Darexsh/mentoring_board_darexsh/Docs/Konzept_Hardware.md

### Konzept des Hardware-Teils des ESP32-S3-Mentoring-Board-Projekts

#### Zielsetzung
Die Hardware des ESP32-S3-Mentoring-Boards verfolgt das Ziel, eine umfassende und vielseitige Plattform zu schaffen, die Lernenden, Hobbyisten und Entwicklern ermöglicht, praktische Erfahrungen in der Mikrocontroller-Programmierung, Sensorintegration und Hardware-Software-Interaktion zu sammeln. Sie soll nicht nur als Lernwerkzeug dienen, sondern auch als Grundlage für die Entwicklung von Prototypen und realen Anwendungen. Dabei steht die Balance zwischen Einfachheit für Einsteiger und Flexibilität für fortgeschrittene Nutzer im Vordergrund. Die Hardware soll:
- Ein tiefes Verständnis für die Funktionsweise von Mikrocontrollern und Peripheriegeräten fördern,
- Eine Plattform für Experimente mit verschiedenen Sensoren und Aktoren bieten,
- Die Entwicklung von kreativen und funktionalen Projekten ermöglichen, die über den Lernkontext hinausgehen.

#### Kernidee
Die Kernidee der Hardware ist es, eine interaktive, flexible und robuste Umgebung zu schaffen, die eine Vielzahl von Komponenten integriert und gleichzeitig eine hohe Anpassungsfähigkeit bietet:
1. **Vielfalt an Komponenten**: Das Board umfasst eine breite Palette von Eingabegeräten (Taster, Taktschalter, Joystick, Encoder, Potentiometer), Sensoren (VCNL4040 für Näherung und Umgebungslicht, BNO085 für 9-Achsen-Bewegungsverfolgung, ADS1015 für analoge Messungen) und Ausgabekomponenten (WS2812B-LEDs, grüne LEDs). Diese Vielfalt ermöglicht es, unterschiedliche Aspekte der Mikrocontroller-Programmierung zu erkunden.
2. **Modularität und Unabhängigkeit**: Jede Komponente ist so gestaltet, dass sie unabhängig voneinander genutzt werden kann. Beispielsweise kann der Joystick für ein Projekt verwendet werden, ohne dass der BNO085-Sensor aktiviert sein muss. Dies reduziert die Komplexität für Anfänger und erlaubt es Fortgeschrittenen, gezielt bestimmte Funktionen zu kombinieren.
3. **Zuverlässigkeit und Schutz**: Die Hardware ist mit Schutzmechanismen ausgestattet, um eine stabile und sichere Funktion zu gewährleisten. Sicherungen (FUSE-3.15A) schützen vor Überstrom, ESD-Dioden (ESD5Z3.3) verhindern Schäden durch elektrostatische Entladung, und Entkopplungskondensatoren (z. B. 100 nF an jedem Sensor) minimieren Störungen und sorgen für eine stabile Spannungsversorgung.
4. **Schnittstellenvielfalt**: Das Board unterstützt mehrere Schnittstellen wie I²C (für Sensoren), SPI (für die SD-Karte), USB-C (für Stromversorgung und Daten) und JTAG (für Debugging). Diese Vielfalt ermöglicht es, verschiedene Kommunikationsprotokolle zu erlernen und anzuwenden.

#### Pädagogischer Ansatz
Die Hardware ist speziell darauf ausgelegt, Lernprozesse in verschiedenen Phasen zu unterstützen:
- **Einfacher Einstieg für Anfänger**:
  - Komponenten wie Taster (BTN1, BTN2) und Taktschalter (SW1, SW2) bieten eine intuitive Möglichkeit, grundlegende digitale Signale zu verstehen. Beispielsweise kann ein Anfänger lernen, wie man einen Taster abfragt und eine LED (z. B. die grünen LEDs, die mit BTN1 und BTN2 verbunden sind) ein- oder ausschaltet.
  - Die Potentiometer (POTI1, POTI2) ermöglichen erste Erfahrungen mit analogen Signalen, indem sie eine variable Spannung zwischen 0 und 3,3 V liefern, die direkt über GPIO oder den ADS1015 ausgelesen werden kann.
- **Fortgeschrittene Anwendungen für erfahrene Nutzer**:
  - Sensoren wie der BNO085 (9-Achsen-Sensor) bieten die Möglichkeit, komplexe Bewegungsverfolgung zu implementieren. Lernende können beispielsweise die Quaternion-Daten des Sensors nutzen, um die Orientierung eines Objekts in 3D zu bestimmen.
  - Der VCNL4040-Sensor erlaubt die Messung von Näherung und Umgebungslicht, was für Projekte wie automatische Beleuchtungssteuerung oder Hinderniserkennung genutzt werden kann.
  - Der ADS1015 (4-Kanal-ADC) erweitert die Möglichkeiten der analogen Messung, indem er präzise Messungen von mehreren analogen Signalen (z. B. POTI1) ermöglicht.
- **Praktische Erfahrung durch Interaktion**:
  - Die Hardware ist so gestaltet, dass sie direkt mit der Software interagieren kann. Beispielsweise können die WS2812B-LEDs verwendet werden, um visuelle Rückmeldungen zu geben (z. B. ein Regenbogeneffekt oder eine Anzeige der Encoder-Position).
  - Die SD-Karte ermöglicht das Speichern von Sensordaten, was Lernende dazu anregt, Datenlogging-Techniken zu erlernen und anzuwenden.
- **Fehlerdiagnose und Debugging**:
  - Die Hardware unterstützt Debugging durch den JTAG-Anschluss, der es ermöglicht, den Mikrocontroller auf niedriger Ebene zu analysieren.
  - Schutzmechanismen wie Sicherungen und ESD-Dioden helfen, typische Fehler (z. B. Kurzschlüsse) zu vermeiden, sodass Lernende sich auf die Programmierung konzentrieren können.

#### Technische Vision
Die Hardware des ESP32-S3-Mentoring-Boards soll eine Grundlage für eine Vielzahl von Anwendungen bieten, die sowohl im Lernkontext als auch in realen Projekten genutzt werden können:
- **Interaktive Projekte**:
  - Die WS2812B-LEDs (12 Stück) und der Encoder können für interaktive Lichtinstallationen genutzt werden. Beispielsweise könnte der Encoder die Farbe oder Helligkeit der LEDs steuern, um dynamische Lichtmuster zu erzeugen, die auf Benutzerinteraktionen reagieren.
  - Die grünen LEDs, die mit den Tastern (BTN1, BTN2) verbunden sind, können als einfache Statusanzeigen in Projekten dienen, z. B. um den Zustand eines Systems (ein/aus) anzuzeigen.
- **Datenlogging und Langzeitmessungen**:
  - Die SD-Karte ermöglicht die Speicherung von Sensordaten für Langzeitmessungen. Ein Beispielprojekt könnte die kontinuierliche Aufzeichnung von Umgebungslichtwerten (VCNL4040) oder Bewegungsdaten (BNO085) sein, die später auf einem Computer analysiert werden.
  - Die SD-Karte könnte auch für Protokollierungsanwendungen genutzt werden, z. B. um Fehlerereignisse oder Benutzerinteraktionen (z. B. Tasterdrücke) zu speichern.
- **Bewegungsverfolgung und Robotik**:
  - Der BNO085-Sensor liefert präzise Rotations- und Bewegungsdaten (Quaternion-Daten), die in Robotikprojekten oder Navigationssystemen verwendet werden können. Ein mögliches Projekt wäre die Entwicklung eines Stabilisierungssystems für einen Roboter, das die Orientierung in Echtzeit korrigiert.
  - Der Joystick kann als Steuerungselement für Roboter oder ferngesteuerte Fahrzeuge dienen, wobei die X/Y-Achsen die Bewegungsrichtung und der Taster (JOY_BTN) eine Aktion (z. B. Stopp) auslöst.
- **Umgebungsüberwachung**:
  - Der VCNL4040-Sensor kann für Projekte zur Umgebungsüberwachung eingesetzt werden, z. B. eine automatische Beleuchtungssteuerung, die die Helligkeit der WS2812B-LEDs basierend auf dem Umgebungslicht anpasst.
  - Der Näherungssensor des VCNL4040 könnte in einem Hinderniserkennungssystem verwendet werden, z. B. um einen Alarm auszulösen, wenn ein Objekt zu nahe kommt.
- **Erweiterbarkeit**:
  - Die Hardware unterstützt die Integration weiterer Komponenten über I²C (z. B. ein OLED-Display zur Anzeige von Sensordaten) oder GPIO (z. B. zusätzliche Sensoren wie Temperatur- oder Luftfeuchtigkeitssensoren).
  - Der ESP32-S3 bietet Wi-Fi- und Bluetooth-Funktionen, die in zukünftigen Projekten genutzt werden könnten, z. B. um Sensordaten an eine Cloud-Plattform zu senden oder das Board über eine Smartphone-App zu steuern.
- **Prototypenentwicklung**:
  - Die Hardware kann als Basis für die Entwicklung von Prototypen dienen, z. B. für ein interaktives Spiel, bei dem der Joystick und die Taster als Eingaben und die WS2812B-LEDs als visuelle Ausgaben verwendet werden.
  - Ein weiteres Beispiel wäre ein tragbares Gerät zur Bewegungsverfolgung, das die Daten des BNO085-Sensors auf der SD-Karte speichert und später zur Analyse ausliest.

#### Langfristige Perspektive
Die Hardware des ESP32-S3-Mentoring-Boards könnte als Grundlage für eine breitere Community-Initiative dienen:
- **Bildungsprogramme**: Das Board eignet sich ideal für Workshops, Schulungen oder Universitätskurse, bei denen Teilnehmer Mikrocontroller-Programmierung, Sensorintegration und Prototypenentwicklung erlernen. Beispielsweise könnte ein Kursprojekt die Entwicklung eines Systems zur Überwachung von Umgebungslicht und Bewegung umfassen, das die Daten auf der SD-Karte speichert.
- **Erweiterte Anwendungen**: Mit der Integration von Netzwerkfunktionen (Wi-Fi/Bluetooth) könnte das Board für IoT-Anwendungen genutzt werden, z. B. zur Übertragung von Sensordaten an eine Cloud-Plattform oder zur Steuerung über eine Smartphone-App. Ein mögliches Projekt wäre ein Smart-Home-System, das die Beleuchtung (WS2812B-LEDs) basierend auf Näherungsdaten (VCNL4040) steuert.
- **Labor-Beiträge**: Studenten, SHKs, Bachelor- oder Masteranden könnten Tutorials, Beispielprojekte und Erweiterungen (z. B. neue Sensoren oder Aktoren) entwickeln, um die Nutzung des Boards weiter zu fördern.

#### Fazit
Die Hardware des ESP32-S3-Mentoring-Boards bietet eine solide und vielseitige Grundlage für Lern- und Entwicklungsprojekte. Sie kombiniert eine breite Palette von Komponenten mit einer robusten und erweiterbaren Architektur, um sowohl Anfängern als auch Fortgeschrittenen eine Plattform für kreative und technische Experimente zu bieten. Durch ihre Flexibilität und die Möglichkeit zur Integration in größere Systeme (z. B. IoT) hat die Hardware das Potenzial, weit über den Lernkontext hinaus genutzt zu werden und innovative Projekte zu ermöglichen.
