Darexsh/mentoring_board_darexsh/Docs/Konzept.md

### Konzept des Software-Teils des ESP32-S3-Mentoring-Board-Projekts

#### Zielsetzung
Das Software-Projekt für den ESP32-S3-Mikrocontroller zielt darauf ab, eine vielseitige, anpassbare und lehrreiche Plattform zu schaffen, die sich an ein breites Spektrum von Nutzern richtet – von Einsteigern, die ihre ersten Schritte in der Mikrocontroller-Programmierung machen, bis hin zu erfahrenen Entwicklern, die komplexe Prototypen entwickeln möchten. Die Software soll eine praxisnahe Umgebung bieten, in der die Funktionsweise von Mikrocontrollern, Sensoren und Aktoren erlernt und verstanden werden kann. Gleichzeitig soll sie als Grundlage für die Entwicklung von realen Anwendungen dienen, die über den Lernkontext hinausgehen. Die Hauptziele sind:
- **Bildung und Lernen**: Nutzern die Grundlagen der Mikrocontroller-Programmierung und Hardware-Interaktion näherbringen.
- **Flexibilität**: Eine anpassbare Plattform bieten, die sowohl einfache als auch komplexe Projekte unterstützt.
- **Prototypenentwicklung**: Eine Basis schaffen, die für die Entwicklung von funktionalen Prototypen und realen Anwendungen genutzt werden kann.
- **Förderung von Kreativität**: Nutzern die Möglichkeit geben, kreative Projekte zu entwickeln, indem sie verschiedene Hardwarekomponenten kombinieren und steuern.

#### Kernidee
Die Kernidee der Software ist es, eine modulare und flexible Umgebung zu schaffen, die es Nutzern ermöglicht, verschiedene Hardwarekomponenten des ESP32-S3-Mentoring-Boards unabhängig voneinander zu aktivieren, zu testen und zu kombinieren. Dies wird durch die Verwendung von Makros in der Datei `select_sensory.h` realisiert, die eine einfache Anpassung des Funktionsumfangs ohne tiefgreifende Code-Änderungen ermöglichen. Die Software soll eine Sandbox-ähnliche Umgebung bieten, in der Benutzer:
1. **Grundlagen der Mikrocontroller-Programmierung erlernen**: Anfänger können einfache Funktionen wie das Auslesen von Tastern oder das Steuern von LEDs nutzen, um grundlegende Konzepte wie digitale Ein-/Ausgänge und Schleifen zu verstehen.
2. **Experimentieren und vertiefen**: Nutzer können schrittweise komplexere Systeme wie den BNO085-Sensor (9-Achsen-Bewegungsverfolgung) oder den VCNL4040 (Näherungs- und Umgebungslichtsensor) integrieren, um fortgeschrittene Konzepte wie I²C-Kommunikation und Sensordatenverarbeitung zu erlernen.
3. **Praxisbezug durch Rückmeldungen**: Die Software bietet direkte Rückmeldungen durch serielle Ausgaben, visuelle Anzeigen (z. B. WS2812B-LEDs) und ein optionales OLED-Display, um die Auswirkungen von Code und Hardwareinteraktionen sofort sichtbar zu machen.
4. **Erweiterbarkeit für eigene Projekte**: Die klare Struktur und die Modularität der Software ermöglichen es, neue Funktionen oder Hardwarekomponenten leicht zu integrieren, sodass Nutzer ihre eigenen Projekte entwickeln können.

#### Pädagogischer Ansatz
Die Software ist darauf ausgelegt, Lernprozesse in verschiedenen Phasen zu unterstützen und dabei sowohl Anfängern als auch Fortgeschrittenen gerecht zu werden:
- **Flexibilität für unterschiedliche Lernstufen**:
  - **Anfänger**: Durch die modulare Struktur können Anfänger mit einfachen Komponenten wie Tastern (`PUSH_BUTTONS_SIMPLE`) oder Taktschaltern (`TACTILE_SWITCHES_SIMPLE`) beginnen. Beispielsweise können sie lernen, wie man den Zustand eines Tasters abfragt und eine serielle Ausgabe generiert, um den Zustand (gedrückt/nicht gedrückt) zu überprüfen.
  - **Fortgeschrittene**: Erfahrene Nutzer können komplexere Sensoren wie den BNO085 (`BNO085_SIMPLE`) oder den VCNL4040 (`VCNL4040_SIMPLE`) nutzen, um fortgeschrittene Anwendungen zu entwickeln, z. B. die Berechnung der Orientierung eines Objekts in 3D oder die Steuerung von LEDs basierend auf Umgebungslichtwerten.
- **Interaktivität und visuelle Rückmeldung**:
  - Die Software unterstützt visuelle Rückmeldungen durch die WS2812B-LEDs (`RAINBOW_WS2812`), die z. B. einen Regenbogeneffekt anzeigen oder die Position eines Encoders (`ENCODER_WITH_WS2812`) visualisieren können. Dies hilft Lernenden, die Auswirkungen ihres Codes direkt zu sehen.
  - Ein optionales OLED-Display (`OLED_SIMPLE`) kann verwendet werden, um Sensordaten oder Statusmeldungen anzuzeigen, z. B. die aktuellen Werte des VCNL4040-Sensors.
  - Serielle Ausgaben ermöglichen eine detaillierte Analyse von Sensordaten oder Eingaben, z. B. die X/Y-Werte des Joysticks (`READ_JOYSTICK`) oder die Rotationsvektoren des BNO085.
- **Erweiterbarkeit für individuelle Projekte**:
  - Die klare Struktur der Software, bei der jede Funktion in einer eigenen Methode gekapselt ist (z. B. `readVCNL4040()`, `setRainbow()`), erleichtert die Integration neuer Sensoren oder Funktionen. Ein Nutzer könnte beispielsweise einen Temperatursensor hinzufügen und eine neue Methode `readTemperature()` erstellen, die ähnlich wie die bestehenden Funktionen in die `loop()`-Funktion integriert wird.
- **Fehlerdiagnose und Debugging**:
  - Initialisierungsfunktionen wie `initializeI2Csensory()` enthalten Fehlerprüfungen, die serielle Fehlermeldungen ausgeben, wenn ein I²C-Sensor nicht gefunden wird. Dies hilft Lernenden, Debugging-Techniken zu erlernen, z. B. die Überprüfung von I²C-Adressen oder Verbindungen.
  - Die Software unterstützt Interrupts (z. B. für den Encoder mit `encoderISR()`), was Lernende dazu anregt, sich mit fortgeschrittenen Programmierkonzepten wie Interrupt-Service-Routinen auseinanderzusetzen.

#### Technische Vision
Die Software soll nicht nur ein Lernwerkzeug sein, sondern auch als Basis für praktische Anwendungen dienen, die über den Bildungskontext hinausgehen. Sie ist so gestaltet, dass sie sowohl einfache als auch komplexe Projekte unterstützt und gleichzeitig die Grundlage für zukünftige Erweiterungen bietet:
- **Beispiele für Anwendungen**:
  - **Beleuchtungssteuerung**: Der WS2812-Encoder (`ENCODER_WITH_WS2812`) könnte für dynamische Lichtinstallationen genutzt werden. Ein Nutzer könnte die Farbe oder Helligkeit der LEDs basierend auf der Encoder-Position steuern, z. B. um eine interaktive Lichtshow zu erstellen, die auf Benutzerinteraktionen reagiert.
  - **Datenlogging**: Die SD-Kartenfunktion (`SD_CARD_SIMPLE`) ermöglicht Langzeitaufzeichnungen von Sensordaten. Ein Beispielprojekt könnte die kontinuierliche Aufzeichnung von Umgebungslichtwerten (VCNL4040) oder Bewegungsdaten (BNO085) sein, die später auf einem Computer analysiert werden, z. B. um Bewegungsmuster zu studieren oder Lichtverhältnisse zu überwachen.
  - **Robotik und Bewegungsverfolgung**: Der BNO085-Sensor (`BNO085_SIMPLE`) liefert präzise Rotationsvektoren, die in Navigationssystemen oder Robotikprojekten verwendet werden können. Ein mögliches Projekt wäre die Entwicklung eines Stabilisierungssystems für einen Roboter, das die Orientierung in Echtzeit korrigiert.
  - **Interaktive Geräte und Spiele**: Der Joystick (`READ_JOYSTICK`) und die Taster (`PUSH_BUTTONS_SIMPLE`) könnten als Eingaben für Spiele oder Steuerungen dienen. Ein Beispiel wäre ein einfaches Spiel, bei dem der Joystick die Bewegung eines Objekts steuert und die Taster Aktionen wie "Springen" oder "Schießen" auslösen, während die WS2812B-LEDs den Spielstatus anzeigen.
  - **Umgebungsüberwachung**: Der VCNL4040-Sensor (`VCNL4040_SIMPLE`) kann für Projekte zur Umgebungsüberwachung genutzt werden, z. B. eine automatische Beleuchtungssteuerung, die die Helligkeit der WS2812B-LEDs basierend auf dem Umgebungslicht anpasst.
- **Skalierbarkeit und Erweiterung**:
  - Die klare Struktur der Software ermöglicht die Integration weiterer Sensoren oder komplexerer Algorithmen. Beispielsweise könnte ein Nutzer einen Temperatur- oder Luftfeuchtigkeitssensor hinzufügen und die Daten mit der bestehenden SD-Kartenfunktion speichern.
  - Die Software könnte um Netzwerkfunktionen (Wi-Fi/Bluetooth) erweitert werden, um IoT-Anwendungen zu ermöglichen, z. B. die Übertragung von Sensordaten an eine Cloud-Plattform oder die Steuerung des Boards über eine Smartphone-App.
- **Optimierung und Performance**:
  - Die Verwendung von Interrupts (z. B. für den Encoder) sorgt für eine effiziente Verarbeitung von Ereignissen, was besonders bei zeitkritischen Anwendungen wie Bewegungsverfolgung oder Echtzeitsteuerung wichtig ist.
  - Die Software könnte in Zukunft um Multithreading- oder Task-Management-Funktionen erweitert werden, um die Leistung des ESP32-S3 (Dual-Core) besser auszuschöpfen, z. B. durch die Verwendung des FreeRTOS-Betriebssystems.

#### Umsetzung der Idee
Die Software ist so gestaltet, dass sie die Hardware des ESP32-S3-Mentoring-Boards optimal nutzt und gleichzeitig benutzerfreundlich bleibt:
- **Modularität**:
  - Jede Funktion ist in einer eigenen Methode gekapselt (z. B. `readJoystick()`, `setRainbow()`), was die Wartung und Erweiterung erleichtert. Ein Nutzer kann leicht eine neue Funktion hinzufügen, indem er eine neue Methode erstellt und sie in die `loop()`-Funktion integriert.
  - Die Makros in `select_sensory.h` (z. B. `PUSH_BUTTONS_SIMPLE`, `BNO085_SIMPLE`) ermöglichen es, Funktionen ein- oder auszuschalten, ohne den Hauptcode zu ändern.
- **Hardwarevielfalt**:
  - Die Software unterstützt eine breite Palette von Hardwarekomponenten, darunter digitale Eingaben (Taster, Taktschalter), analoge Eingaben (Potentiometer, Joystick), Sensoren (VCNL4040, BNO085, ADS1015), Ausgaben (WS2812B-LEDs, OLED) und Speicher (SD-Karte). Dies zeigt die Vielseitigkeit des ESP32-S3 und bietet Nutzern zahlreiche Möglichkeiten zur Interaktion.
- **Benutzerfreundlichkeit**:
  - Klare Pin-Definitionen in `pinConfig_mentoringBoard.h` (z. B. `BTN1 = 15`, `SDA = 14`) reduzieren die Einstiegshürde, da Nutzer nicht selbst die Pin-Belegung herausfinden müssen.
  - Die serielle Ausgabe von Sensordaten und Statusmeldungen erleichtert das Debugging und die Analyse, z. B. durch die Ausgabe der Joystick-Werte oder der Encoder-Position.
- **Effiziente Nutzung von Ressourcen**:
  - Die Software nutzt Interrupts für zeitkritische Aufgaben wie die Verarbeitung von Encoder-Drehungen (`encoderISR()`), was die Reaktionszeit verbessert.
  - Die Verwendung von Bibliotheken wie `NeoPixelBus.h` für die WS2812B-LEDs oder `Adafruit_BNO08x.h` für den BNO085-Sensor sorgt für eine effiziente und zuverlässige Kommunikation mit der Hardware.

#### Langfristige Perspektive
Die Software hat das Potenzial, als Grundlage für weitere Projekte zu dienen und in verschiedenen Kontexten weiterentwickelt zu werden:
- **Weiterentwicklung durch Studenten und Entwickler**:
  - Das Projekt könnte von Studenten, wissenschaftlichen Hilfskräften (SHKs), Bachelor- oder Masteranden weiterentwickelt werden. Beispielsweise könnten Studenten neue Funktionen hinzufügen, wie die Unterstützung für einen Temperatursensor oder die Implementierung eines Web-Interfaces zur Anzeige von Sensordaten.
  - Ein Masterand könnte die Software um ein Machine-Learning-Modell erweitern, das Bewegungsdaten des BNO085-Sensors analysiert, um Muster zu erkennen (z. B. Gestenerkennung).
- **Bildungsprogramme und Workshops**:
  - Die Software eignet sich ideal für Workshops, Schulungen oder Universitätskurse, bei denen Teilnehmer Mikrocontroller-Programmierung und Sensorintegration erlernen. Ein Beispielworkshop könnte die Entwicklung eines Systems zur Überwachung von Umgebungslicht (VCNL4040) und Bewegung (BNO085) umfassen, das die Daten auf der SD-Karte speichert und auf dem OLED-Display anzeigt.
  - Tutorials und Beispielprojekte könnten erstellt werden, um die Nutzung der Software zu erleichtern, z. B. ein Tutorial zur Erstellung eines interaktiven Spiels mit dem Joystick und den WS2812B-LEDs.
- **Integration von Netzwerkfunktionen (IoT)**:
  - Die nächste Entwicklungsstufe könnte die Integration von Wi-Fi- und Bluetooth-Funktionen des ESP32-S3 sein, um IoT-Anwendungen zu ermöglichen. Ein mögliches Projekt wäre ein Smart-Home-System, das die Beleuchtung (WS2812B-LEDs) basierend auf Näherungsdaten (VCNL4040) steuert und die Daten an eine Cloud-Plattform sendet.
  - Eine Smartphone-App könnte entwickelt werden, um das Board zu steuern, z. B. um die Farbe der LEDs zu ändern oder Sensordaten in Echtzeit anzuzeigen.

___________

### Konzept des Hardware-Teils des ESP32-S3-Mentoring-Board-Projekts

#### Zielsetzung
Die Hardware des ESP32-S3-Mentoring-Boards verfolgt das Ziel, eine umfassende und vielseitige Plattform zu schaffen, die Lernenden, Hobbyisten und Entwicklern ermöglicht, praktische Erfahrungen in der Mikrocontroller-Programmierung, Sensorintegration und Hardware-Software-Interaktion zu sammeln. Sie soll nicht nur als Lernwerkzeug dienen, sondern auch als Grundlage für die Entwicklung von Prototypen und realen Anwendungen. Dabei steht die Balance zwischen Einfachheit für Einsteiger und Flexibilität für fortgeschrittene Nutzer im Vordergrund. Die Hardware soll:
- Ein tiefes Verständnis für die Funktionsweise von Mikrocontrollern und Peripheriegeräten fördern,
- Eine Plattform für Experimente mit verschiedenen Sensoren und Aktoren bieten,
- Die Entwicklung von kreativen und funktionalen Projekten ermöglichen, die über den Lernkontext hinausgehen.

#### Kernidee
Die Kernidee der Hardware ist es, eine interaktive, flexible und robuste Umgebung zu schaffen, die eine Vielzahl von Komponenten integriert und gleichzeitig eine hohe Anpassungsfähigkeit bietet:
1. **Vielfalt an Komponenten**: Das Board umfasst eine breite Palette von Eingabegeräten (Taster, Taktschalter, Joystick, Encoder, Potentiometer), Sensoren (VCNL4040 für Näherung und Umgebungslicht, BNO085 für 9-Achsen-Bewegungsverfolgung, ADS1015 für analoge Messungen) und Ausgabekomponenten (WS2812B-LEDs, grüne LEDs). Diese Vielfalt ermöglicht es, unterschiedliche Aspekte der Mikrocontroller-Programmierung zu erkunden.
2. **Modularität und Unabhängigkeit**: Jede Komponente ist so gestaltet, dass sie unabhängig voneinander genutzt werden kann. Beispielsweise kann der Joystick für ein Projekt verwendet werden, ohne dass der BNO085-Sensor aktiviert sein muss. Dies reduziert die Komplexität für Anfänger und erlaubt es Fortgeschrittenen, gezielt bestimmte Funktionen zu kombinieren.
3. **Zuverlässigkeit und Schutz**: Die Hardware ist mit Schutzmechanismen ausgestattet, um eine stabile und sichere Funktion zu gewährleisten. Sicherungen (FUSE-3.15A) schützen vor Überstrom, ESD-Dioden (ESD5Z3.3) verhindern Schäden durch elektrostatische Entladung, und Entkopplungskondensatoren (z. B. 100 nF an jedem Sensor) minimieren Störungen und sorgen für eine stabile Spannungsversorgung.
4. **Schnittstellenvielfalt**: Das Board unterstützt mehrere Schnittstellen wie I²C (für Sensoren), SPI (für die SD-Karte), USB-C (für Stromversorgung und Daten) und JTAG (für Debugging). Diese Vielfalt ermöglicht es, verschiedene Kommunikationsprotokolle zu erlernen und anzuwenden.

#### Pädagogischer Ansatz
Die Hardware ist speziell darauf ausgelegt, Lernprozesse in verschiedenen Phasen zu unterstützen:
- **Einfacher Einstieg für Anfänger**:
  - Komponenten wie Taster (BTN1, BTN2) und Taktschalter (SW1, SW2) bieten eine intuitive Möglichkeit, grundlegende digitale Signale zu verstehen. Beispielsweise kann ein Anfänger lernen, wie man einen Taster abfragt und eine LED (z. B. die grünen LEDs, die mit BTN1 und BTN2 verbunden sind) ein- oder ausschaltet.
  - Die Potentiometer (POTI1, POTI2) ermöglichen erste Erfahrungen mit analogen Signalen, indem sie eine variable Spannung zwischen 0 und 3,3 V liefern, die direkt über GPIO oder den ADS1015 ausgelesen werden kann.
- **Fortgeschrittene Anwendungen für erfahrene Nutzer**:
  - Sensoren wie der BNO085 (9-Achsen-Sensor) bieten die Möglichkeit, komplexe Bewegungsverfolgung zu implementieren. Lernende können beispielsweise die Quaternion-Daten des Sensors nutzen, um die Orientierung eines Objekts in 3D zu bestimmen.
  - Der VCNL4040-Sensor erlaubt die Messung von Näherung und Umgebungslicht, was für Projekte wie automatische Beleuchtungssteuerung oder Hinderniserkennung genutzt werden kann.
  - Der ADS1015 (4-Kanal-ADC) erweitert die Möglichkeiten der analogen Messung, indem er präzise Messungen von mehreren analogen Signalen (z. B. POTI1) ermöglicht.
- **Praktische Erfahrung durch Interaktion**:
  - Die Hardware ist so gestaltet, dass sie direkt mit der Software interagieren kann. Beispielsweise können die WS2812B-LEDs verwendet werden, um visuelle Rückmeldungen zu geben (z. B. ein Regenbogeneffekt oder eine Anzeige der Encoder-Position).
  - Die SD-Karte ermöglicht das Speichern von Sensordaten, was Lernende dazu anregt, Datenlogging-Techniken zu erlernen und anzuwenden.
- **Fehlerdiagnose und Debugging**:
  - Die Hardware unterstützt Debugging durch den JTAG-Anschluss, der es ermöglicht, den Mikrocontroller auf niedriger Ebene zu analysieren.
  - Schutzmechanismen wie Sicherungen und ESD-Dioden helfen, typische Fehler (z. B. Kurzschlüsse) zu vermeiden, sodass Lernende sich auf die Programmierung konzentrieren können.

#### Technische Vision
Die Hardware des ESP32-S3-Mentoring-Boards soll eine Grundlage für eine Vielzahl von Anwendungen bieten, die sowohl im Lernkontext als auch in realen Projekten genutzt werden können:
- **Interaktive Projekte**:
  - Die WS2812B-LEDs (12 Stück) und der Encoder können für interaktive Lichtinstallationen genutzt werden. Beispielsweise könnte der Encoder die Farbe oder Helligkeit der LEDs steuern, um dynamische Lichtmuster zu erzeugen, die auf Benutzerinteraktionen reagieren.
  - Die grünen LEDs, die mit den Tastern (BTN1, BTN2) verbunden sind, können als einfache Statusanzeigen in Projekten dienen, z. B. um den Zustand eines Systems (ein/aus) anzuzeigen.
- **Datenlogging und Langzeitmessungen**:
  - Die SD-Karte ermöglicht die Speicherung von Sensordaten für Langzeitmessungen. Ein Beispielprojekt könnte die kontinuierliche Aufzeichnung von Umgebungslichtwerten (VCNL4040) oder Bewegungsdaten (BNO085) sein, die später auf einem Computer analysiert werden.
  - Die SD-Karte könnte auch für Protokollierungsanwendungen genutzt werden, z. B. um Fehlerereignisse oder Benutzerinteraktionen (z. B. Tasterdrücke) zu speichern.
- **Bewegungsverfolgung und Robotik**:
  - Der BNO085-Sensor liefert präzise Rotations- und Bewegungsdaten (Quaternion-Daten), die in Robotikprojekten oder Navigationssystemen verwendet werden können. Ein mögliches Projekt wäre die Entwicklung eines Stabilisierungssystems für einen Roboter, das die Orientierung in Echtzeit korrigiert.
  - Der Joystick kann als Steuerungselement für Roboter oder ferngesteuerte Fahrzeuge dienen, wobei die X/Y-Achsen die Bewegungsrichtung und der Taster (JOY_BTN) eine Aktion (z. B. Stopp) auslöst.
- **Umgebungsüberwachung**:
  - Der VCNL4040-Sensor kann für Projekte zur Umgebungsüberwachung eingesetzt werden, z. B. eine automatische Beleuchtungssteuerung, die die Helligkeit der WS2812B-LEDs basierend auf dem Umgebungslicht anpasst.
  - Der Näherungssensor des VCNL4040 könnte in einem Hinderniserkennungssystem verwendet werden, z. B. um einen Alarm auszulösen, wenn ein Objekt zu nahe kommt.
- **Erweiterbarkeit**:
  - Die Hardware unterstützt die Integration weiterer Komponenten über I²C (z. B. ein OLED-Display zur Anzeige von Sensordaten) oder GPIO (z. B. zusätzliche Sensoren wie Temperatur- oder Luftfeuchtigkeitssensoren).
  - Der ESP32-S3 bietet Wi-Fi- und Bluetooth-Funktionen, die in zukünftigen Projekten genutzt werden könnten, z. B. um Sensordaten an eine Cloud-Plattform zu senden oder das Board über eine Smartphone-App zu steuern.
- **Prototypenentwicklung**:
  - Die Hardware kann als Basis für die Entwicklung von Prototypen dienen, z. B. für ein interaktives Spiel, bei dem der Joystick und die Taster als Eingaben und die WS2812B-LEDs als visuelle Ausgaben verwendet werden.
  - Ein weiteres Beispiel wäre ein tragbares Gerät zur Bewegungsverfolgung, das die Daten des BNO085-Sensors auf der SD-Karte speichert und später zur Analyse ausliest.

#### Langfristige Perspektive
Die Hardware des ESP32-S3-Mentoring-Boards könnte als Grundlage für eine breitere Community-Initiative dienen:
- **Bildungsprogramme**: Das Board eignet sich ideal für Workshops, Schulungen oder Universitätskurse, bei denen Teilnehmer Mikrocontroller-Programmierung, Sensorintegration und Prototypenentwicklung erlernen. Beispielsweise könnte ein Kursprojekt die Entwicklung eines Systems zur Überwachung von Umgebungslicht und Bewegung umfassen, das die Daten auf der SD-Karte speichert.
- **Erweiterte Anwendungen**: Mit der Integration von Netzwerkfunktionen (Wi-Fi/Bluetooth) könnte das Board für IoT-Anwendungen genutzt werden, z. B. zur Übertragung von Sensordaten an eine Cloud-Plattform oder zur Steuerung über eine Smartphone-App. Ein mögliches Projekt wäre ein Smart-Home-System, das die Beleuchtung (WS2812B-LEDs) basierend auf Näherungsdaten (VCNL4040) steuert.
- **Labor-Beiträge**: Studenten, SHKs, Bachelor- oder Masteranden könnten Tutorials, Beispielprojekte und Erweiterungen (z. B. neue Sensoren oder Aktoren) entwickeln, um die Nutzung des Boards weiter zu fördern.
