Darexsh/mentoring_board_darexsh/Docs/V1.0a.png

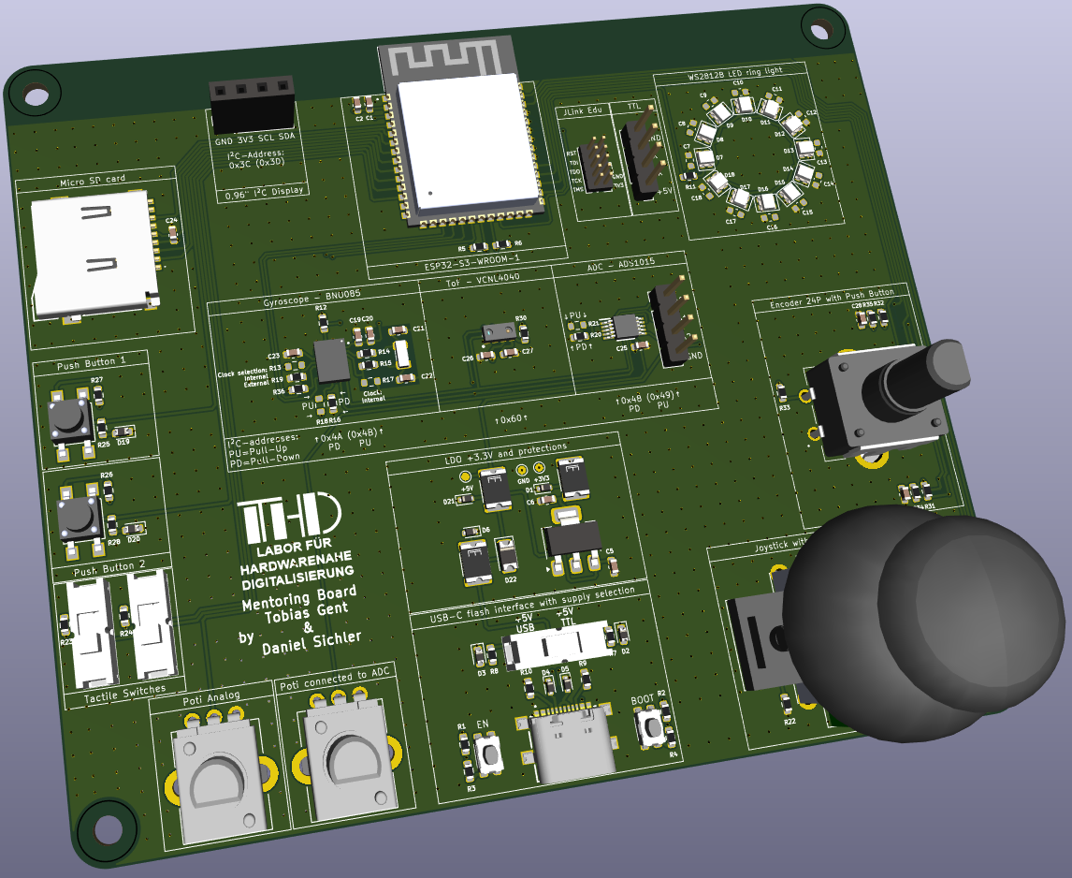
Docs/V1.0a.png
