Darexsh/mentoring_board_darexsh/Docs/V1.0b.png

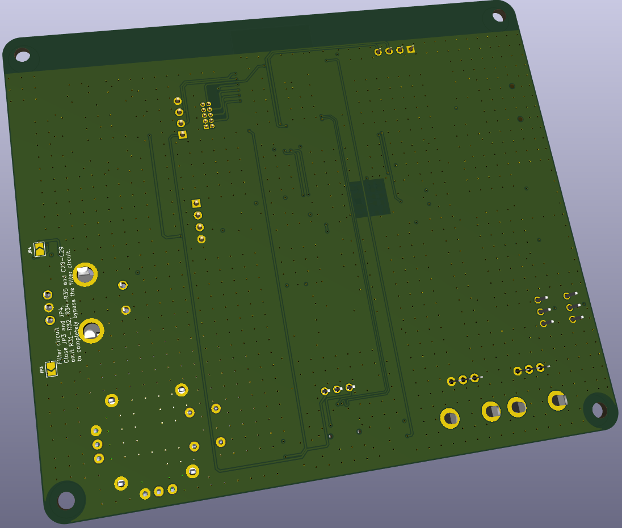
Docs/V1.0b.png
