Darexsh/mentoring_board_darexsh/Hardware/Lib-3D-Files/1812L110PRT.stp

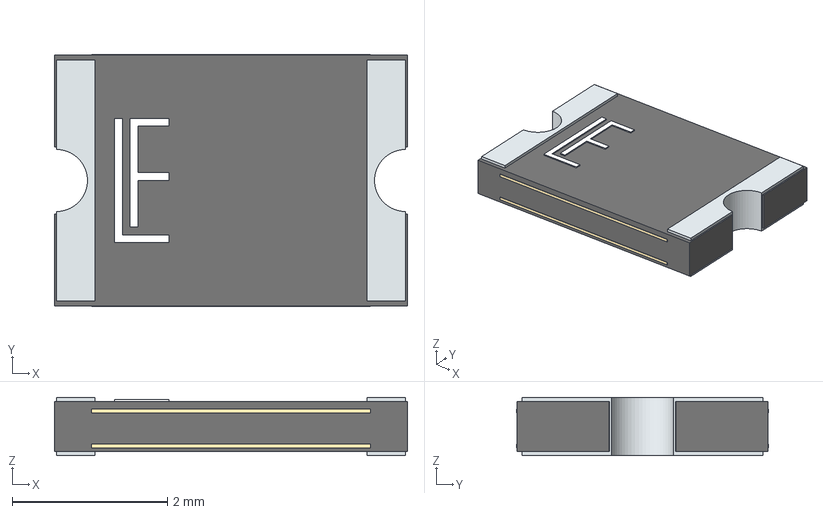
[picture p5: CAD file, 2026-02-02]
Hardware/Lib-3D-Files/1812L110PRT.stp
4.55 x 3.25 x 0.75 mm
Intersect
Terminal
solidWriting
