Darexsh/mentoring_board_darexsh/Docs/Aufbau_V1.0.jpg

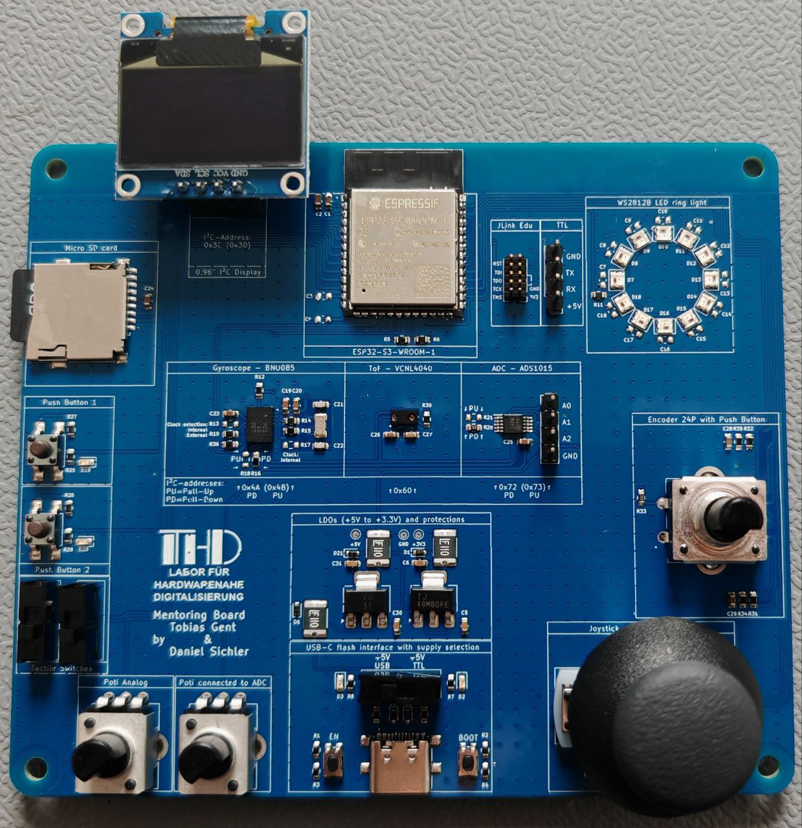
Docs/Aufbau_V1.0.jpg
