Darexsh/mentoring_board_darexsh/Docs/Project_schematics.pdf

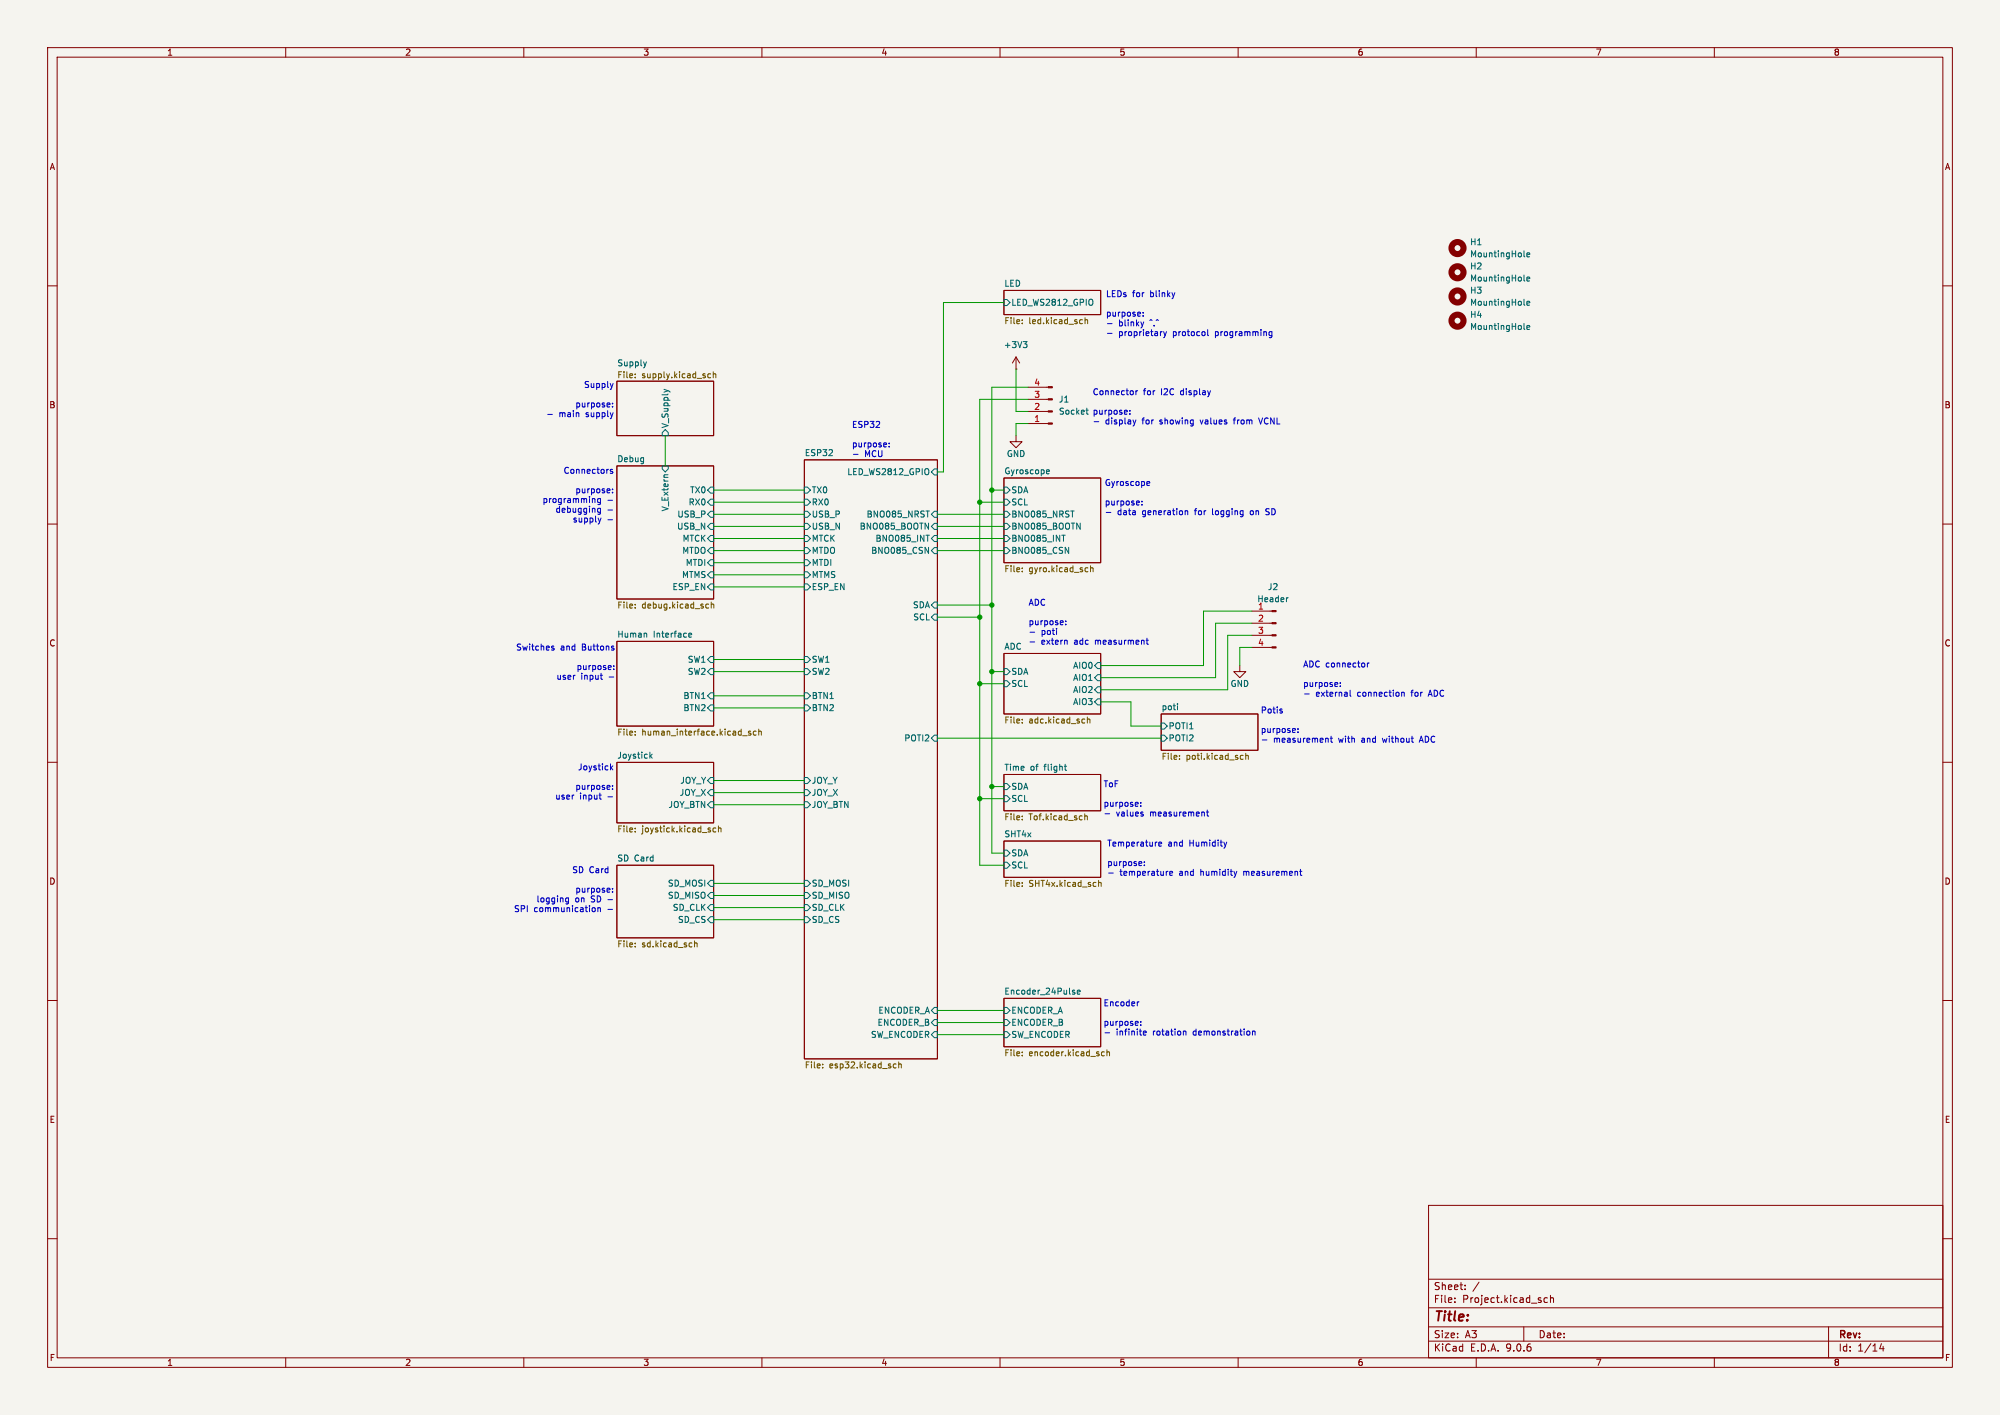
[picture p7: page 1]

LED
SW_ENCODER MTMS RX0 TX0 MTDI MTDO MTCK
BNO085_NRST BNO085_INT SW1 SW2 BTN1 SD_CS
Joystick File: joystick.kicad_sch SW1 BTN1 SW2 BTN2 Human Interface File: human_interface.kicad_sch SD_CS
Switches and Buttons purpose: user input - SD Card

LEDs for blinky purpose: - blinky ^.^

Supply purpose: - main supply

poti File: poti.kicad_sch RX0 TX0 USB_P USB_N MTDI MTDO MTCK MTMS V_Extern ESP_EN

purpose: - poti - extern adc measurment ToF

SCL Time of flight File: Tof.kicad_sch SDA

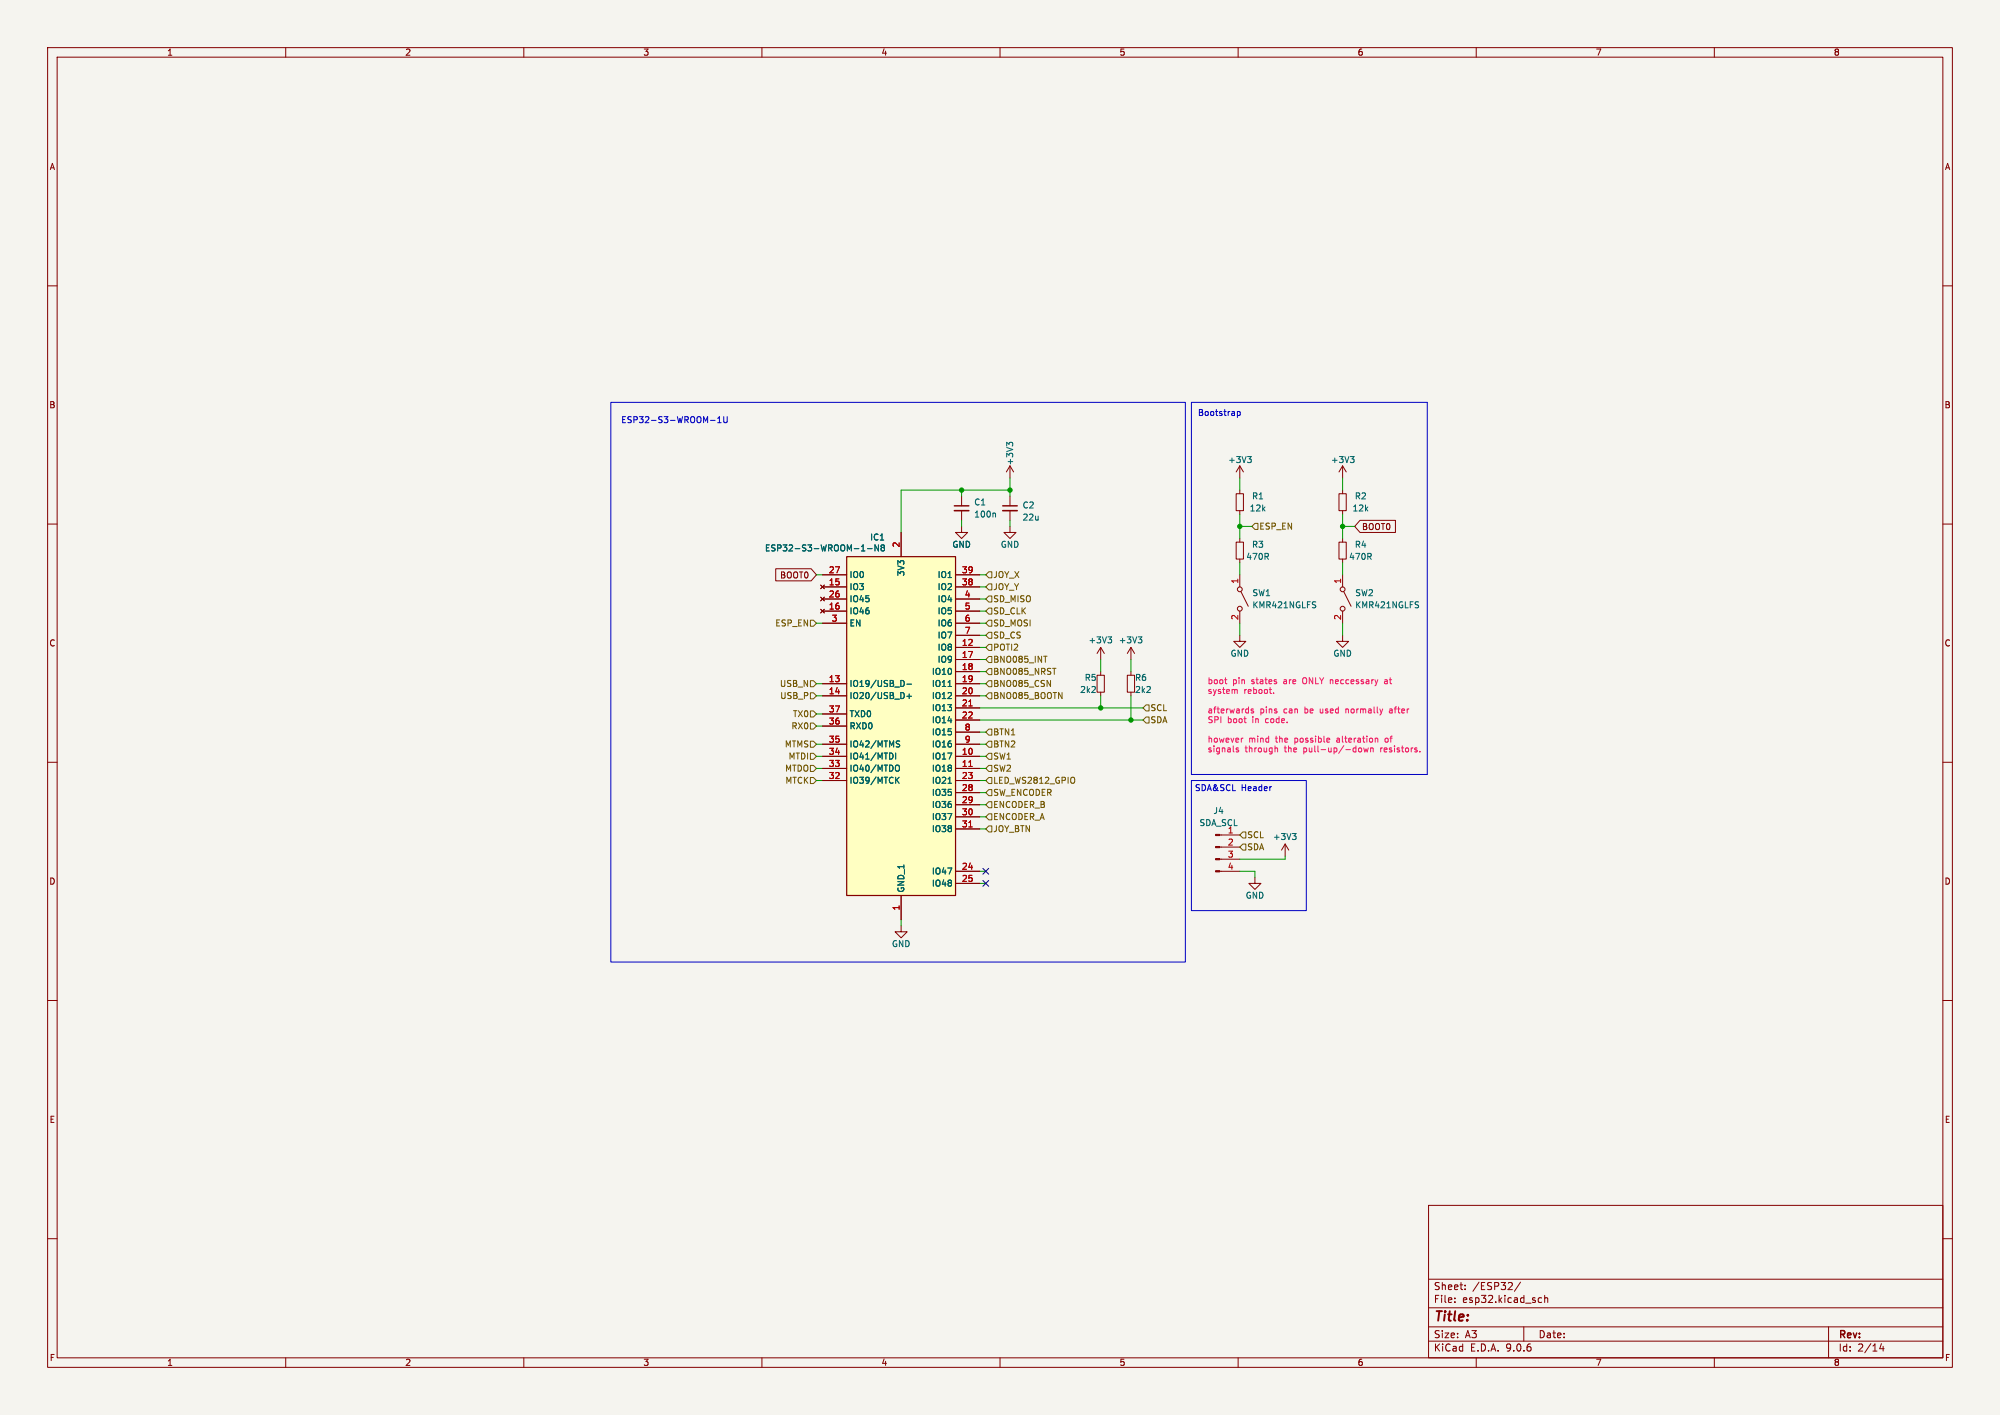
[picture p8: page 2]

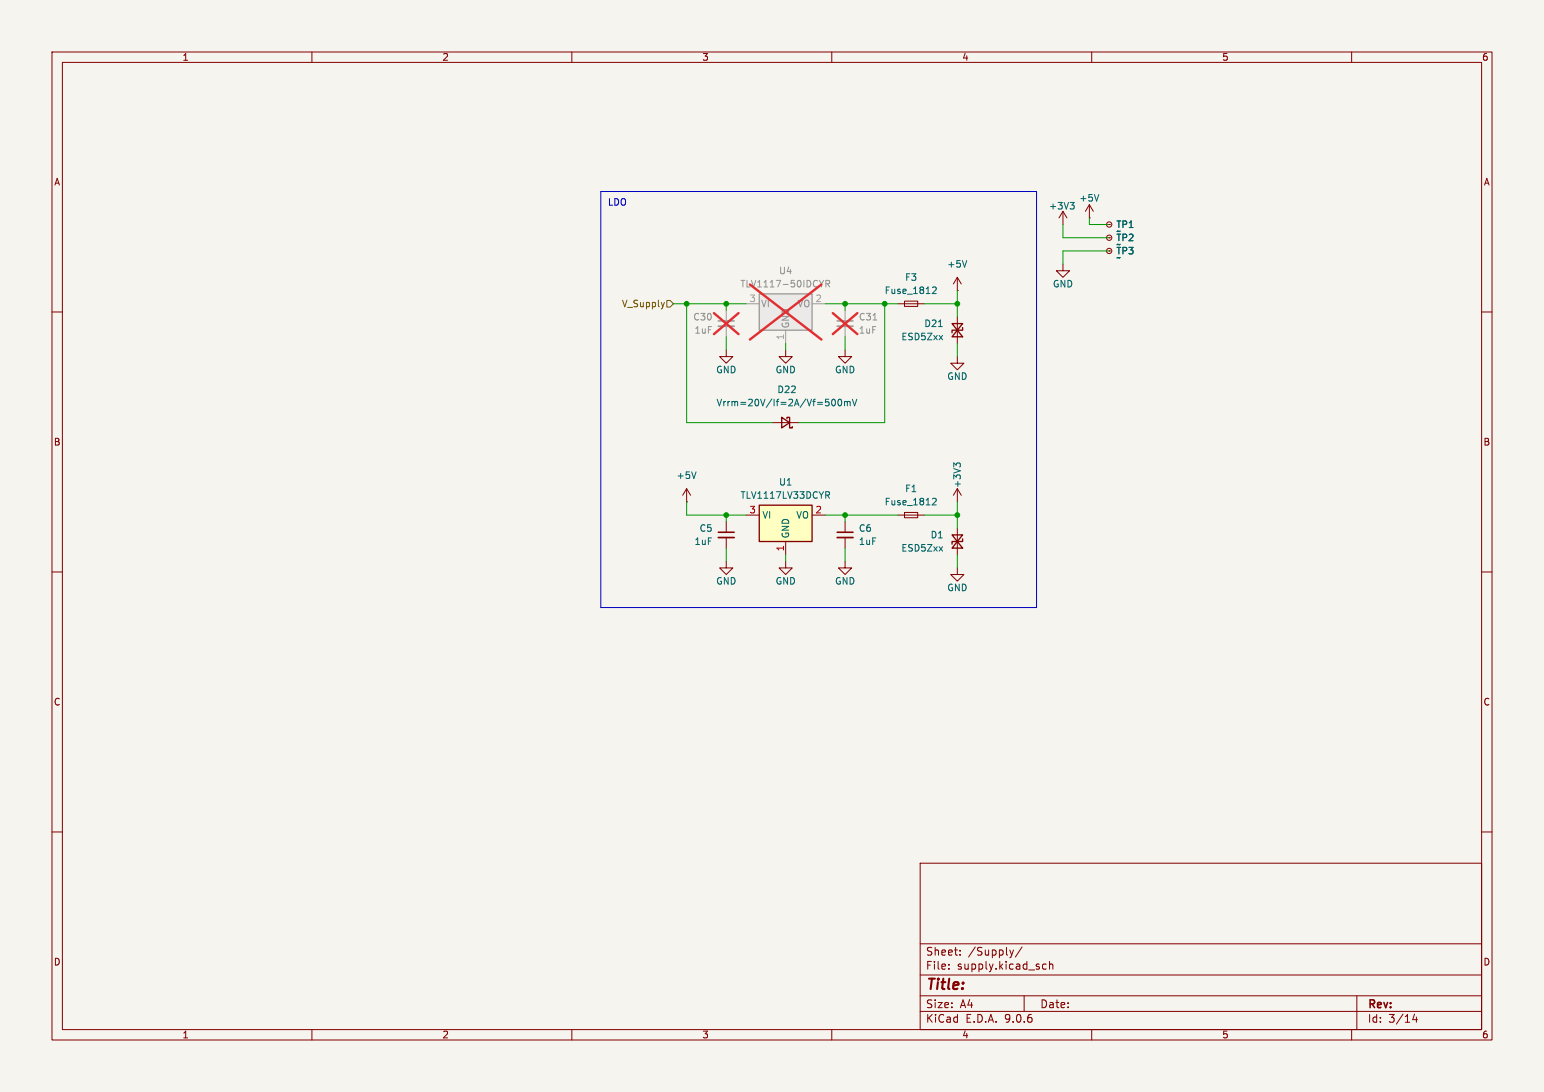
[picture p9: page 3]

Id: 3/14 Title: File: supply.kicad_sch Sheet: /Supply/

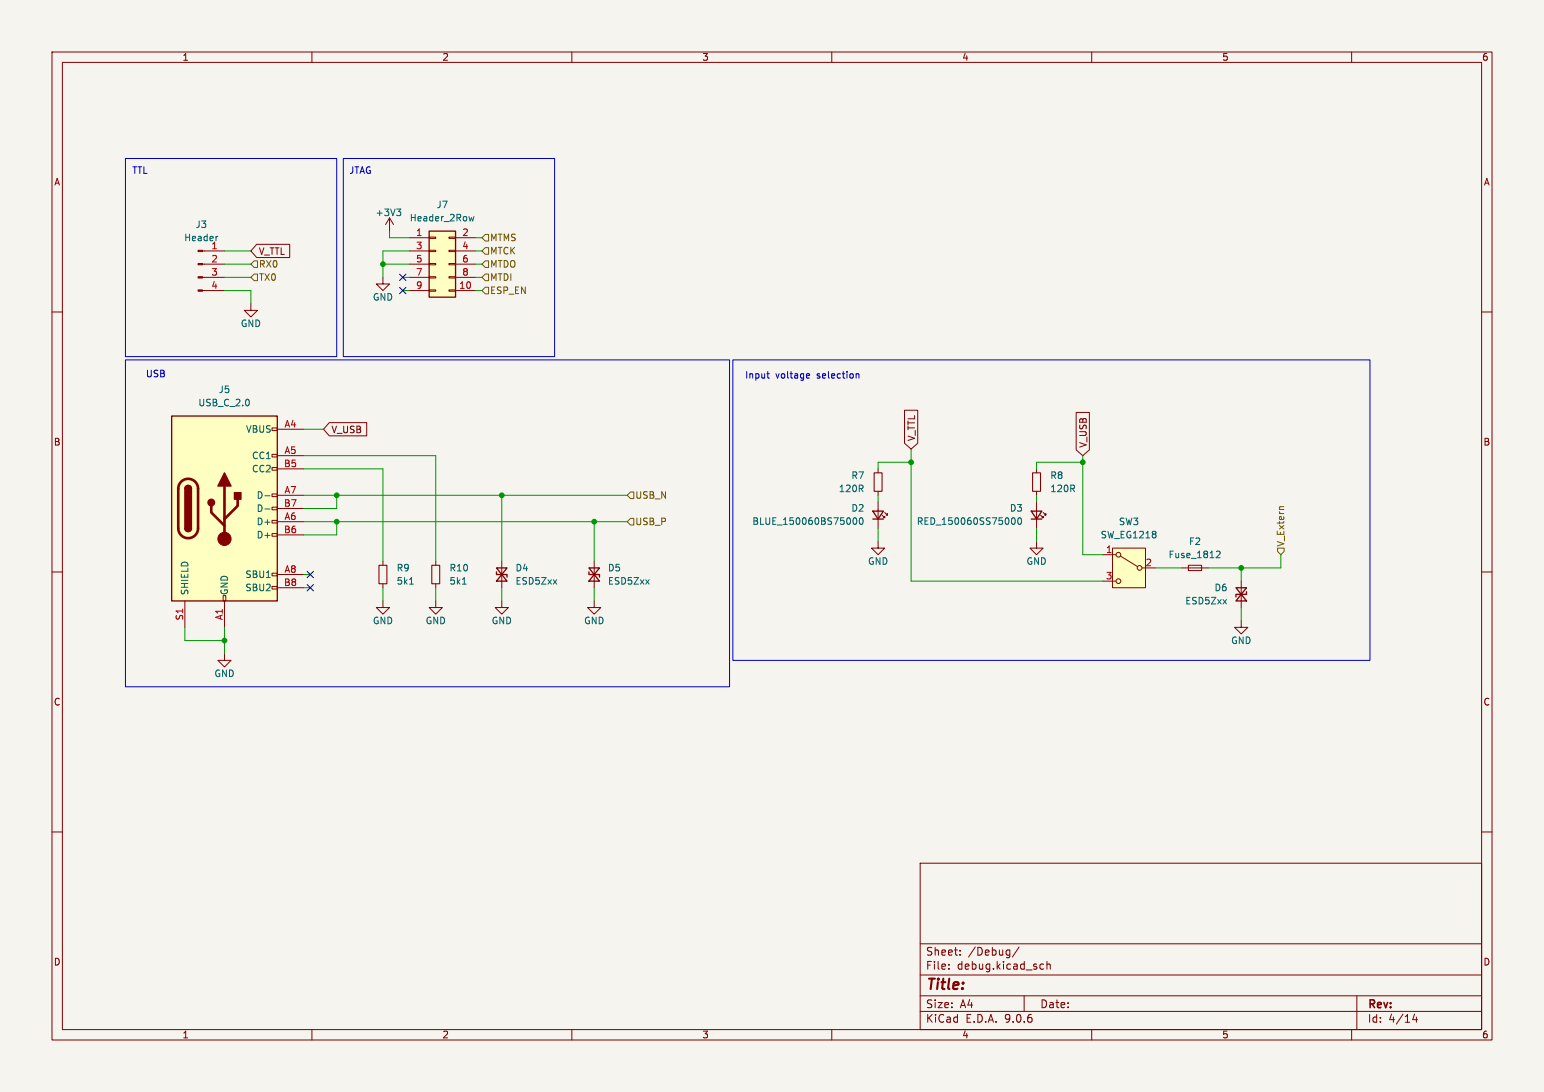
[picture p10: page 4]

Id: 4/14 Title: File: debug.kicad_sch Sheet: /Debug/

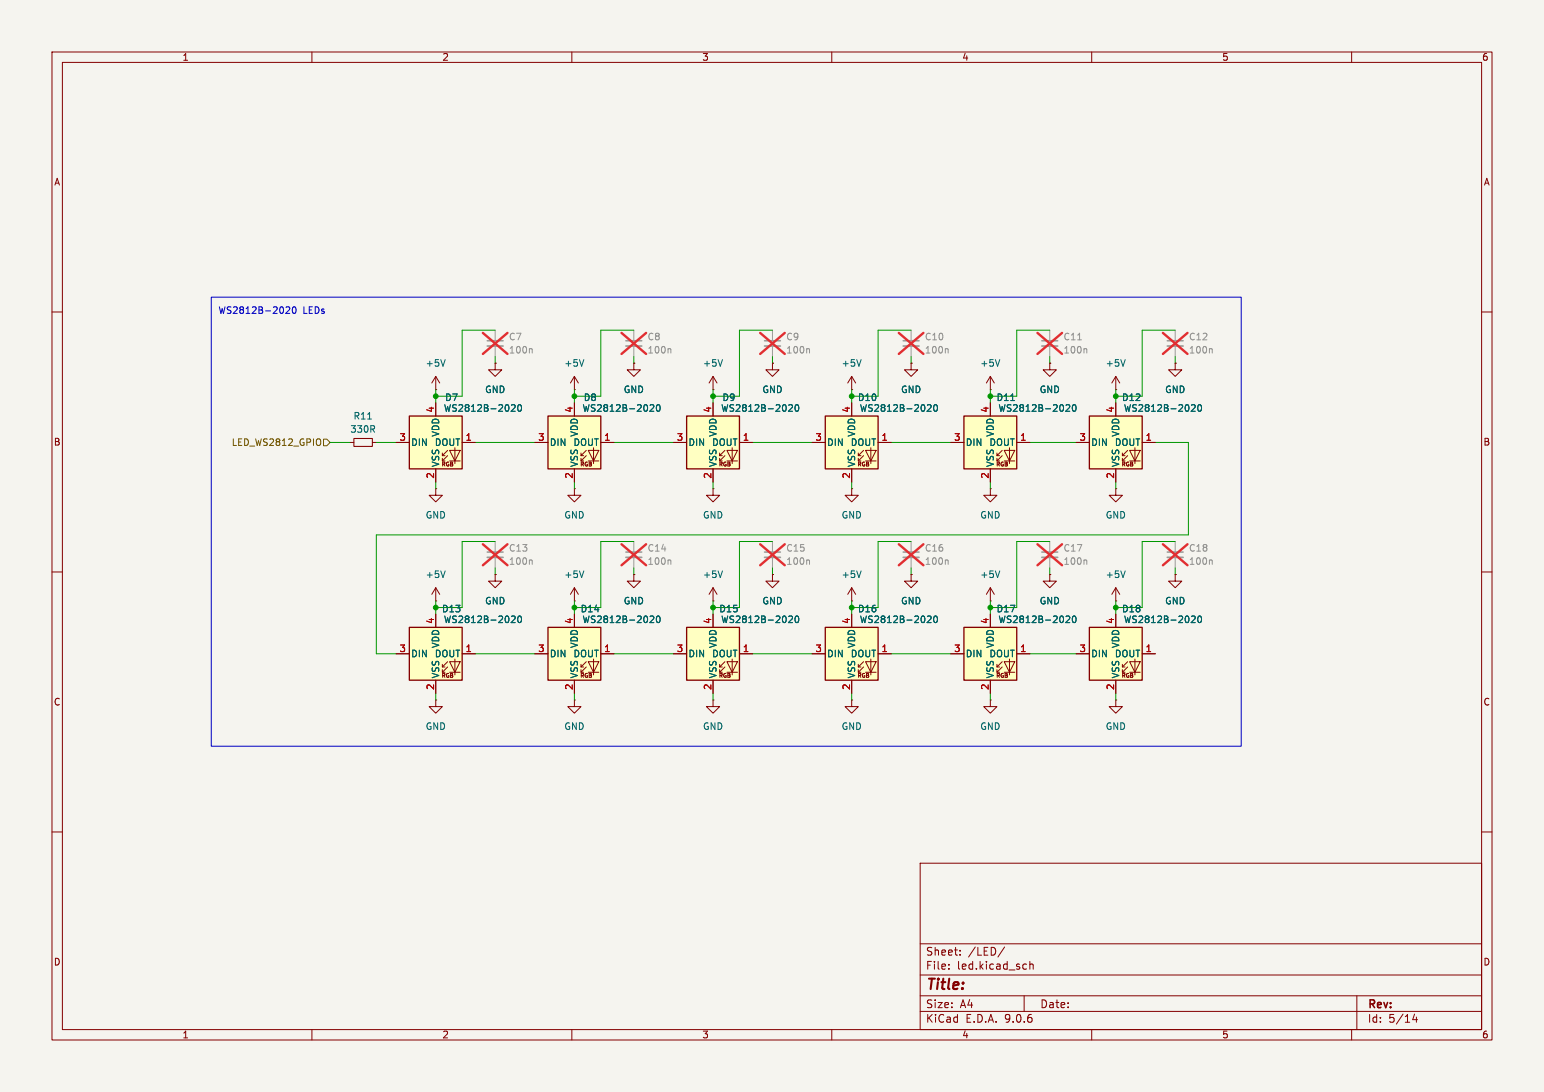
[picture p11: page 5]

2 DOUT 1 GND GND GND GND

2 DOUT 1 D7 WS2812B-2020 GND GND GND

Id: 5/14 Title: File: led.kicad_sch Sheet: /LED/

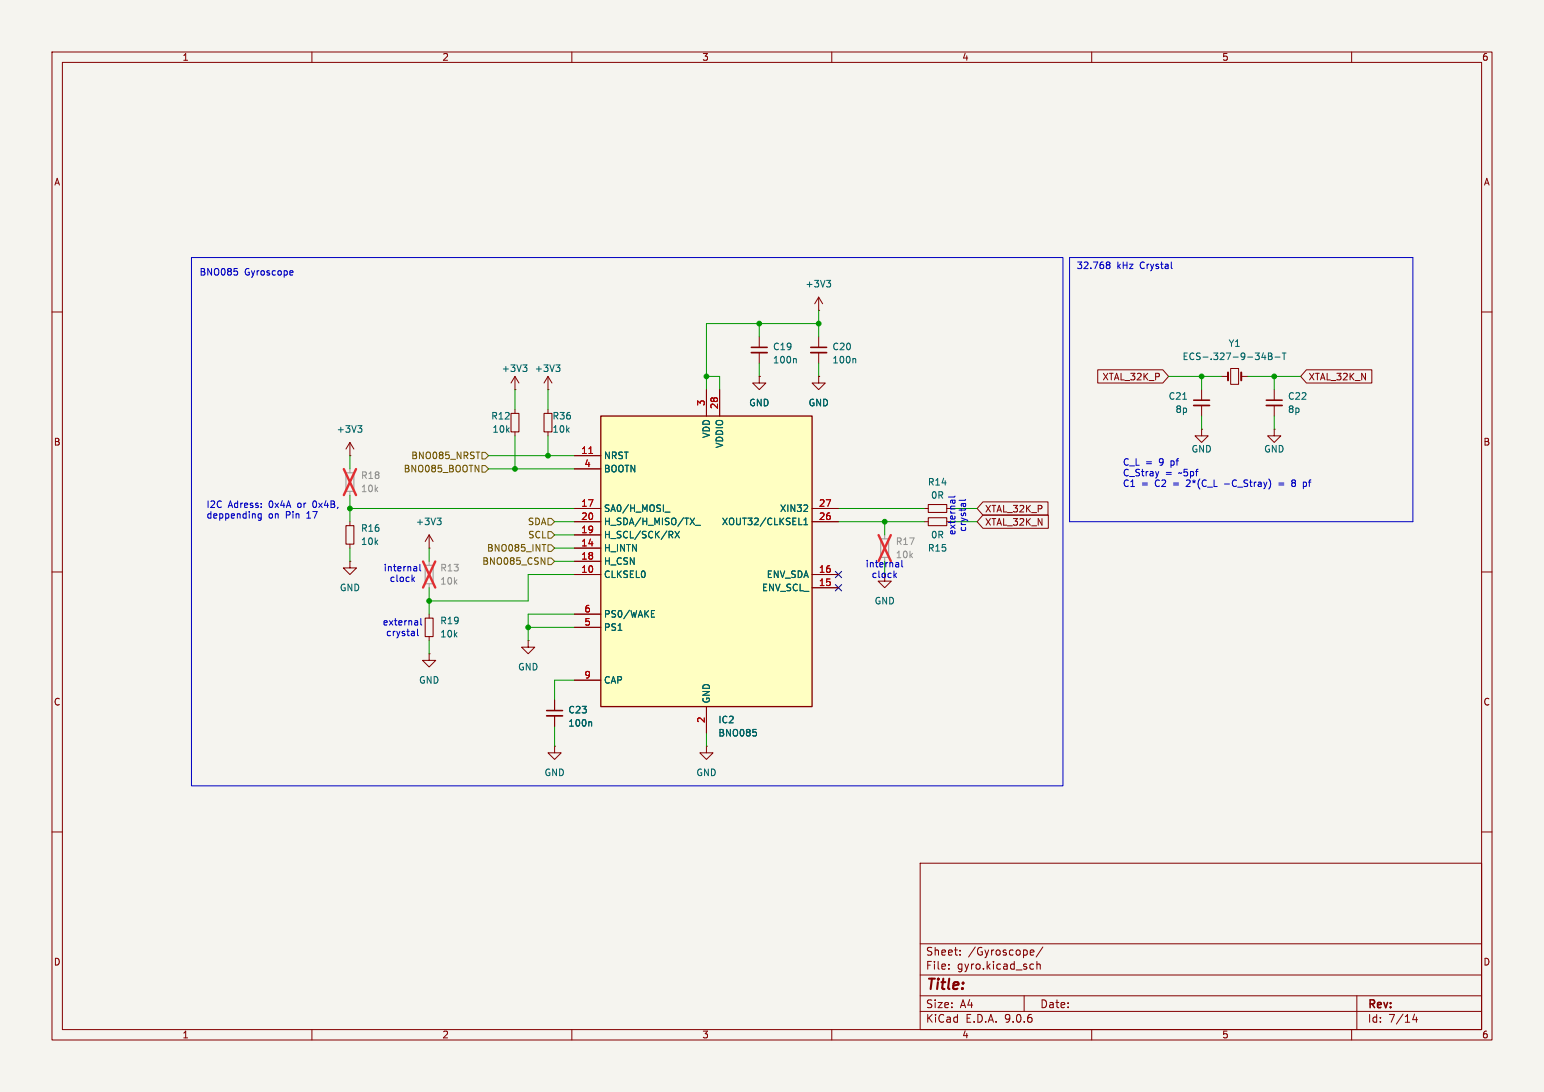
[picture p12: page 6]

Id: 7/14 Title: File: gyro.kicad_sch Sheet: /Gyroscope/ C23

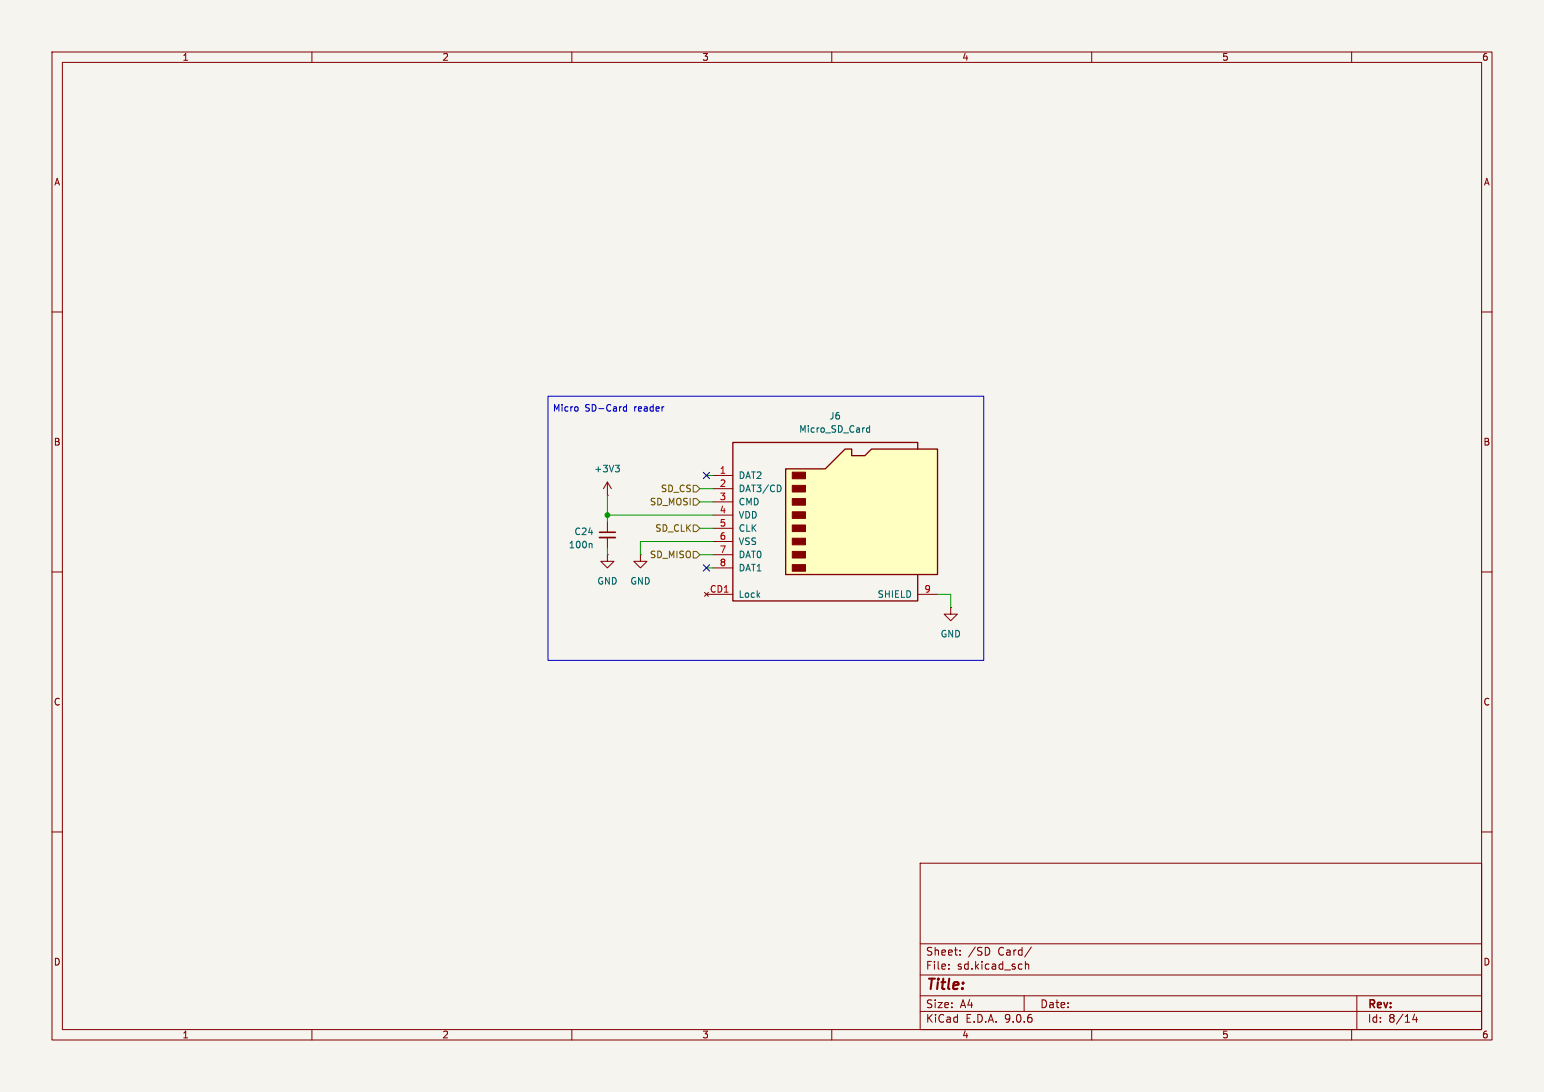
[picture p13: page 7]

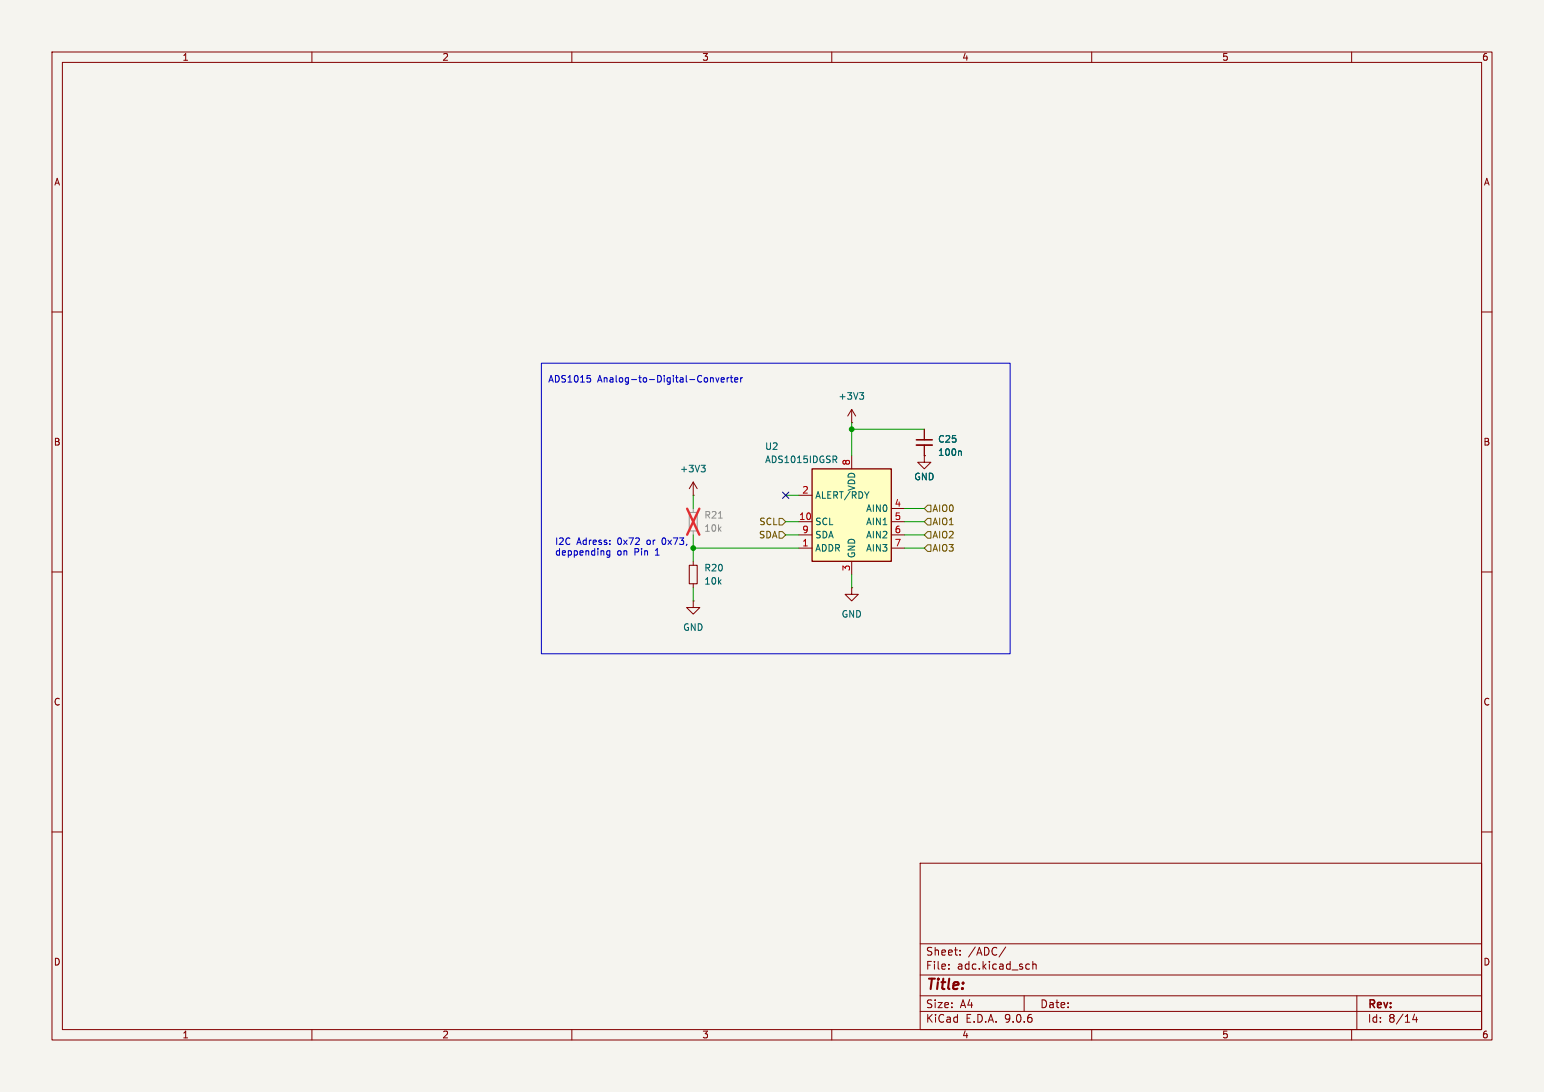
[picture p14: page 8]

3 ALERT/RDY 2 SCL 10 SDA 9 ADDR 1 U2ADS1015IDGSR

Id: 8/14 Title: File: adc.kicad_sch Sheet: /ADC/ GND

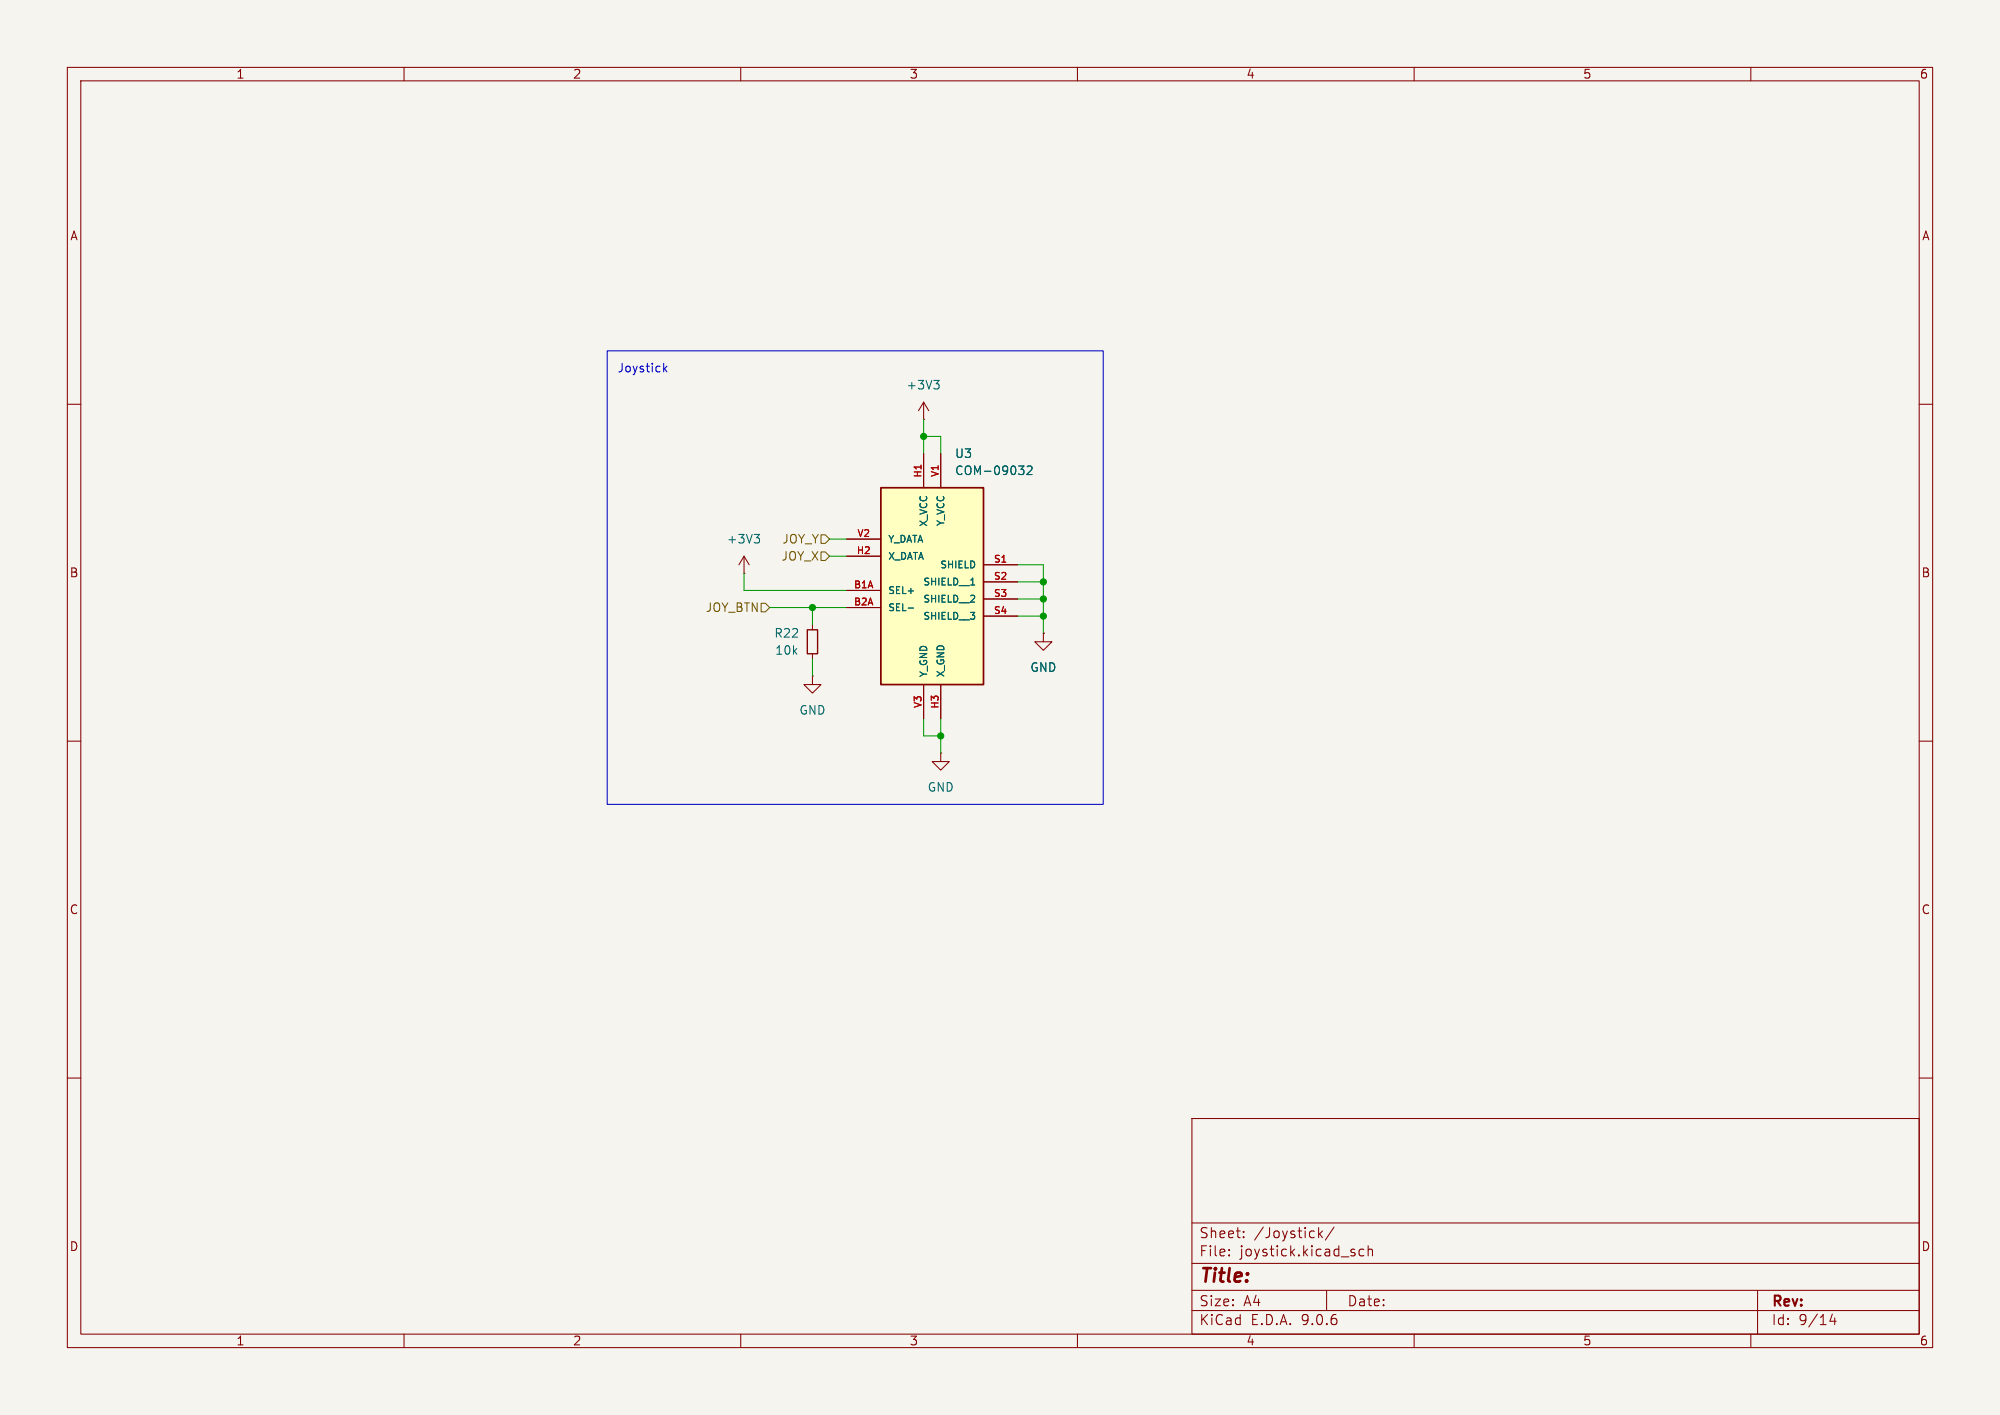
[picture p15: page 9]

Id: 9/14 Title: File: joystick.kicad_sch Sheet: /Joystick/

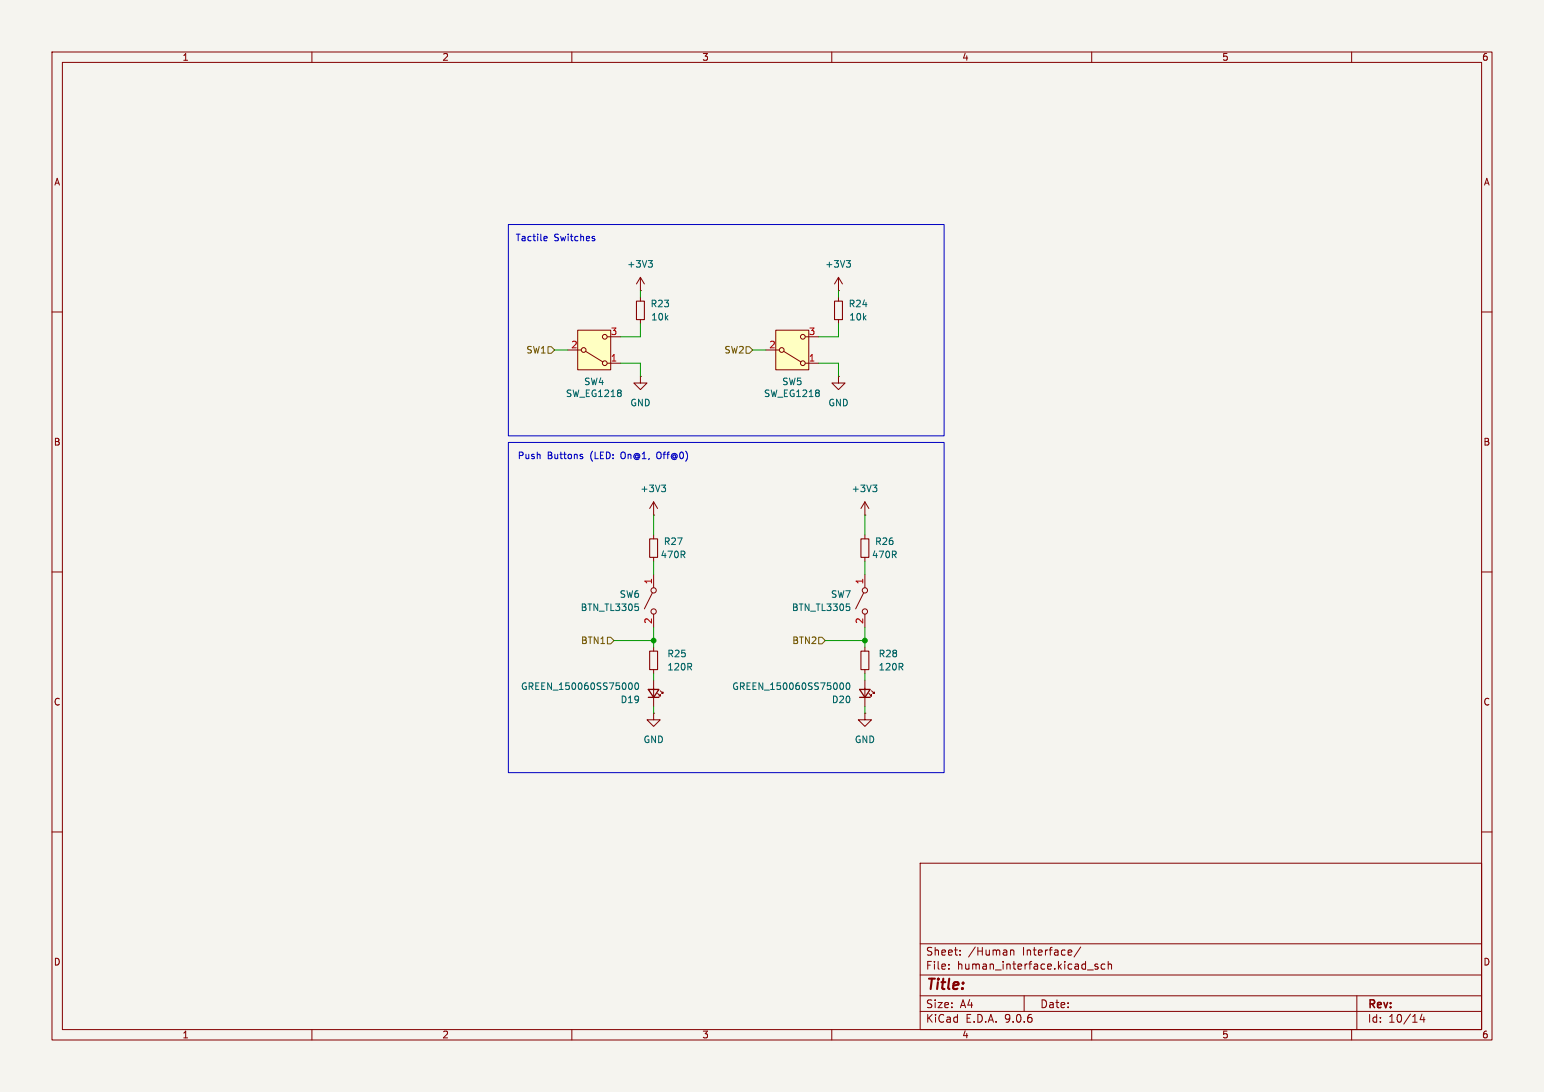
[picture p16: page 10]

Tactile Switches Push Buttons (LED: On@1, Off@0)

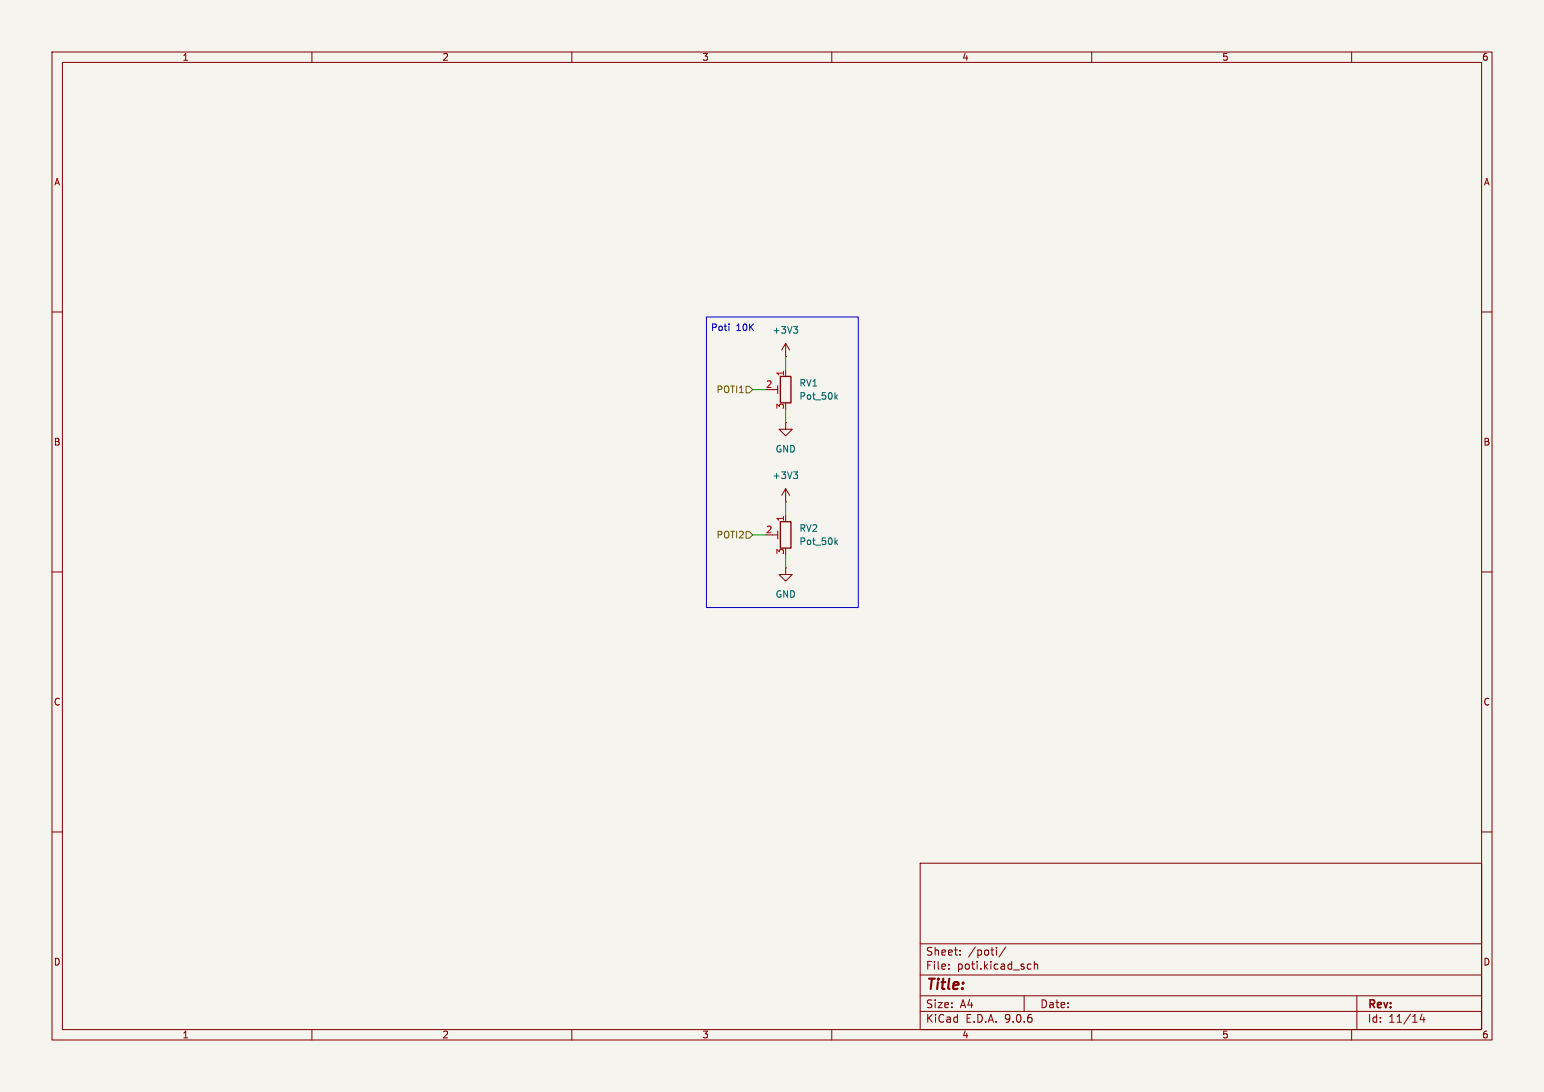
[picture p17: page 11]

Id: 11/14 Title: File: poti.kicad_sch Sheet: /poti/ GND

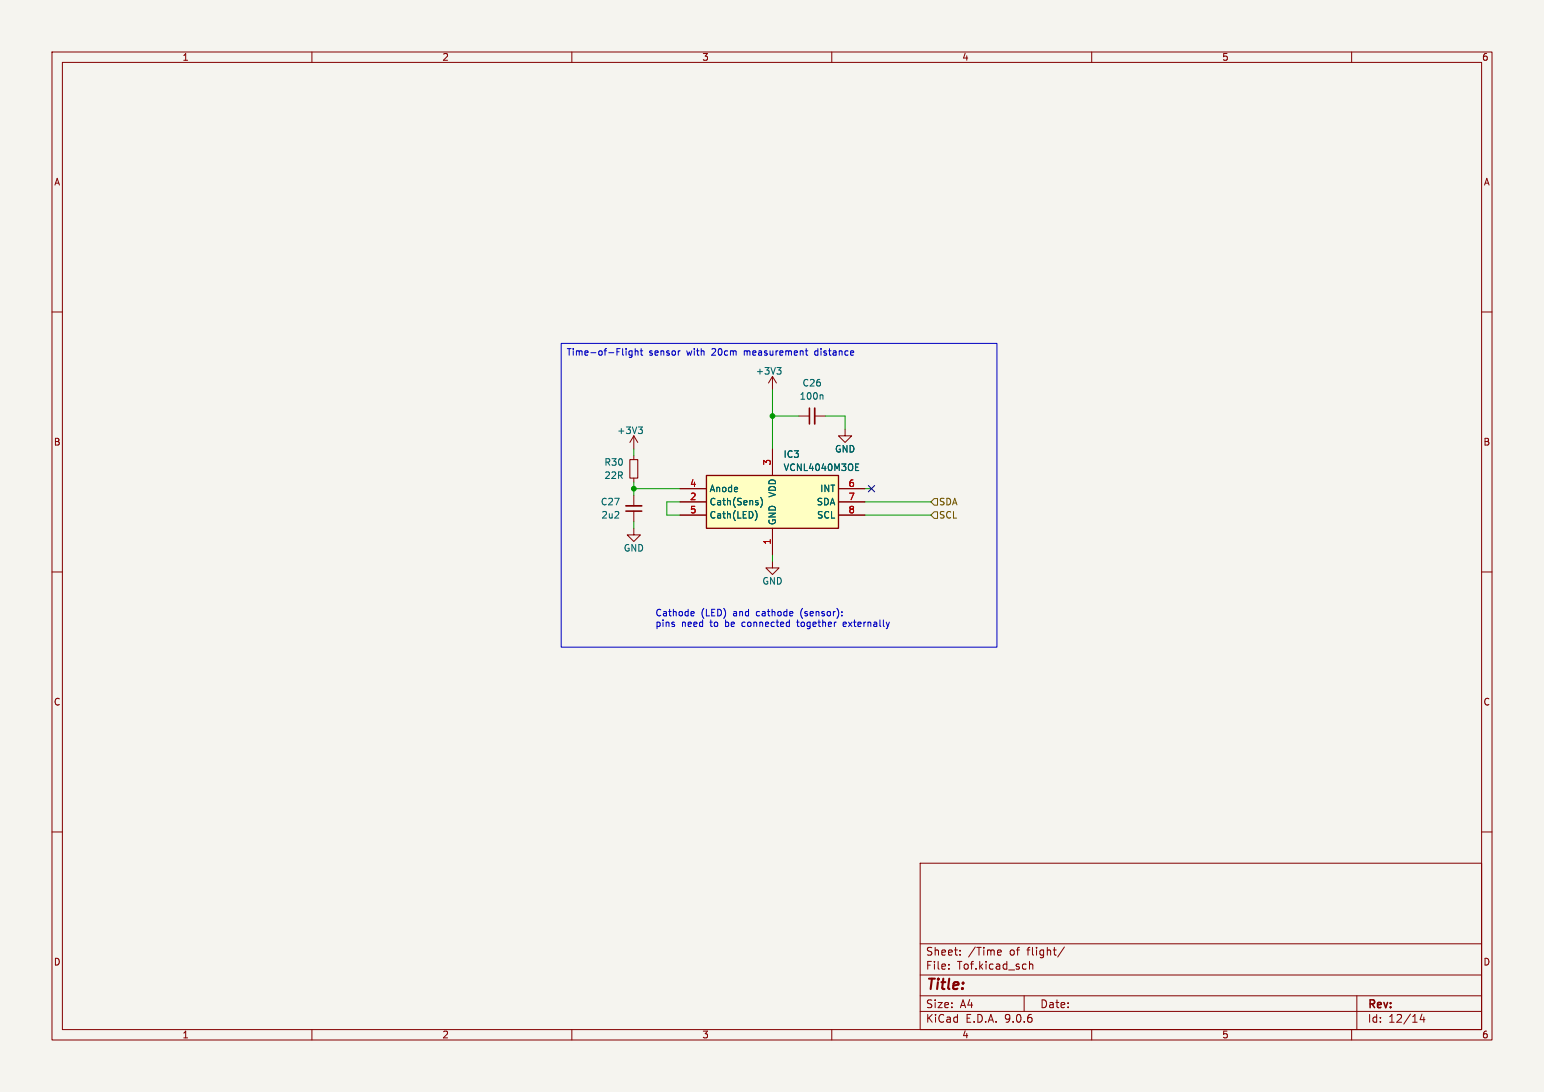
[picture p18: page 12]

Id: 12/14 Title: File: Tof.kicad_sch Sheet: /Time of flight/ GND

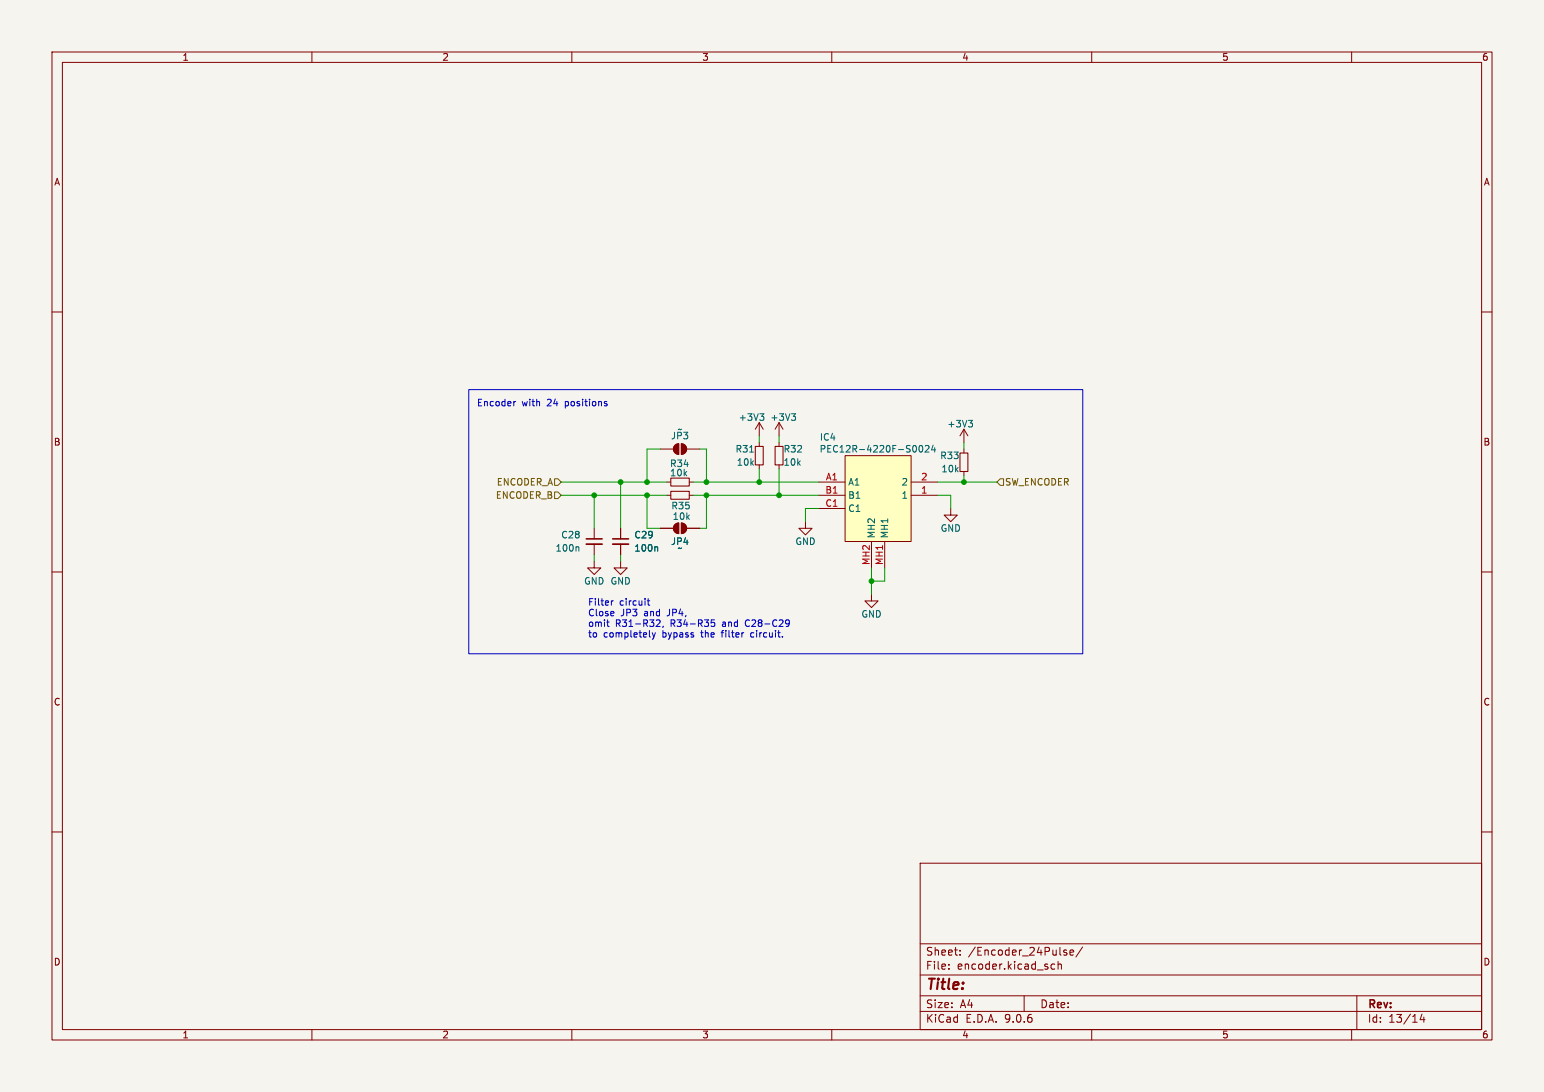
[picture p19: page 13]

Id: 13/14 Title: File: encoder.kicad_sch Sheet: /Encoder_24Pulse/

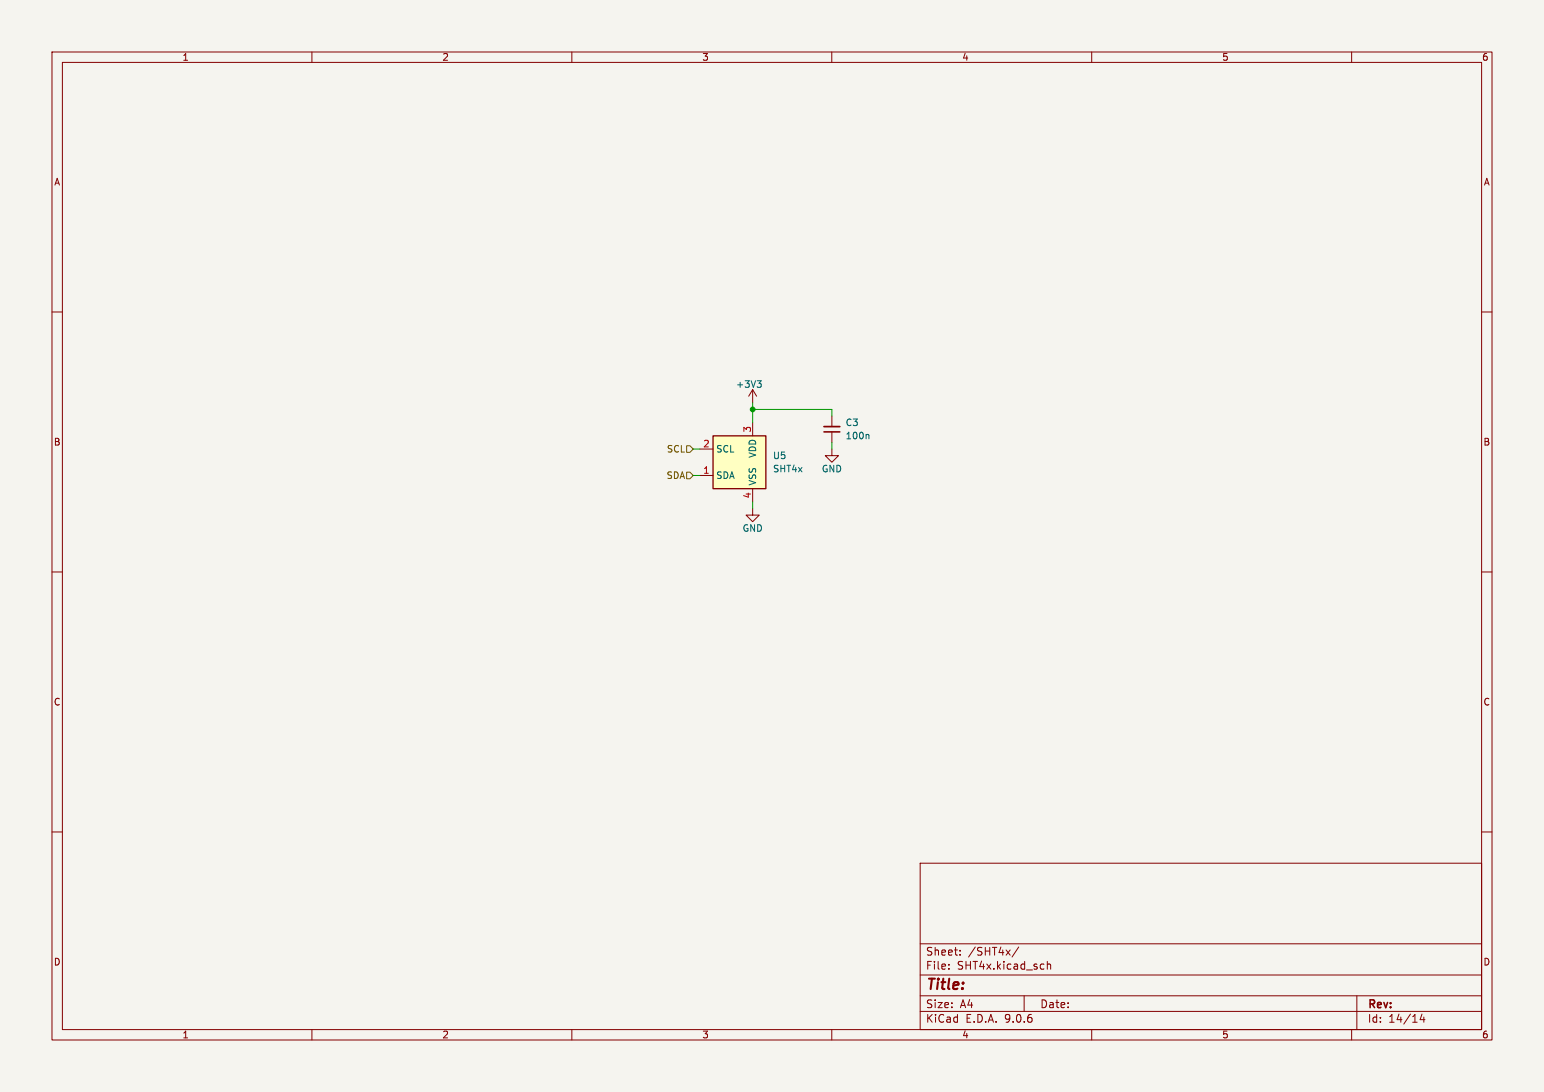
[picture p20: page 14]

Id: 14/14 Title: File: SHT4x.kicad_sch Sheet: /SHT4x/ GND
