Darexsh/mentoring_board_darexsh/Docs/Project_board_layers.pdf

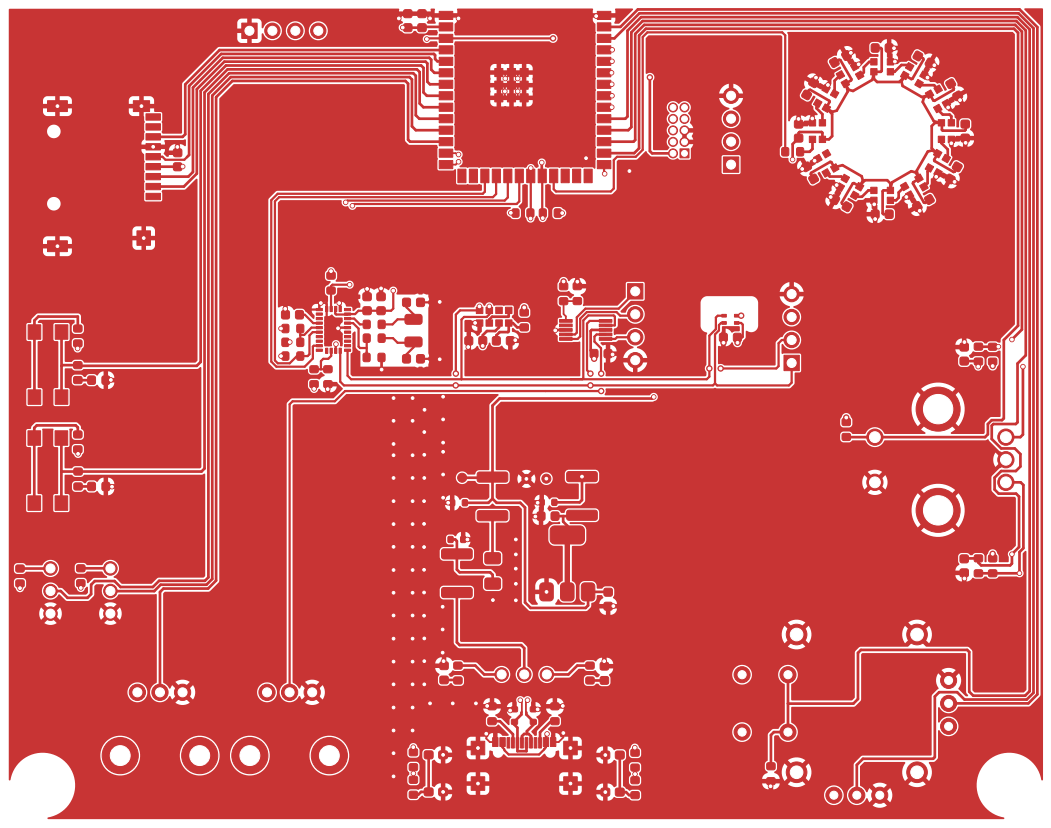
[picture p21: page 1]

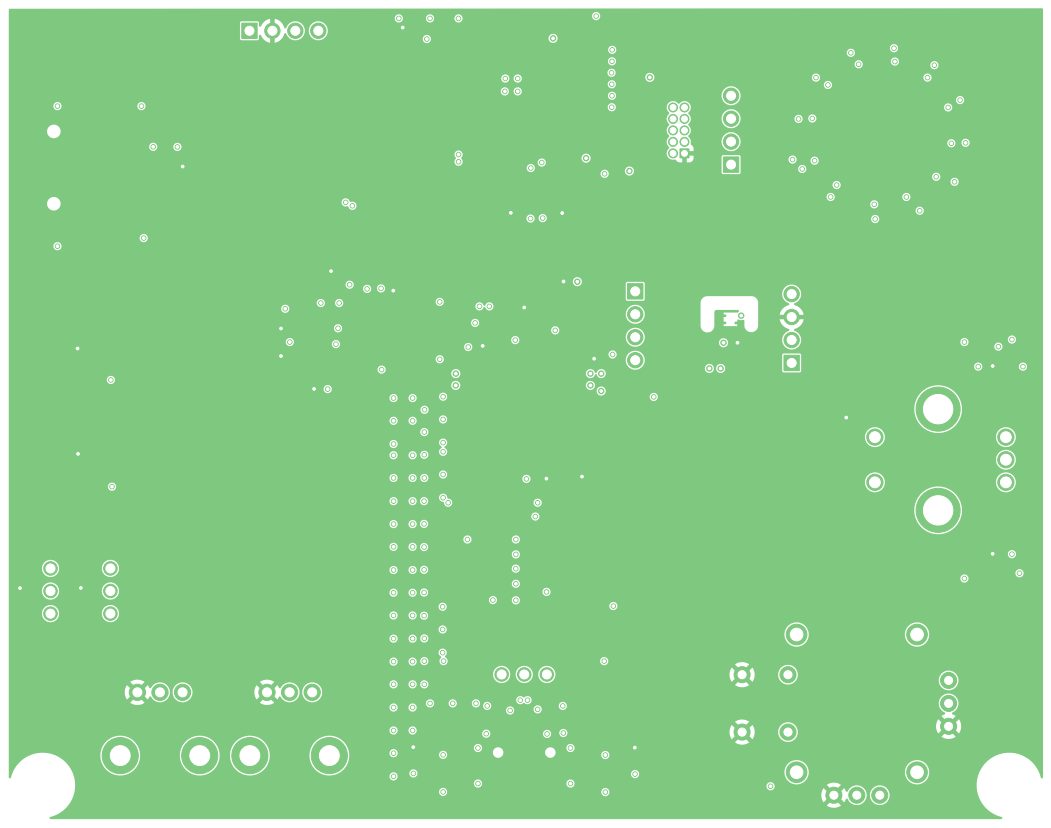
[picture p22: page 2]

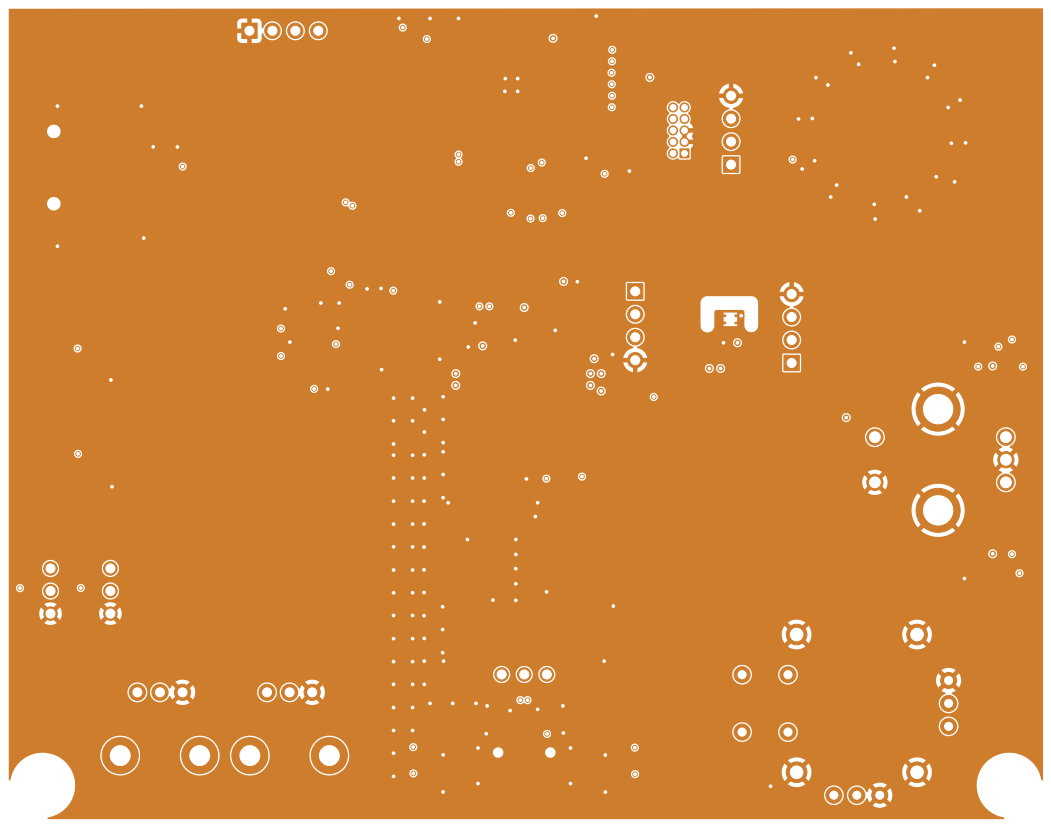
[picture p23: page 3]

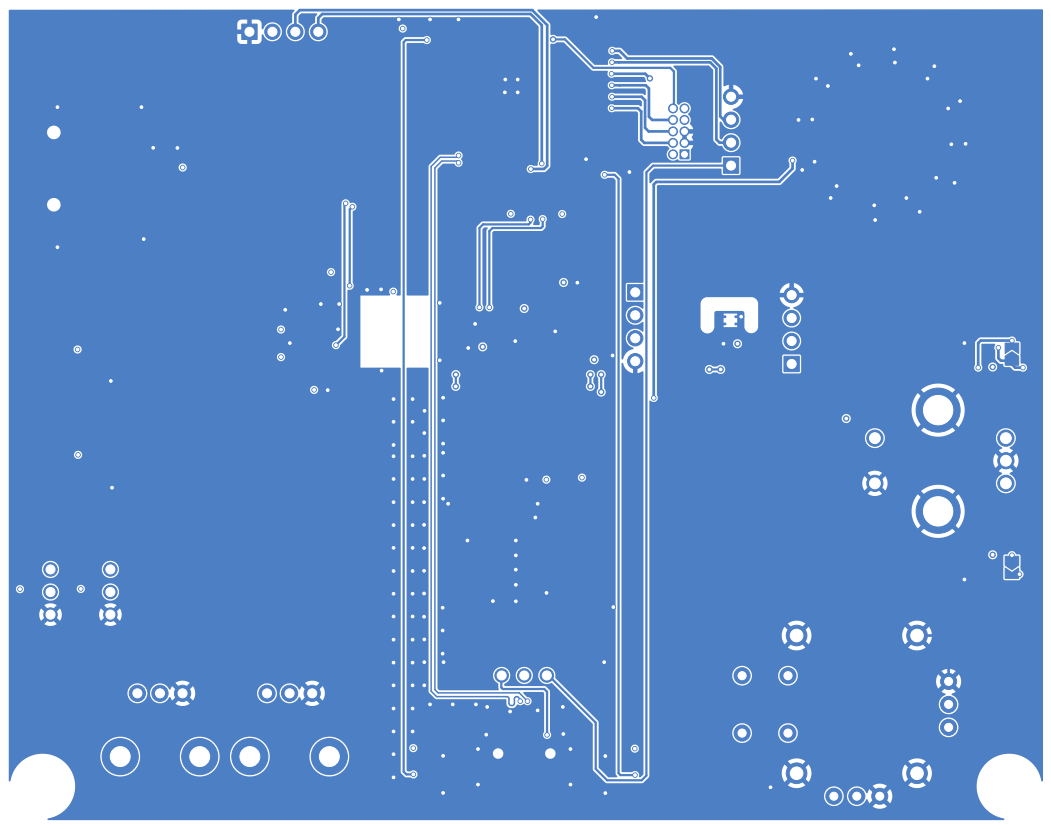
[picture p24: page 4]

# JLink Edu A0

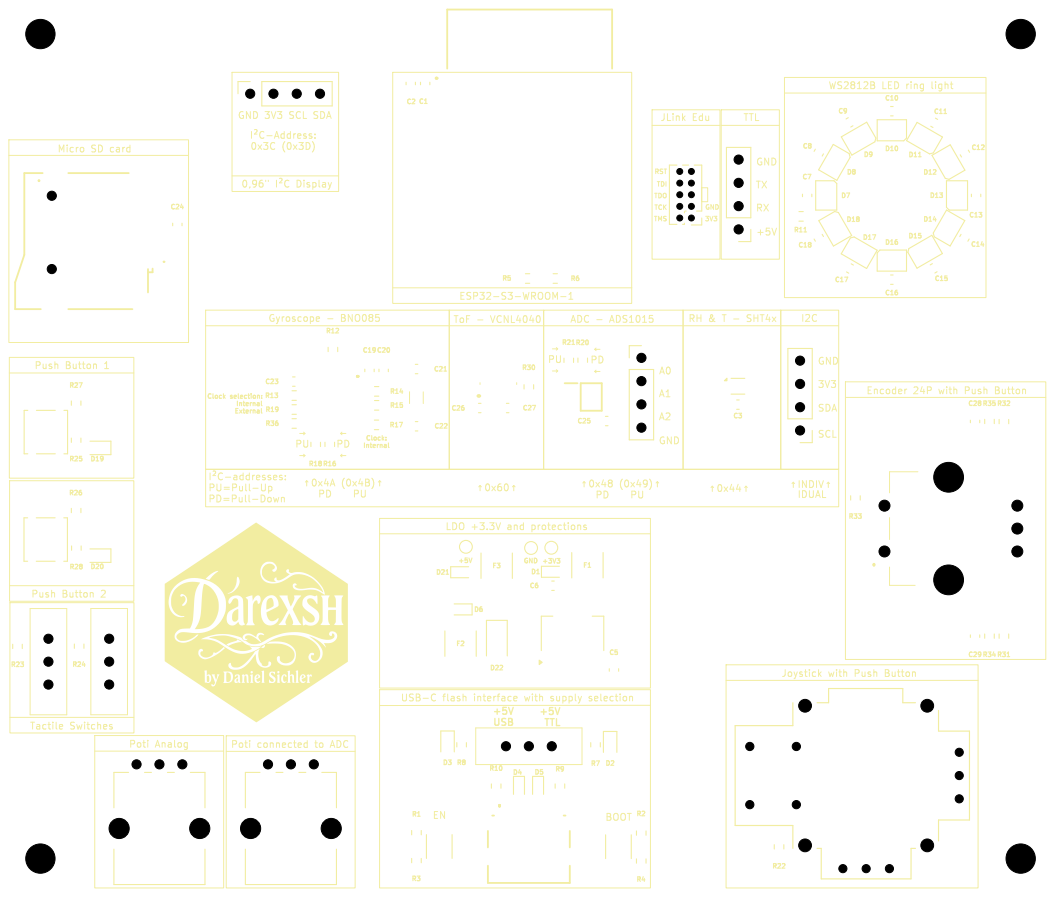
[picture p25: page 5]

þÿI²C-addresses: PU=Pull-Up PD=Pull-Down

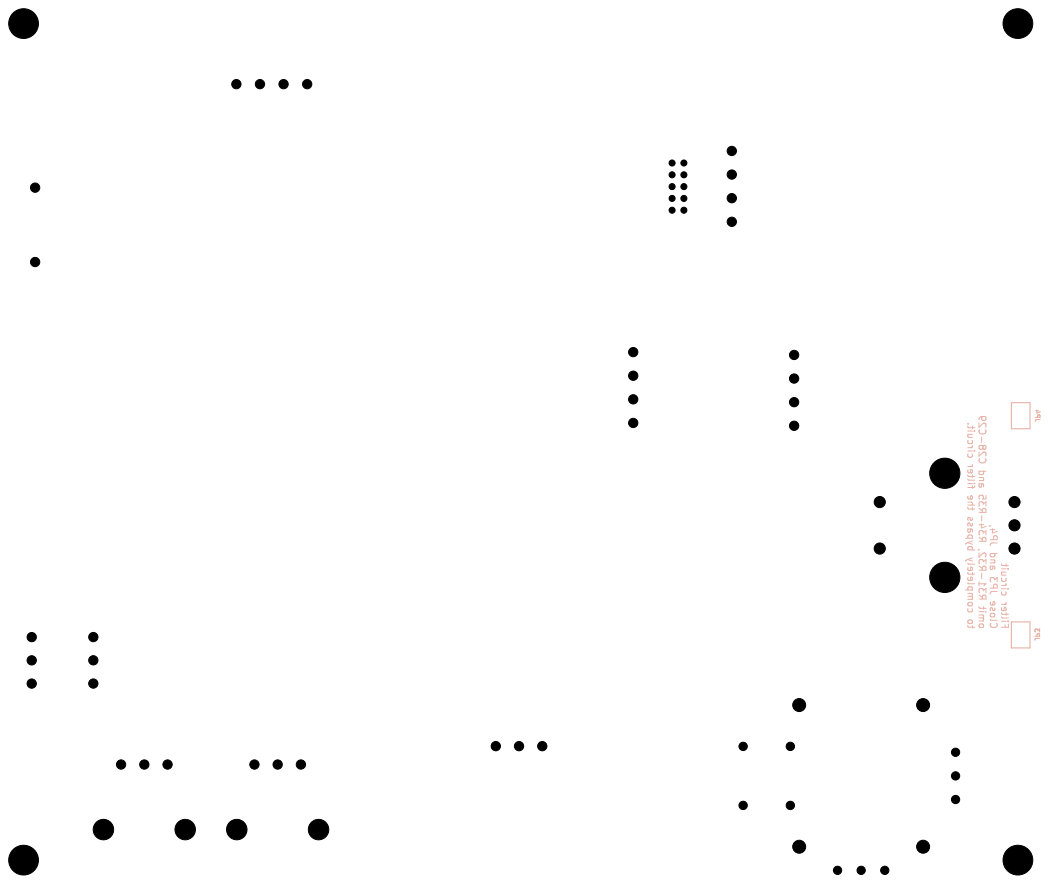
[picture p26: page 6]

Filter circuit Close JP3 and JP4, omit R31-R32, R34-R35 and C28-C29 to completely bypass the filter circuit. JP4 JP3

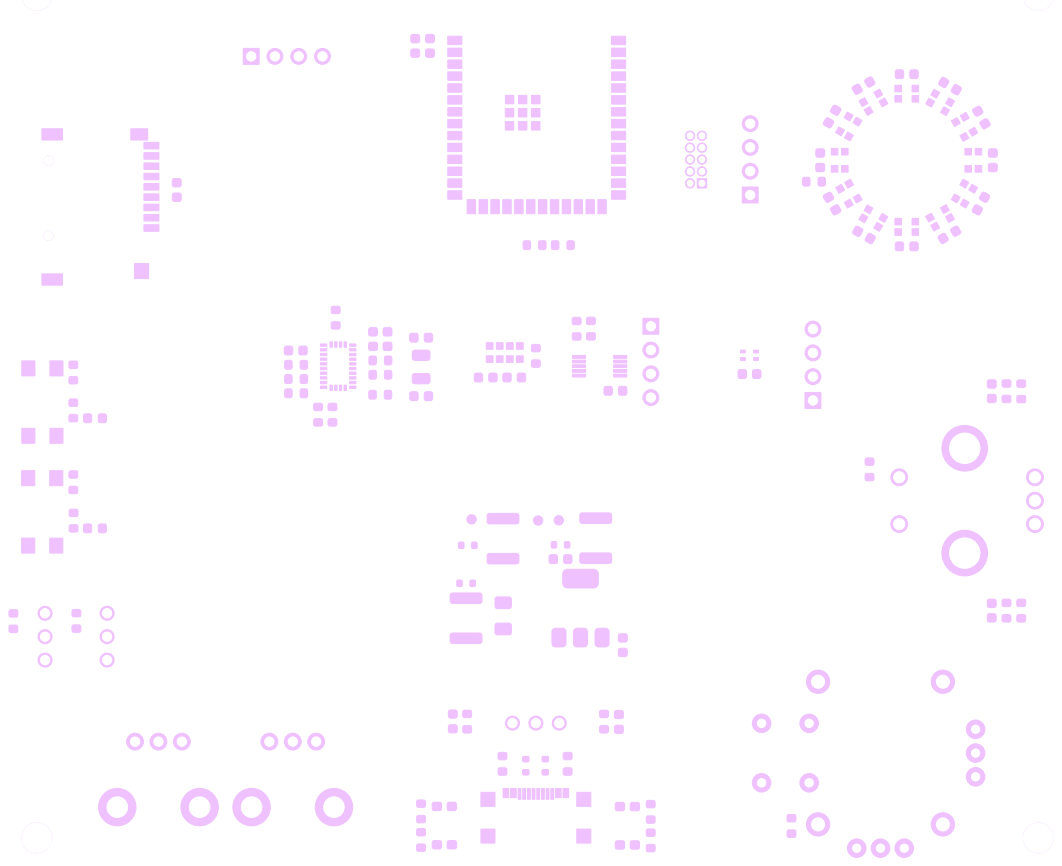
[picture p27: page 7]

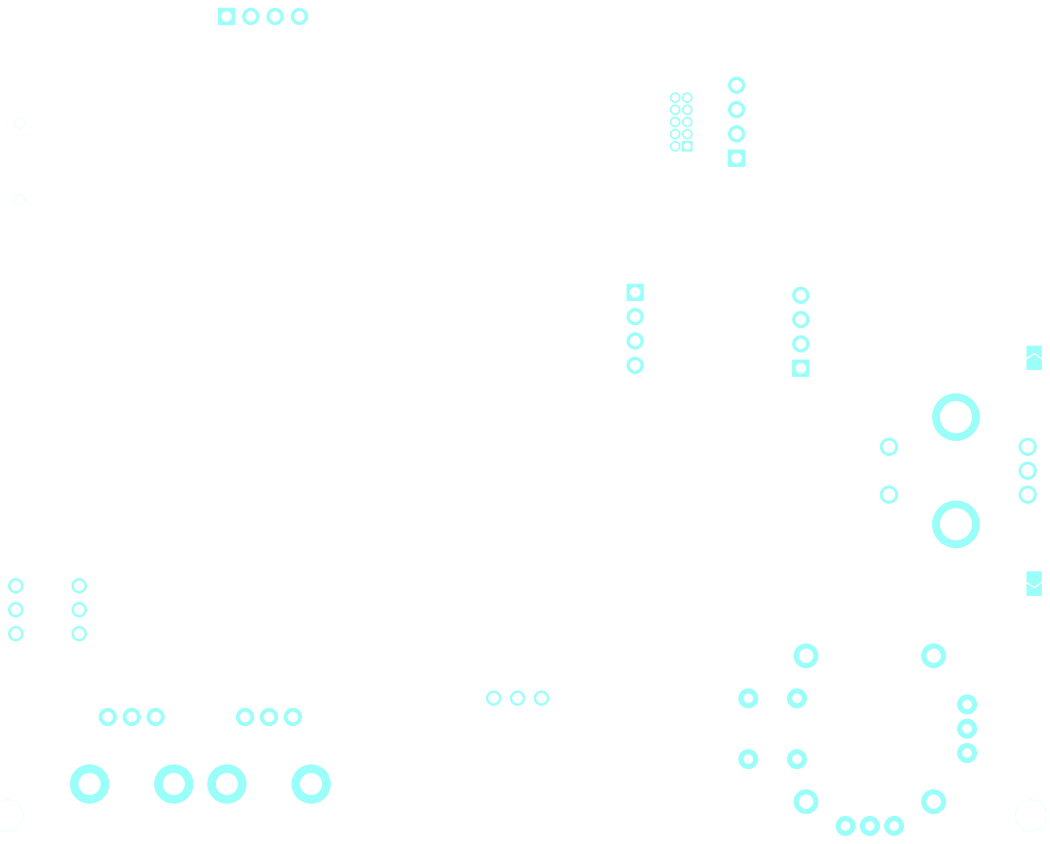
[picture p28: page 8]

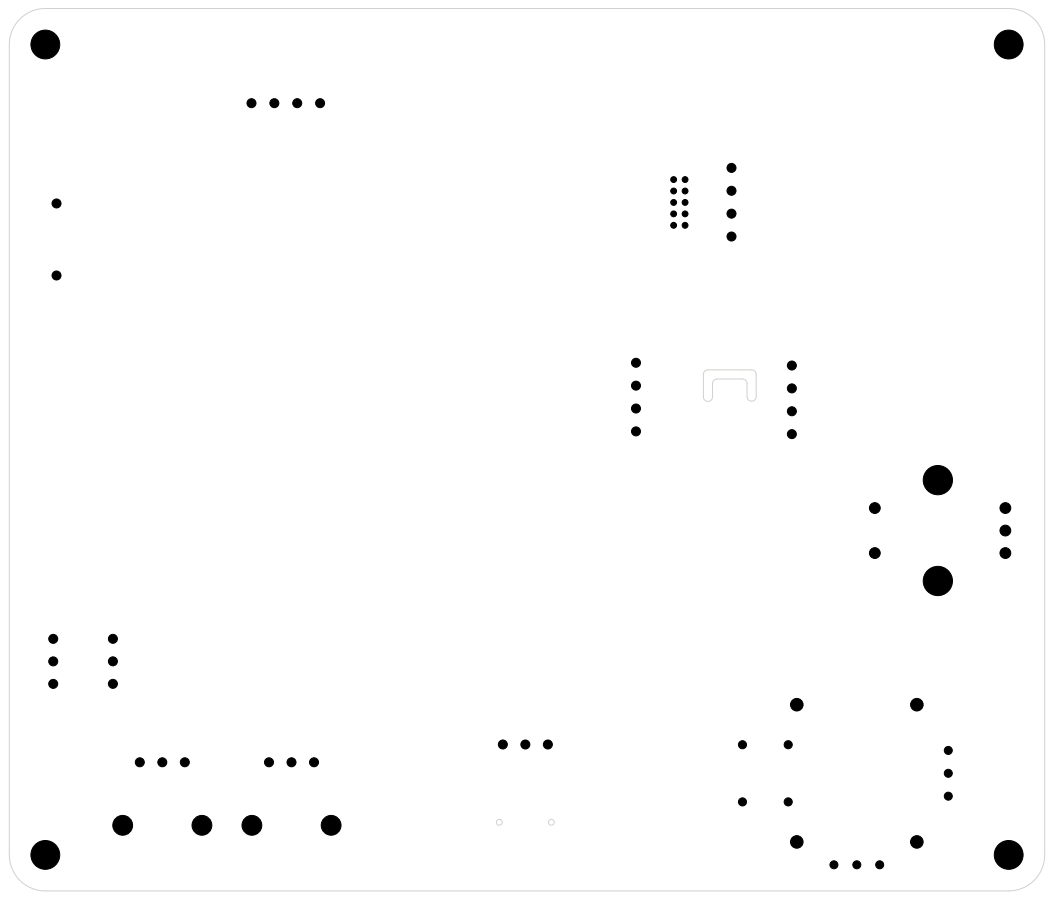
[picture p29: page 9]
