Darexsh/mentoring_board_darexsh/Hardware/Project.kicad_pcb

## KiCad design Hardware/Project.kicad_pcb (2026-02-02)

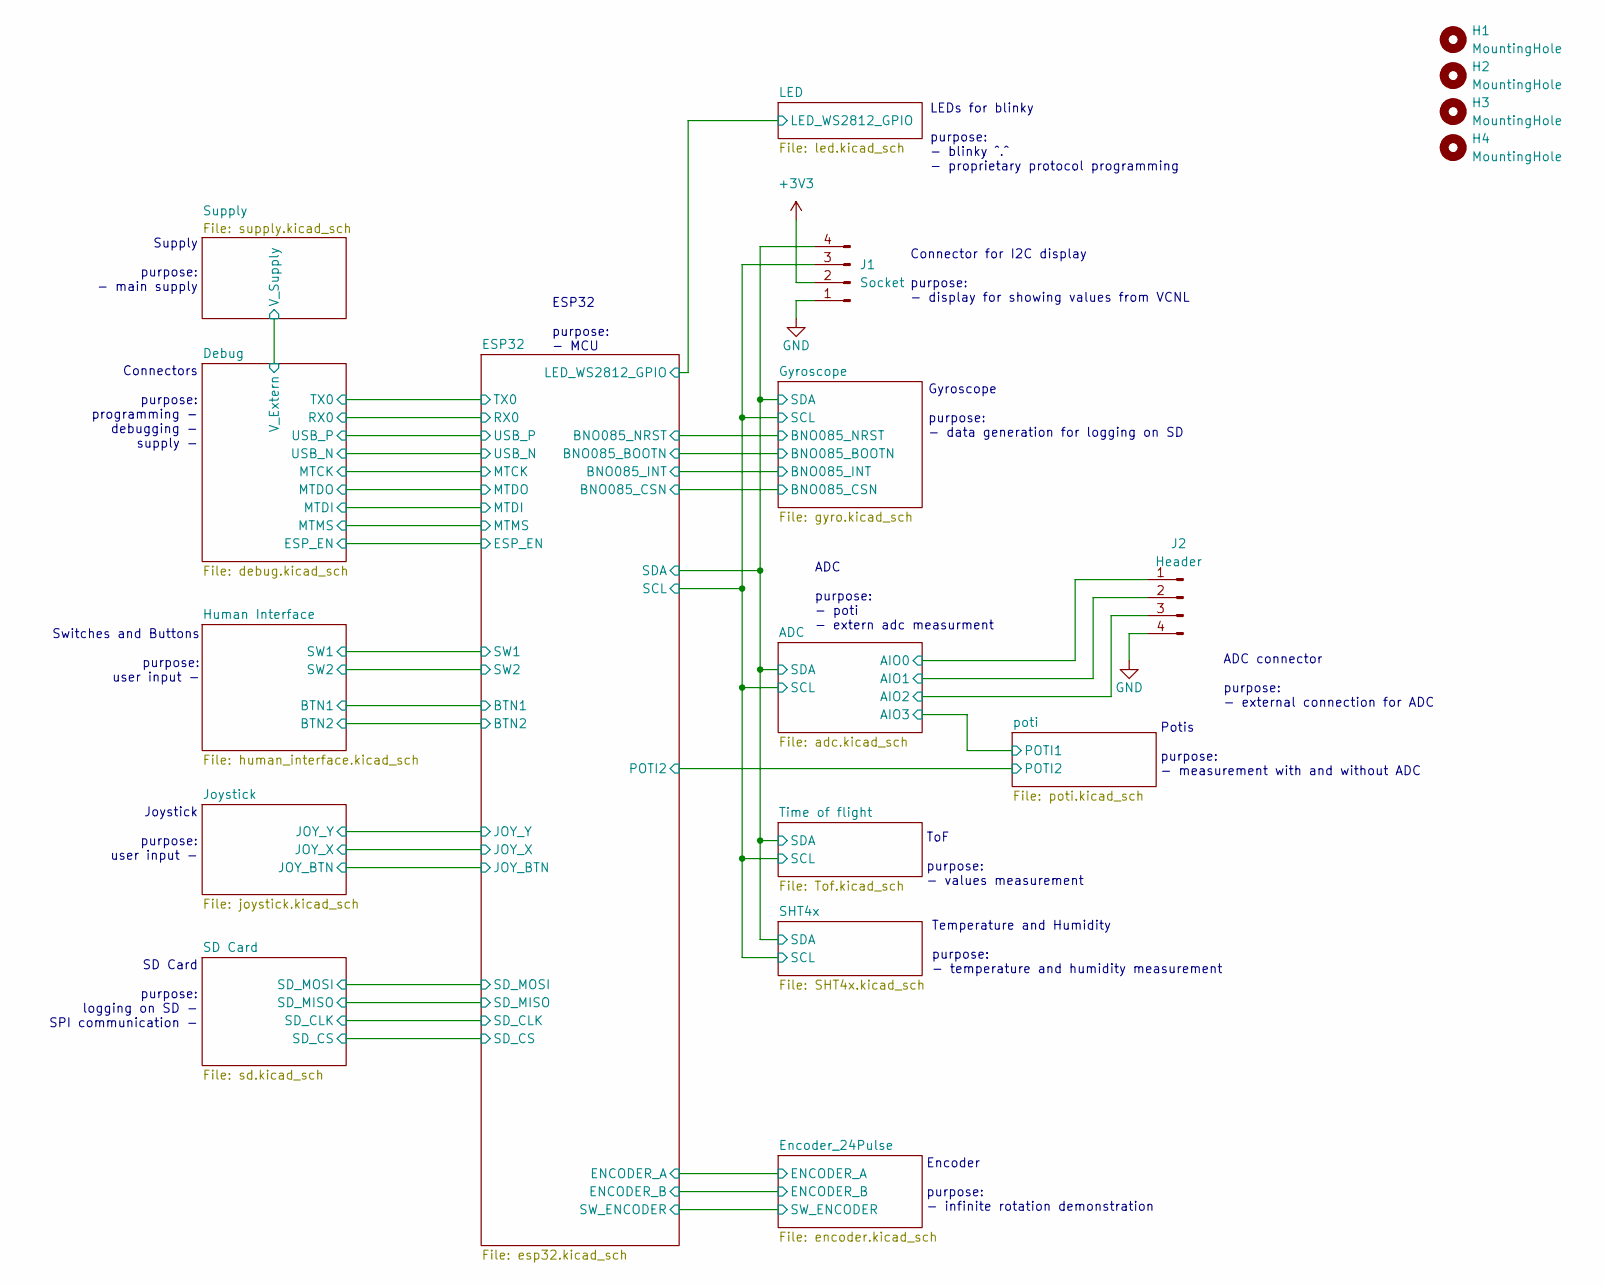
[picture p30: schematic Project.kicad_sch]

Parts:
H1, H2, H3, H4: MountingHole; MountingHole_3.2mm_M3
J1: Socket; PinSocket_1x04_P2.54mm_Vertical; LCSC C2718488
J2: Header; PinHeader_1x04_P2.54mm_Vertical; LCSC C2691448

Connections:
+3V3: J1.2; also elsewhere on the board
/ADC/AIO0: J2.1; also elsewhere on the board
/ADC/AIO1: J2.2; also elsewhere on the board
/ADC/AIO2: J2.3; also elsewhere on the board
/ADC/SCL: J1.3; also elsewhere on the board
/ADC/SDA: J1.4; also elsewhere on the board
GND: J1.1, J2.4; also elsewhere on the board

Notes on the sheet:
Connectors purpose: programming - debugging - supply -
Connector for I2C display purpose: - display for showing values from VCNL
ESP32 purpose: - MCU
Temperature and Humidity purpose: - temperature and humidity measurement
Supply purpose: - main supply
Joystick purpose: user input -
SD Card purpose: logging on SD - SPI communication -
ADC connector purpose: - external connection for ADC
Switches and Buttons purpose: user input -
ToF purpose: - values measurement
Potis purpose: - measurement with and without ADC
Gyroscope purpose: - data generation for logging on SD
Encoder purpose: - infinite rotation demonstration
LEDs for blinky purpose: - blinky ^.^ - proprietary protocol programming
ADC purpose: - poti - extern adc measurment

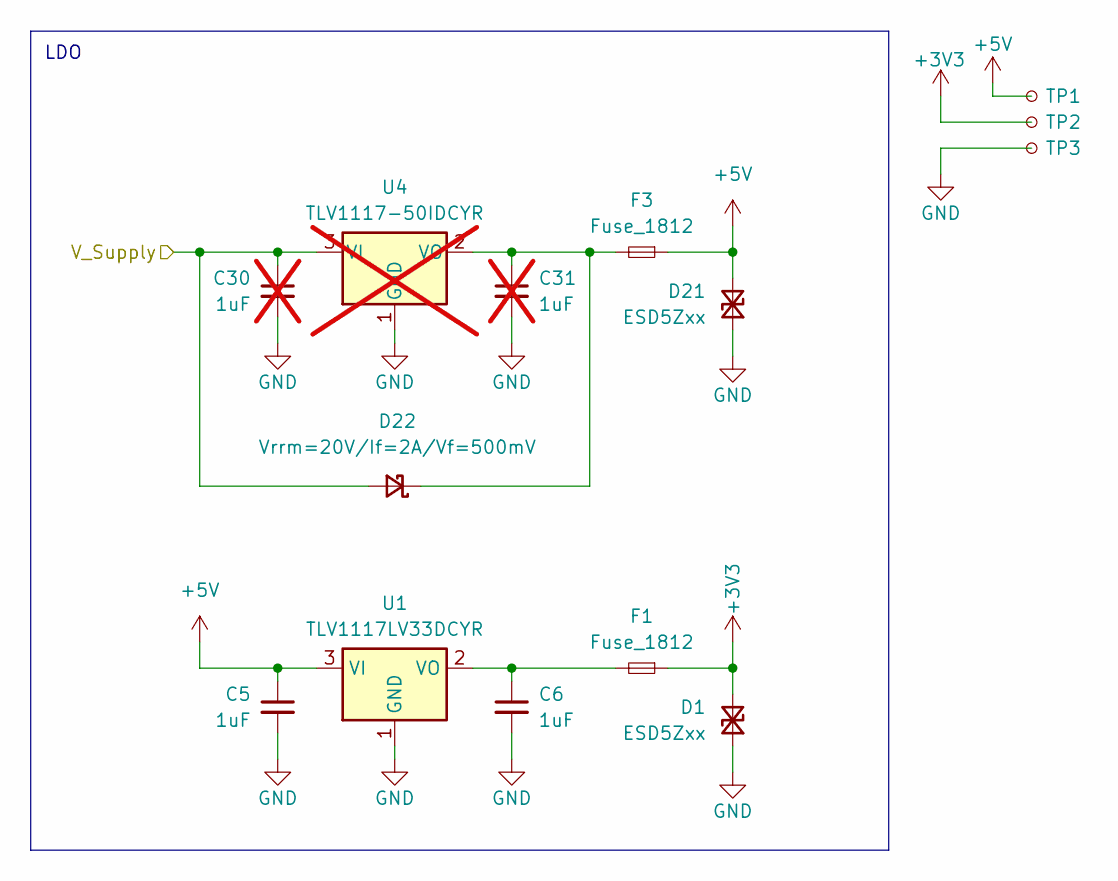
[picture p31: schematic supply.kicad_sch]

Parts:
C5, C6: 1uF; C_0603_1608Metric; LCSC C559769
C30, C31: 1uF; C_0603_1608Metric; LCSC C559769; not fitted
D1, D21: ESD5Zxx; D_SOD-523; LCSC C383211
D22: Vrrm=20V/If=2A/Vf=500mV; D_1206_3216Metric; LCSC C143806
F1, F3: Fuse_1812; Fuse_1812_4532Metric; LCSC C883155
TP1, TP2, TP3: TestPoint_Pad_D1.0mm
U1: TLV1117LV33DCYR; SOT-223-3_TabPin2; LCSC C48937499
U4: TLV1117-50IDCYR; SOT-223-3_TabPin2; not fitted

Connections:
+3V3: D1.2 (A2), F1.1, TP2.1; also elsewhere on the board
+5V: C5.1, D21.2 (A2), F3.1, TP1.1, U1.3 (VI); also elsewhere on the board
/Debug/V_Extern: C30.1, D22.2 (A), U4.3 (VI); also elsewhere on the board
GND: C5.2, C6.2, C30.2, C31.2, D1.1 (A1), D21.1 (A1), TP3.1, U1.1 (GND), U4.1 (GND); also elsewhere on the board
unnamed: C31.1, D22.1 (K), F3.2, U4.2 (VO)
unnamed: C6.1, F1.2, U1.2 (VO)

Notes on the sheet:
LDO

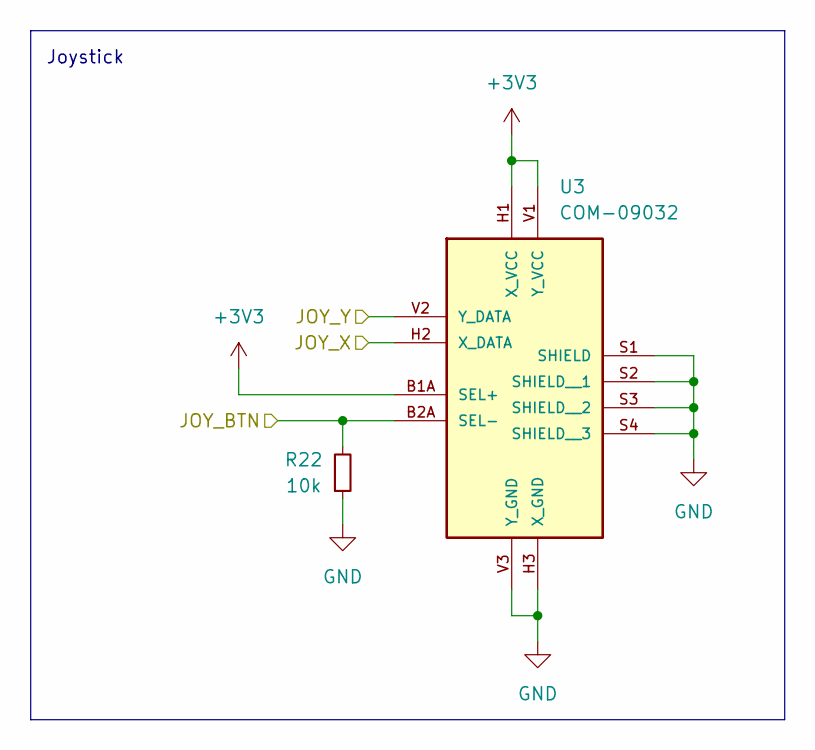
[picture p32: schematic joystick.kicad_sch]

Parts:
R22: 10k; R_0603_1608Metric; LCSC C98220
U3: COM-09032

Connections:
+3V3: U3.B1A (SEL+), U3.B1B (SEL+), U3.H1 (X_VCC), U3.V1 (Y_VCC); also elsewhere on the board
/ESP32/JOY_BTN: R22.2, U3.B2A (SEL-), U3.B2B (SEL-); also elsewhere on the board
/ESP32/JOY_X: U3.H2 (X_DATA); also elsewhere on the board
/ESP32/JOY_Y: U3.V2 (Y_DATA); also elsewhere on the board
GND: R22.1, U3.H3 (X_GND), U3.S1 (SHIELD), U3.S2 (SHIELD__1), U3.S3 (SHIELD__2), U3.S4 (SHIELD__3), U3.V3 (Y_GND); also elsewhere on the board

Notes on the sheet:
Joystick

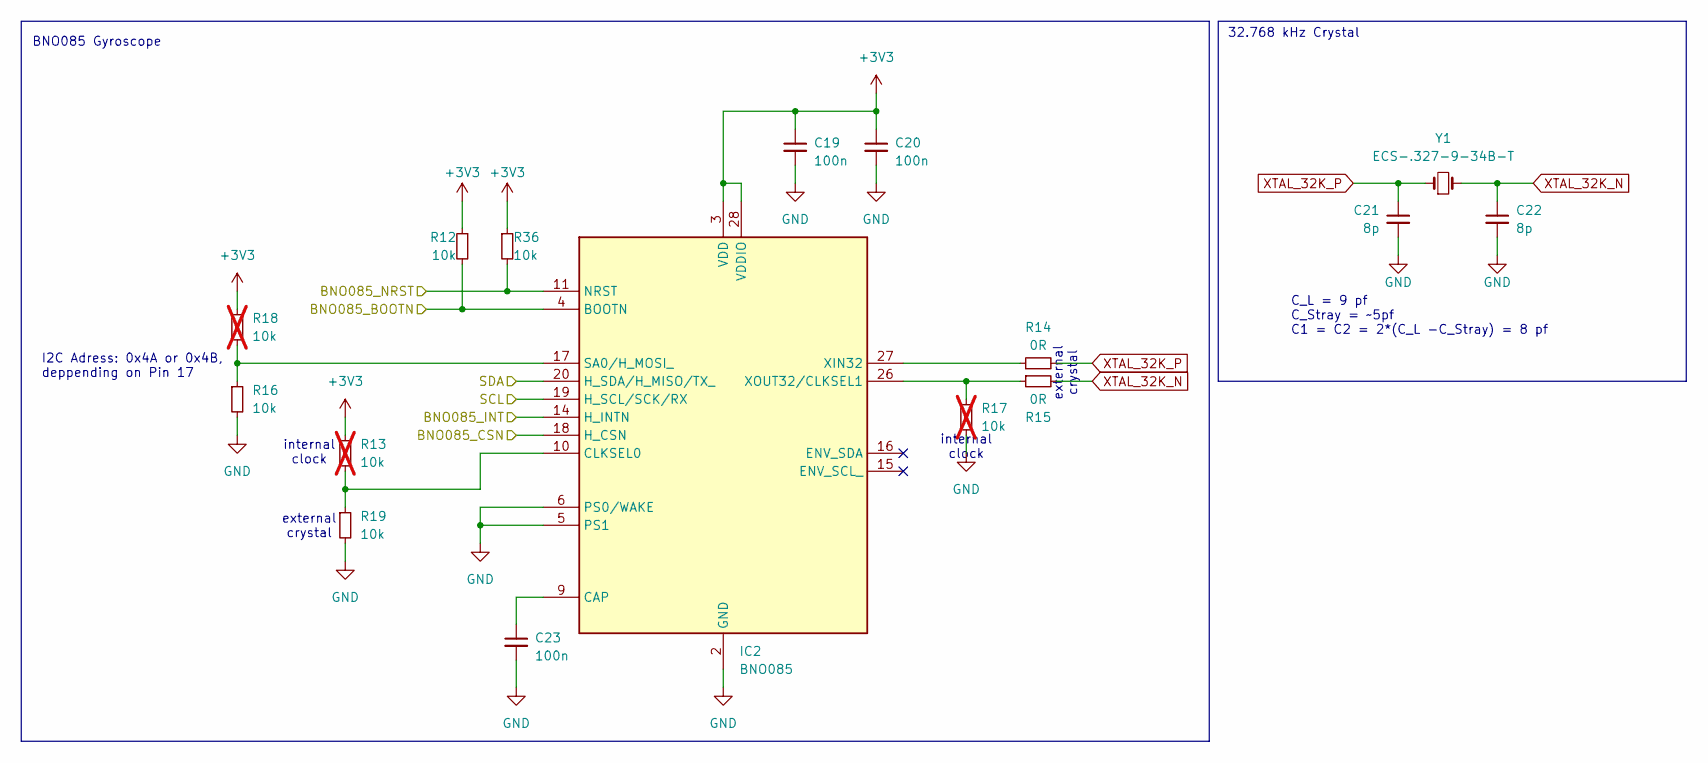
[picture p33: schematic gyro.kicad_sch]

Parts:
C19, C20, C23: 100n; C_0603_1608Metric; LCSC C14663
C21, C22: 8p; C_0603_1608Metric
IC2: BNO085
R12, R16, R19, R36: 10k; R_0603_1608Metric; LCSC C98220
R13, R17, R18: 10k; R_0603_1608Metric; LCSC C98220; not fitted
R14, R15: 0R; R_0603_1608Metric; LCSC C95177
Y1: ECS-.327-9-34B-T; LCSC C387600

Connections:
+3V3: C19.1, C20.1, IC2.3 (VDD), IC2.28 (VDDIO), R12.1, R13.1, R18.1, R36.1; also elsewhere on the board
/ADC/SCL: IC2.19 (H_SCL/SCK/RX); also elsewhere on the board
/ADC/SDA: IC2.20 (H_SDA/H_MISO/TX_); also elsewhere on the board
/ESP32/BNO085_BOOTN: IC2.4 (BOOTN), R12.2; also elsewhere on the board
/ESP32/BNO085_CSN: IC2.18 (H_CSN); also elsewhere on the board
/ESP32/BNO085_INT: IC2.14 (H_INTN); also elsewhere on the board
/ESP32/BNO085_NRST: IC2.11 (NRST), R36.2; also elsewhere on the board
GND: C19.2, C20.2, C21.2, C22.2, C23.2, IC2.2 (GND), IC2.5 (PS1), IC2.6 (PS0/WAKE), IC2.25 (GND_2), R16.2, R17.2, R19.2; also elsewhere on the board
unnamed: C23.1, IC2.9 (CAP)
unnamed: IC2.10 (CLKSEL0), R13.2, R19.1
unnamed: IC2.17 (SA0/H_MOSI_), R16.1, R18.2
unnamed: IC2.27 (XIN32), R14.1
unnamed: IC2.26 (XOUT32/CLKSEL1), R15.1, R17.1
XTAL_32K_N: C22.1, R15.2, Y1.2
XTAL_32K_P: C21.1, R14.2, Y1.1

Notes on the sheet:
32.768 kHz Crystal
BNO085 Gyroscope
internal clock
I2C Adress: 0x4A or 0x4B, deppending on Pin 17
external crystal
C_L = 9 pf C_Stray = ~5pf C1 = C2 = 2*(C_L -C_Stray) = 8 pf

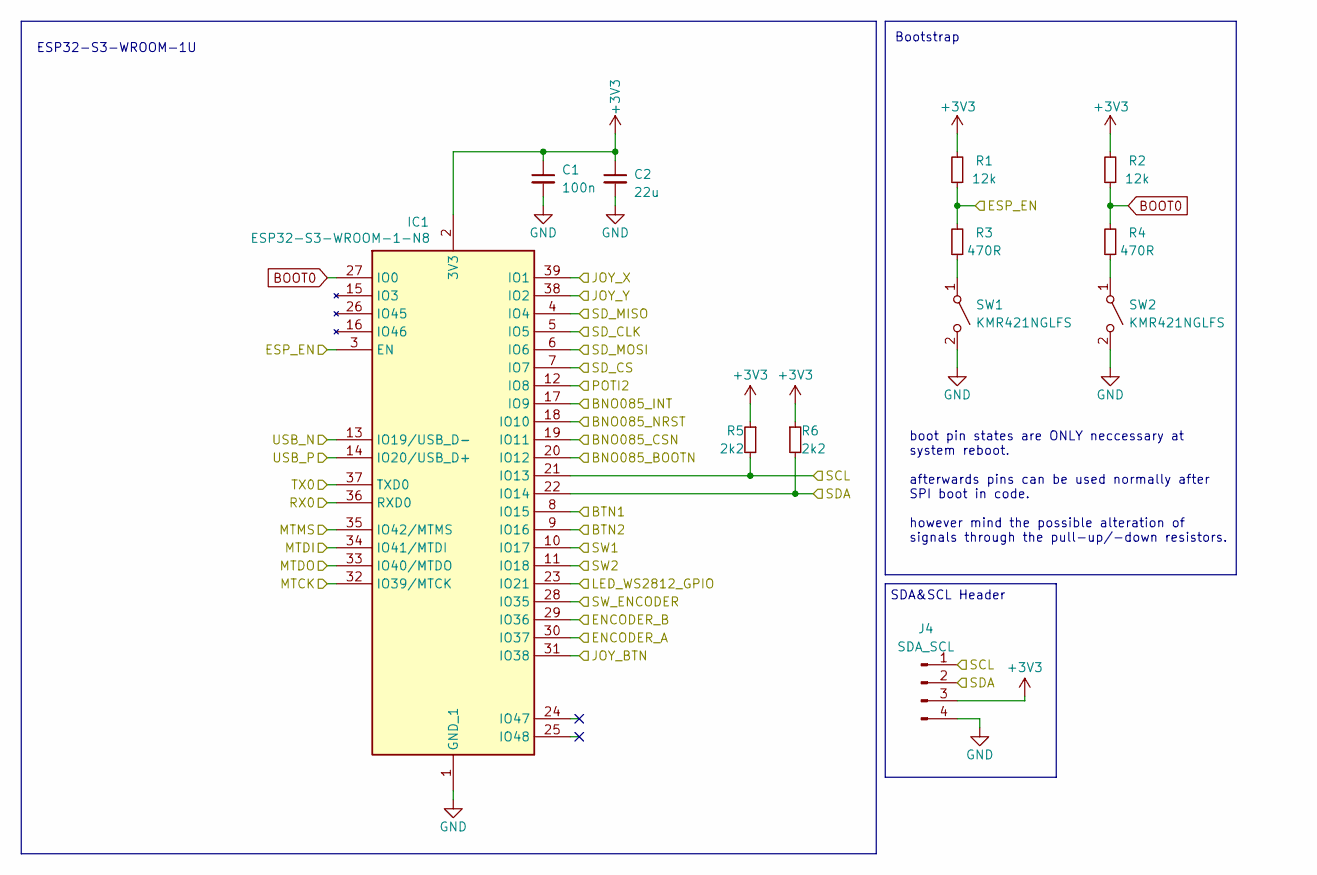
[picture p34: schematic esp32.kicad_sch]

Parts:
C1: 100n; C_0603_1608Metric; LCSC C14663
C2: 22u; C_0603_1608Metric; LCSC C109448
IC1: ESP32-S3-WROOM-1-N8; ESP32S3WROOM1N8R8; LCSC C2913198
J4: SDA_SCL; PinHeader_1x04_P2.54mm_Vertical; LCSC C2691448
R1, R2: 12k; R_0603_1608Metric; LCSC C114659
R3, R4: 470R; R_0603_1608Metric; LCSC C114669
R5, R6: 2k2; R_0603_1608Metric; LCSC C114662
SW1, SW2: KMR421NGLFS; LCSC C221687

Connections:
+3V3: C1.1, C2.1, IC1.2 (3V3), J4.3, R1.2, R2.2, R5.1, R6.1; also elsewhere on the board
/ADC/SCL: IC1.21 (IO13), J4.1, R5.2; also elsewhere on the board
/ADC/SDA: IC1.22 (IO14), J4.2, R6.2; also elsewhere on the board
/Debug/ESP_EN: IC1.3 (EN), R1.1, R3.2; also elsewhere on the board
/Debug/MTCK: IC1.32 (IO39/MTCK); also elsewhere on the board
/Debug/MTDI: IC1.34 (IO41/MTDI); also elsewhere on the board
/Debug/MTDO: IC1.33 (IO40/MTDO); also elsewhere on the board
/Debug/MTMS: IC1.35 (IO42/MTMS); also elsewhere on the board
/Debug/RX0: IC1.36 (RXD0); also elsewhere on the board
/Debug/TX0: IC1.37 (TXD0); also elsewhere on the board
/Debug/USB_N: IC1.13 (IO19/USB_D-); also elsewhere on the board
/Debug/USB_P: IC1.14 (IO20/USB_D+); also elsewhere on the board
/ESP32/BNO085_BOOTN: IC1.20 (IO12); also elsewhere on the board
/ESP32/BNO085_CSN: IC1.19 (IO11); also elsewhere on the board
/ESP32/BNO085_INT: IC1.17 (IO9); also elsewhere on the board
/ESP32/BNO085_NRST: IC1.18 (IO10); also elsewhere on the board
/ESP32/BTN1: IC1.8 (IO15); also elsewhere on the board
/ESP32/BTN2: IC1.9 (IO16); also elsewhere on the board
/ESP32/ENCODER_A: IC1.30 (IO37); also elsewhere on the board
/ESP32/ENCODER_B: IC1.29 (IO36); also elsewhere on the board
/ESP32/JOY_BTN: IC1.31 (IO38); also elsewhere on the board
/ESP32/JOY_X: IC1.39 (IO1); also elsewhere on the board
/ESP32/JOY_Y: IC1.38 (IO2); also elsewhere on the board
/ESP32/LED_WS2812_GPIO: IC1.23 (IO21); also elsewhere on the board
/ESP32/POTI2: IC1.12 (IO8); also elsewhere on the board
/ESP32/SD_CLK: IC1.5 (IO5); also elsewhere on the board
/ESP32/SD_CS: IC1.7 (IO7); also elsewhere on the board
/ESP32/SD_MISO: IC1.4 (IO4); also elsewhere on the board
/ESP32/SD_MOSI: IC1.6 (IO6); also elsewhere on the board
/ESP32/SW1: IC1.10 (IO17); also elsewhere on the board
/ESP32/SW2: IC1.11 (IO18); also elsewhere on the board
/ESP32/SW_ENCODER: IC1.28 (IO35); also elsewhere on the board
BOOT0: IC1.27 (IO0), R2.1, R4.2
GND: C1.2, C2.2, IC1.1 (GND_1), IC1.40 (GND_2), IC1.41 (GND_3), IC1.42 (GND_4), IC1.43 (GND_5), IC1.44 (GND_6), IC1.45 (GND_7), IC1.46 (GND_8), IC1.47 (GND_9), IC1.48 (GND_10), IC1.49 (GND_11), J4.4, SW1.2 (B), SW2.2 (B); also elsewhere on the board
unnamed: R3.1, SW1.1 (A)
unnamed: R4.1, SW2.1 (A)

Notes on the sheet:
boot pin states are ONLY neccessary at system reboot. afterwards pins can be used normally after SPI boot in code. however mind the possible alteration of signals through the pull-up/-down resistors.
ESP32-S3-WROOM-1U
Bootstrap
SDA&SCL Header

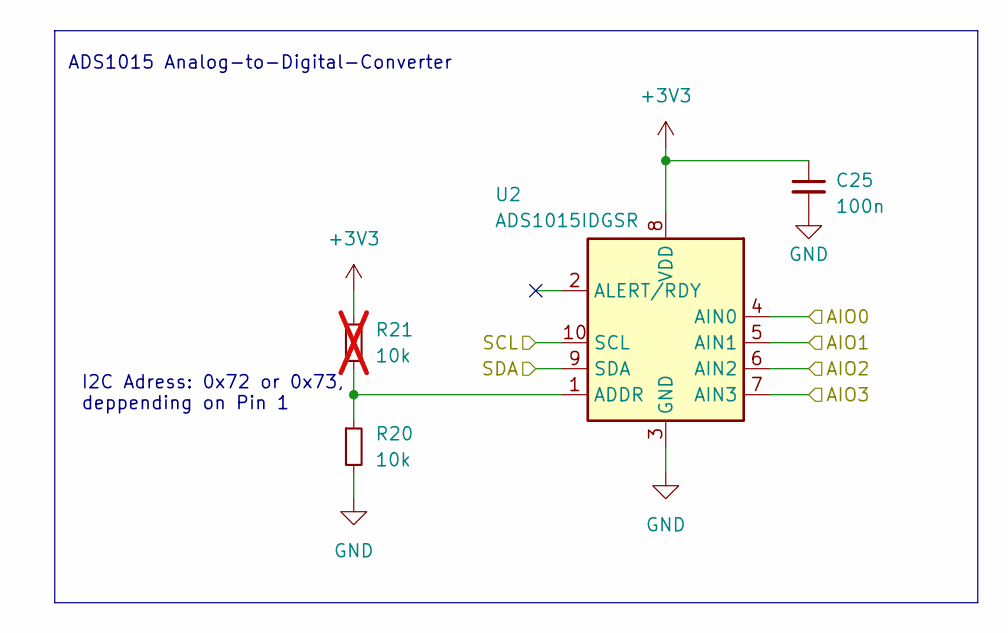
[picture p35: schematic adc.kicad_sch]

Parts:
C25: 100n; C_0603_1608Metric; LCSC C14663
R20: 10k; R_0603_1608Metric; LCSC C98220
R21: 10k; R_0603_1608Metric; LCSC C98220; not fitted
U2: ADS1015IDGSR; LCSC C193969

Connections:
+3V3: C25.1, R21.1, U2.8 (VDD); also elsewhere on the board
/ADC/AIO0: U2.4 (AIN0); also elsewhere on the board
/ADC/AIO1: U2.5 (AIN1); also elsewhere on the board
/ADC/AIO2: U2.6 (AIN2); also elsewhere on the board
/ADC/AIO3: U2.7 (AIN3); also elsewhere on the board
/ADC/SCL: U2.10 (SCL); also elsewhere on the board
/ADC/SDA: U2.9 (SDA); also elsewhere on the board
GND: C25.2, R20.2, U2.3 (GND); also elsewhere on the board
unnamed: R20.1, R21.2, U2.1 (ADDR)

Notes on the sheet:
ADS1015 Analog-to-Digital-Converter
I2C Adress: 0x72 or 0x73, deppending on Pin 1

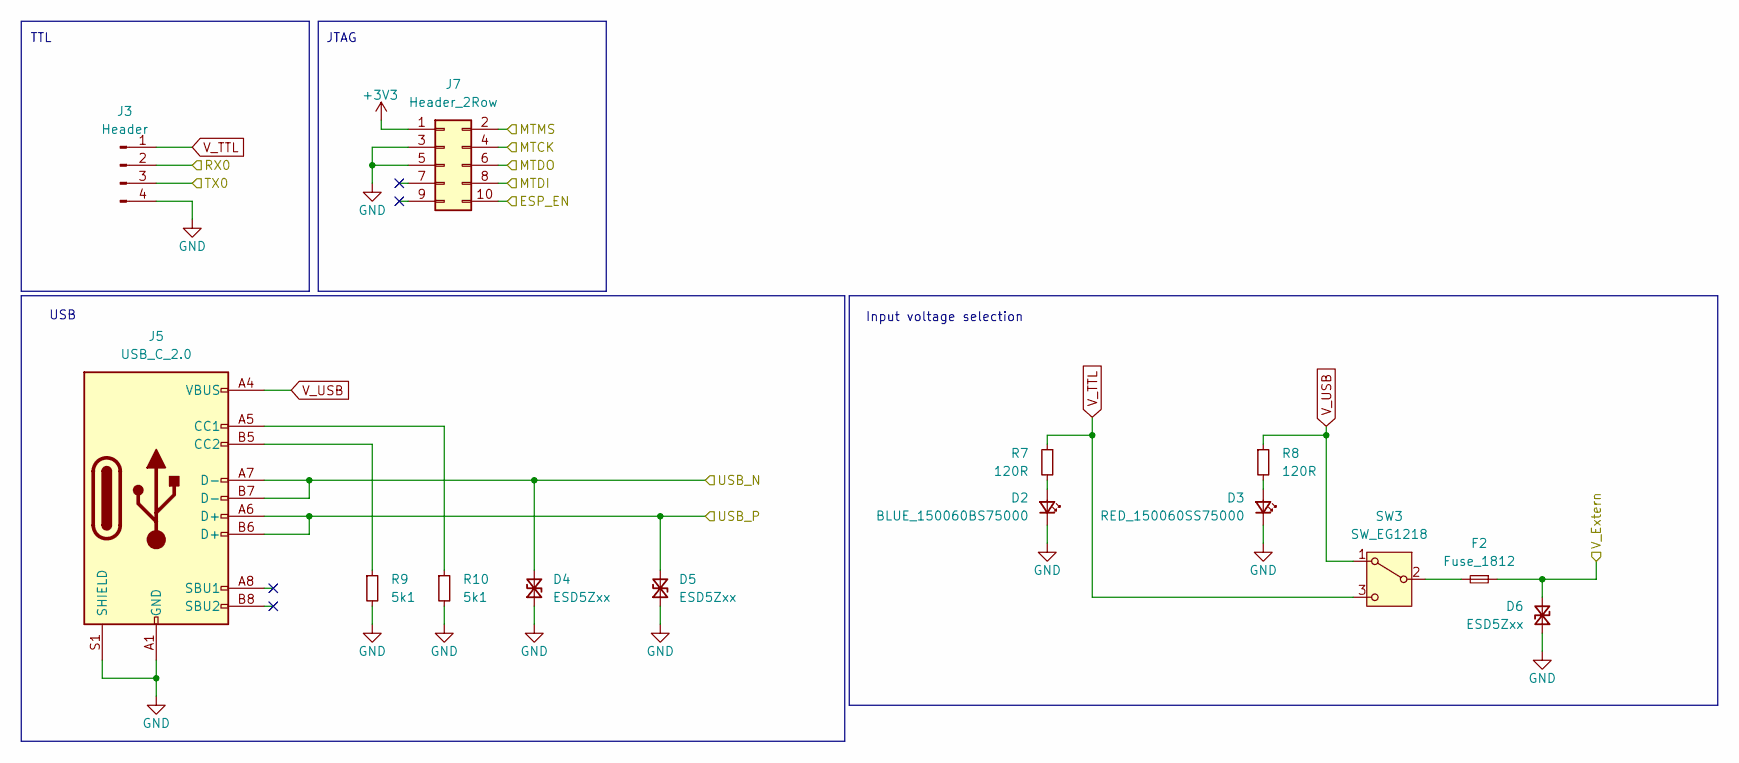
[picture p36: schematic debug.kicad_sch]

Parts:
D2: BLUE_150060BS75000; D_0603_1608Metric; LCSC C965807
D3: RED_150060SS75000; D_0603_1608Metric; LCSC C965799
D4, D5, D6: ESD5Zxx; D_SOD-523; LCSC C383211
F2: Fuse_1812; Fuse_1812_4532Metric; LCSC C883155
J3: Header; PinHeader_1x04_P2.54mm_Vertical; LCSC C2691448
J5: USB_C_2.0; USB-C; LCSC C5117882
J7: Header_2Row; PinHeader_2x05_P1.27mm_Vertical; LCSC C7501289
R7, R8: 120R; R_0603_1608Metric; LCSC C114640
R9, R10: 5k1; R_0603_1608Metric; LCSC C105580
SW3: SW_EG1218; EG1218; LCSC C2848901

Connections:
+3V3: J7.1; also elsewhere on the board
/Debug/ESP_EN: J7.10; also elsewhere on the board
/Debug/MTCK: J7.4; also elsewhere on the board
/Debug/MTDI: J7.8; also elsewhere on the board
/Debug/MTDO: J7.6; also elsewhere on the board
/Debug/MTMS: J7.2; also elsewhere on the board
/Debug/RX0: J3.2; also elsewhere on the board
/Debug/TX0: J3.3; also elsewhere on the board
/Debug/USB_N: D4.2 (A2), J5.A7 (D-), J5.B7 (D-); also elsewhere on the board
/Debug/USB_P: D5.2 (A2), J5.A6 (D+), J5.B6 (D+); also elsewhere on the board
/Debug/V_Extern: D6.2 (A2), F2.1; also elsewhere on the board
GND: D2.1 (K), D3.1 (K), D4.1 (A1), D5.1 (A1), D6.1 (A1), J3.4, J5.A1 (GND), J5.A12 (GND), J5.S1 (SHIELD), J7.3, J7.5, R9.2, R10.2; also elsewhere on the board
unnamed: D2.2 (A), R7.2
unnamed: D3.2 (A), R8.2
unnamed: J5.A5 (CC1), R10.1
unnamed: J5.B5 (CC2), R9.1
unnamed: F2.2, SW3.2 (B)
V_TTL: J3.1, R7.1, SW3.3 (C)
V_USB: J5.A4 (VBUS), J5.A9 (VBUS), R8.1, SW3.1 (A)

Notes on the sheet:
USB
JTAG
TTL
Input voltage selection

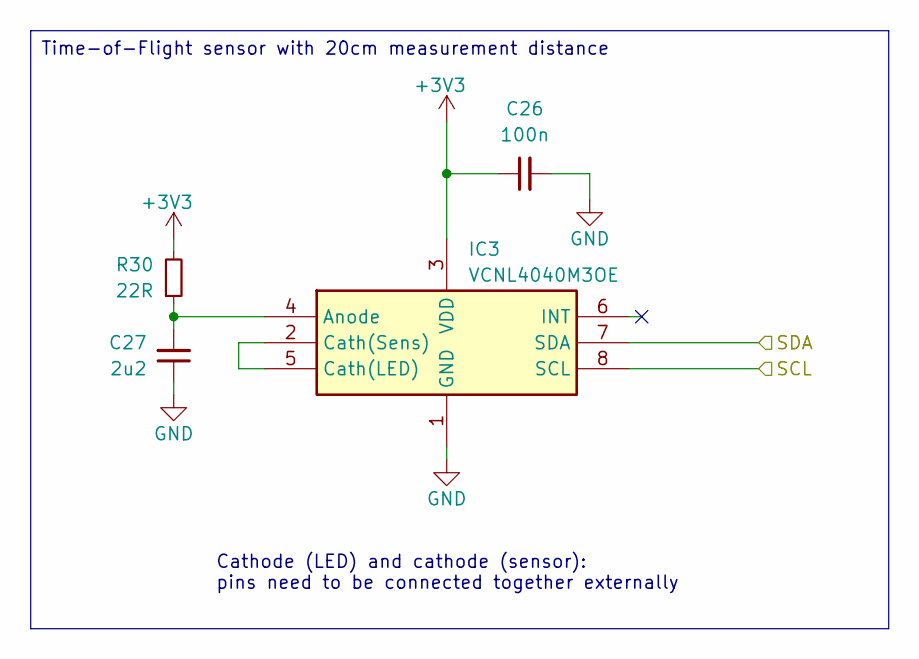
[picture p37: schematic Tof.kicad_sch]

Parts:
C26: 100n; C_0603_1608Metric; LCSC C14663
C27: 2u2; C_0603_1608Metric; LCSC C309478
IC3: VCNL4040M3OE; LCSC C142526
R30: 22R; R_0603_1608Metric; LCSC C107701

Connections:
+3V3: C26.1, IC3.3 (VDD), R30.2; also elsewhere on the board
/ADC/SCL: IC3.8 (SCL); also elsewhere on the board
/ADC/SDA: IC3.7 (SDA); also elsewhere on the board
GND: C26.2, C27.1, IC3.1 (GND); also elsewhere on the board
unnamed: C27.2, IC3.4 (Anode), R30.1
unnamed: IC3.2 (Cath(Sens)), IC3.5 (Cath(LED))

Notes on the sheet:
Cathode (LED) and cathode (sensor): pins need to be connected together externally
Time-of-Flight sensor with 20cm measurement distance

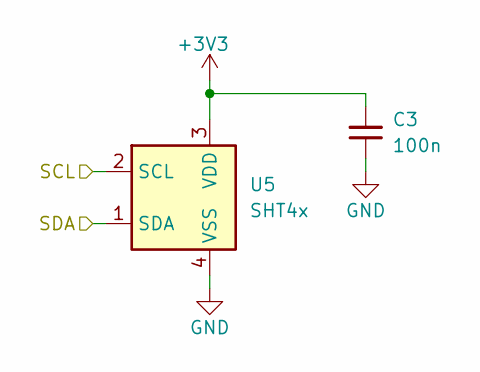
[picture p38: schematic SHT4x.kicad_sch]

Parts:
C3: 100n; C_0603_1608Metric; LCSC C14663
U5: SHT4x; Sensirion_DFN-4_1.5x1.5mm_P0.8mm_SHT4x_NoCentralPad

Connections:
+3V3: C3.2, U5.3 (VDD); also elsewhere on the board
/ADC/SCL: U5.2 (SCL); also elsewhere on the board
/ADC/SDA: U5.1 (SDA); also elsewhere on the board
GND: C3.1, U5.4 (VSS); also elsewhere on the board

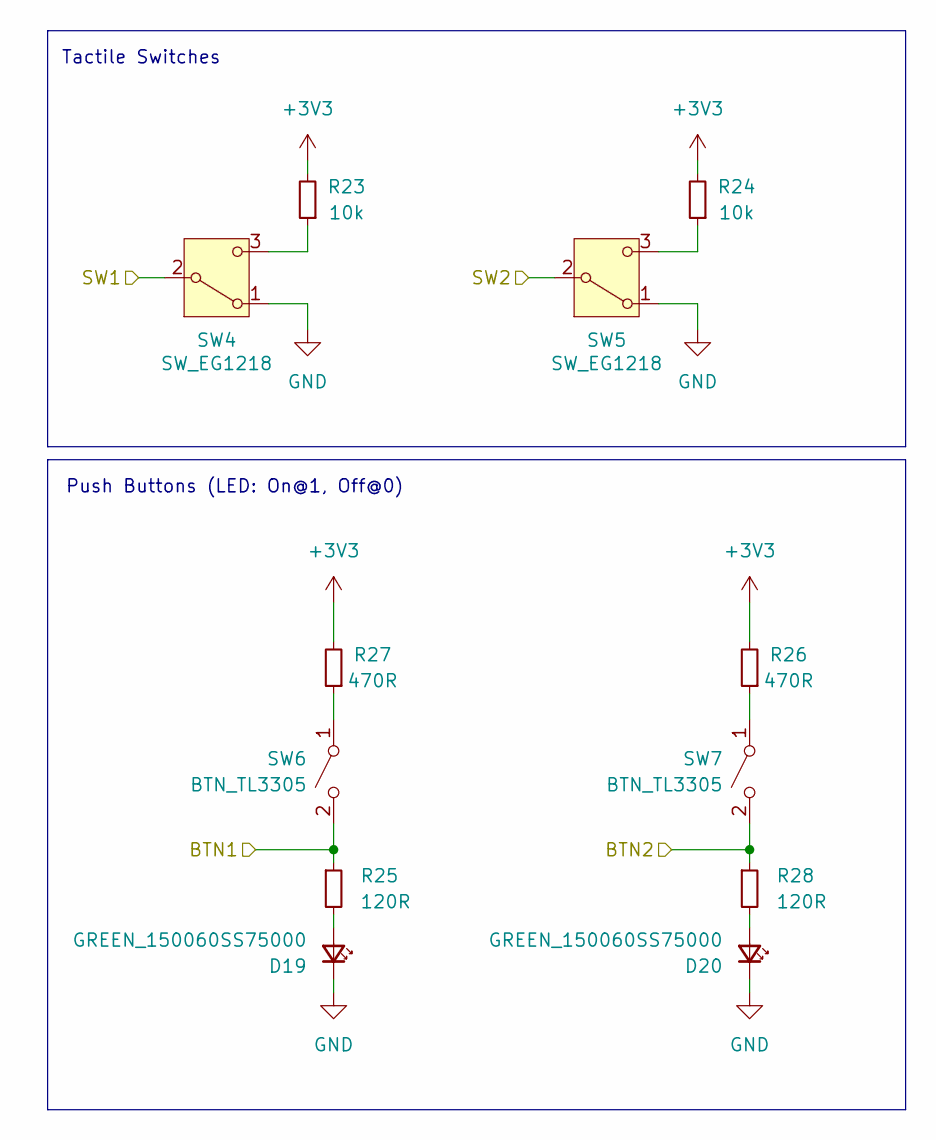
[picture p39: schematic human_interface.kicad_sch]

Parts:
D19, D20: GREEN_150060SS75000; D_0603_1608Metric; LCSC C19171301
R23, R24: 10k; R_0603_1608Metric; LCSC C98220
R25, R28: 120R; R_0603_1608Metric; LCSC C114640
R26, R27: 470R; R_0603_1608Metric; LCSC C114669
SW4, SW5: SW_EG1218; EG1218; LCSC C2848901
SW6, SW7: BTN_TL3305; SW_SPST_TL3305A; LCSC C410371

Connections:
+3V3: R23.2, R24.2, R26.2, R27.2; also elsewhere on the board
/ESP32/BTN1: R25.1, SW6.2 (B); also elsewhere on the board
/ESP32/BTN2: R28.1, SW7.2 (B); also elsewhere on the board
/ESP32/SW1: SW4.2 (B); also elsewhere on the board
/ESP32/SW2: SW5.2 (B); also elsewhere on the board
GND: D19.1 (K), D20.1 (K), SW4.1 (A), SW5.1 (A); also elsewhere on the board
unnamed: D19.2 (A), R25.2
unnamed: D20.2 (A), R28.2
unnamed: R23.1, SW4.3 (C)
unnamed: R24.1, SW5.3 (C)
unnamed: R27.1, SW6.1 (A)
unnamed: R26.1, SW7.1 (A)

Notes on the sheet:
Push Buttons (LED: On@1, Off@0)
Tactile Switches

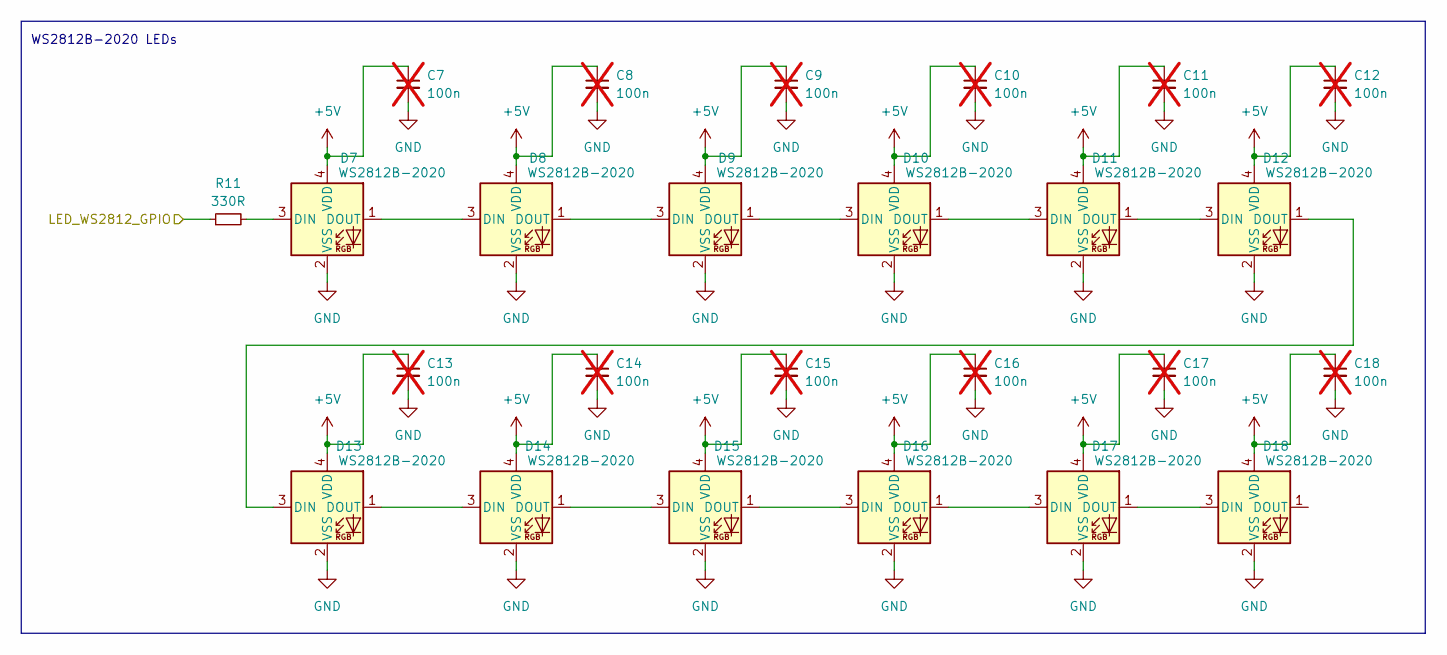
[picture p40: schematic led.kicad_sch]

Parts:
C7, C8, C9, C10, C11, C12, C13, C14, C15, C16, C17, C18: 100n; C_0603_1608Metric; LCSC C14663; not fitted
D7, D8, D9, D10, D11, D12, D13, D14, D15, D16, D17, D18: WS2812B-2020; LED_WS2812B-2020_PLCC4_2.0x2.0mm; LCSC C965555
R11: 330R; R_0603_1608Metric; LCSC C105881

Connections:
+5V: C7.1, C8.1, C9.1, C10.1, C11.1, C12.1, C13.1, C14.1, C15.1, C16.1, C17.1, C18.1, D7.4 (VDD), D8.4 (VDD), D9.4 (VDD), D10.4 (VDD), D11.4 (VDD), D12.4 (VDD), D13.4 (VDD), D14.4 (VDD), D15.4 (VDD), D16.4 (VDD), D17.4 (VDD), D18.4 (VDD); also elsewhere on the board
/ESP32/LED_WS2812_GPIO: R11.1; also elsewhere on the board
GND: C7.2, C8.2, C9.2, C10.2, C11.2, C12.2, C13.2, C14.2, C15.2, C16.2, C17.2, C18.2, D7.2 (VSS), D8.2 (VSS), D9.2 (VSS), D10.2 (VSS), D11.2 (VSS), D12.2 (VSS), D13.2 (VSS), D14.2 (VSS), D15.2 (VSS), D16.2 (VSS), D17.2 (VSS), D18.2 (VSS); also elsewhere on the board
unnamed: D7.3 (DIN), R11.2
unnamed: D7.1 (DOUT), D8.3 (DIN)
unnamed: D8.1 (DOUT), D9.3 (DIN)
unnamed: D9.1 (DOUT), D10.3 (DIN)
unnamed: D10.1 (DOUT), D11.3 (DIN)
unnamed: D11.1 (DOUT), D12.3 (DIN)
unnamed: D12.1 (DOUT), D13.3 (DIN)
unnamed: D13.1 (DOUT), D14.3 (DIN)
unnamed: D14.1 (DOUT), D15.3 (DIN)
unnamed: D15.1 (DOUT), D16.3 (DIN)
unnamed: D16.1 (DOUT), D17.3 (DIN)
unnamed: D17.1 (DOUT), D18.3 (DIN)

Notes on the sheet:
WS2812B-2020 LEDs

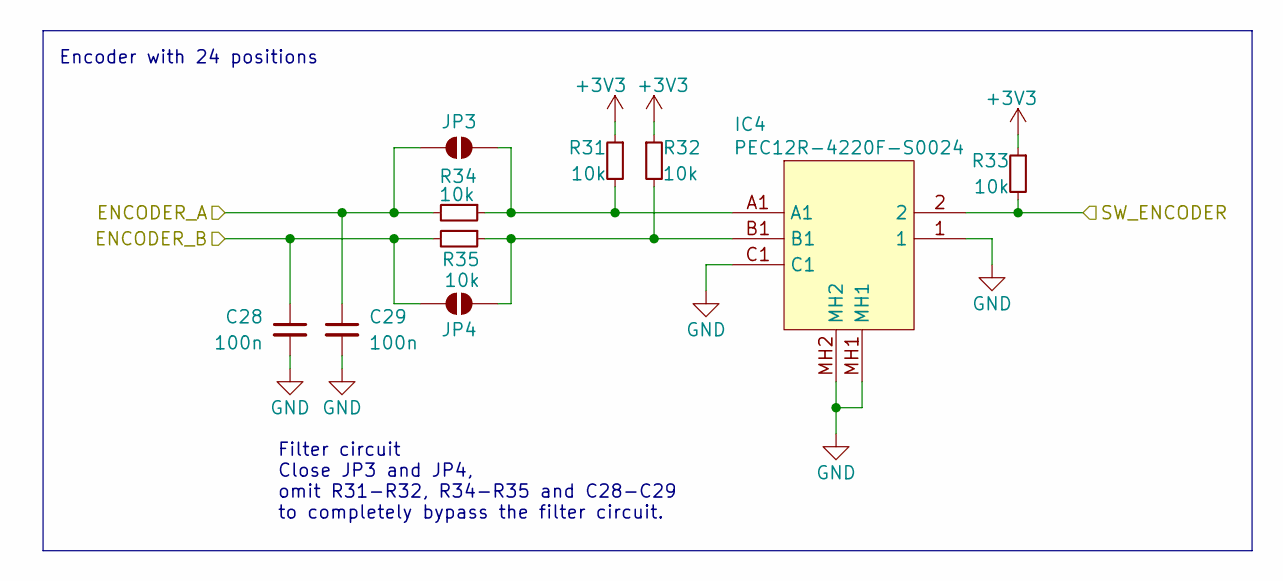
[picture p41: schematic encoder.kicad_sch]

Parts:
C28, C29: 100n; C_0603_1608Metric; LCSC C14663
IC4: PEC12R-4220F-S0024; PEC12R4220FS0024; LCSC C18164805
JP3, JP4: SolderJumper-2_P1.3mm_Open_TrianglePad1.0x1.5mm
R31, R32, R33, R34, R35: 10k; R_0603_1608Metric; LCSC C98220

Connections:
+3V3: R31.1, R32.1, R33.1; also elsewhere on the board
/ESP32/ENCODER_A: C29.1, JP3.1 (A), R34.2; also elsewhere on the board
/ESP32/ENCODER_B: C28.1, JP4.2 (B), R35.2; also elsewhere on the board
/ESP32/SW_ENCODER: IC4.2, R33.2; also elsewhere on the board
GND: C28.2, C29.2, IC4.1, IC4.C1, IC4.MH1, IC4.MH2; also elsewhere on the board
unnamed: IC4.A1, JP3.2 (B), R31.2, R34.1
unnamed: IC4.B1, JP4.1 (A), R32.2, R35.1

Notes on the sheet:
Encoder with 24 positions
Filter circuit Close JP3 and JP4, omit R31-R32, R34-R35 and C28-C29 to completely bypass the filter circuit.

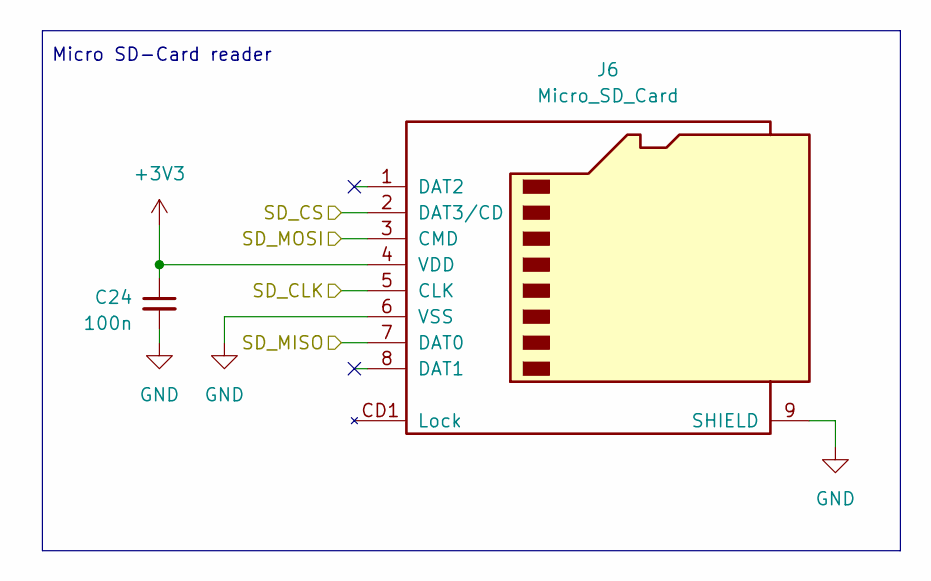
[picture p42: schematic sd.kicad_sch]

Parts:
C24: 100n; C_0603_1608Metric; LCSC C14663
J6: Micro_SD_Card; MSD1A; LCSC C393941

Connections:
+3V3: C24.1, J6.4 (VDD); also elsewhere on the board
/ESP32/SD_CLK: J6.5 (CLK); also elsewhere on the board
/ESP32/SD_CS: J6.2 (DAT3/CD); also elsewhere on the board
/ESP32/SD_MISO: J6.7 (DAT0); also elsewhere on the board
/ESP32/SD_MOSI: J6.3 (CMD); also elsewhere on the board
GND: C24.2, J6.6 (VSS), J6.9 (SHIELD); also elsewhere on the board

Notes on the sheet:
Micro SD-Card reader

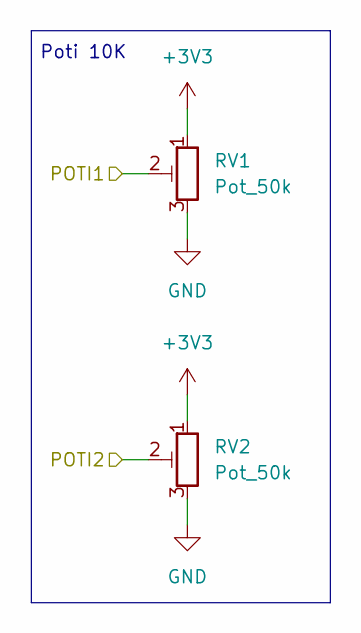
[picture p43: schematic poti.kicad_sch]

Parts:
RV1, RV2: Pot_50k; Potentiometer_Bourns_PTV09A-1_Single_Vertical; LCSC C5357831

Connections:
+3V3: RV1.1, RV2.1; also elsewhere on the board
/ADC/AIO3: RV1.2; also elsewhere on the board
/ESP32/POTI2: RV2.2; also elsewhere on the board
GND: RV1.3, RV2.3; also elsewhere on the board

Notes on the sheet:
Poti 10K
