Darexsh/mentoring_board_darexsh/Hardware/Project.kicad_pcb

## KiCad design Hardware/Project.kicad_pcb (continued)

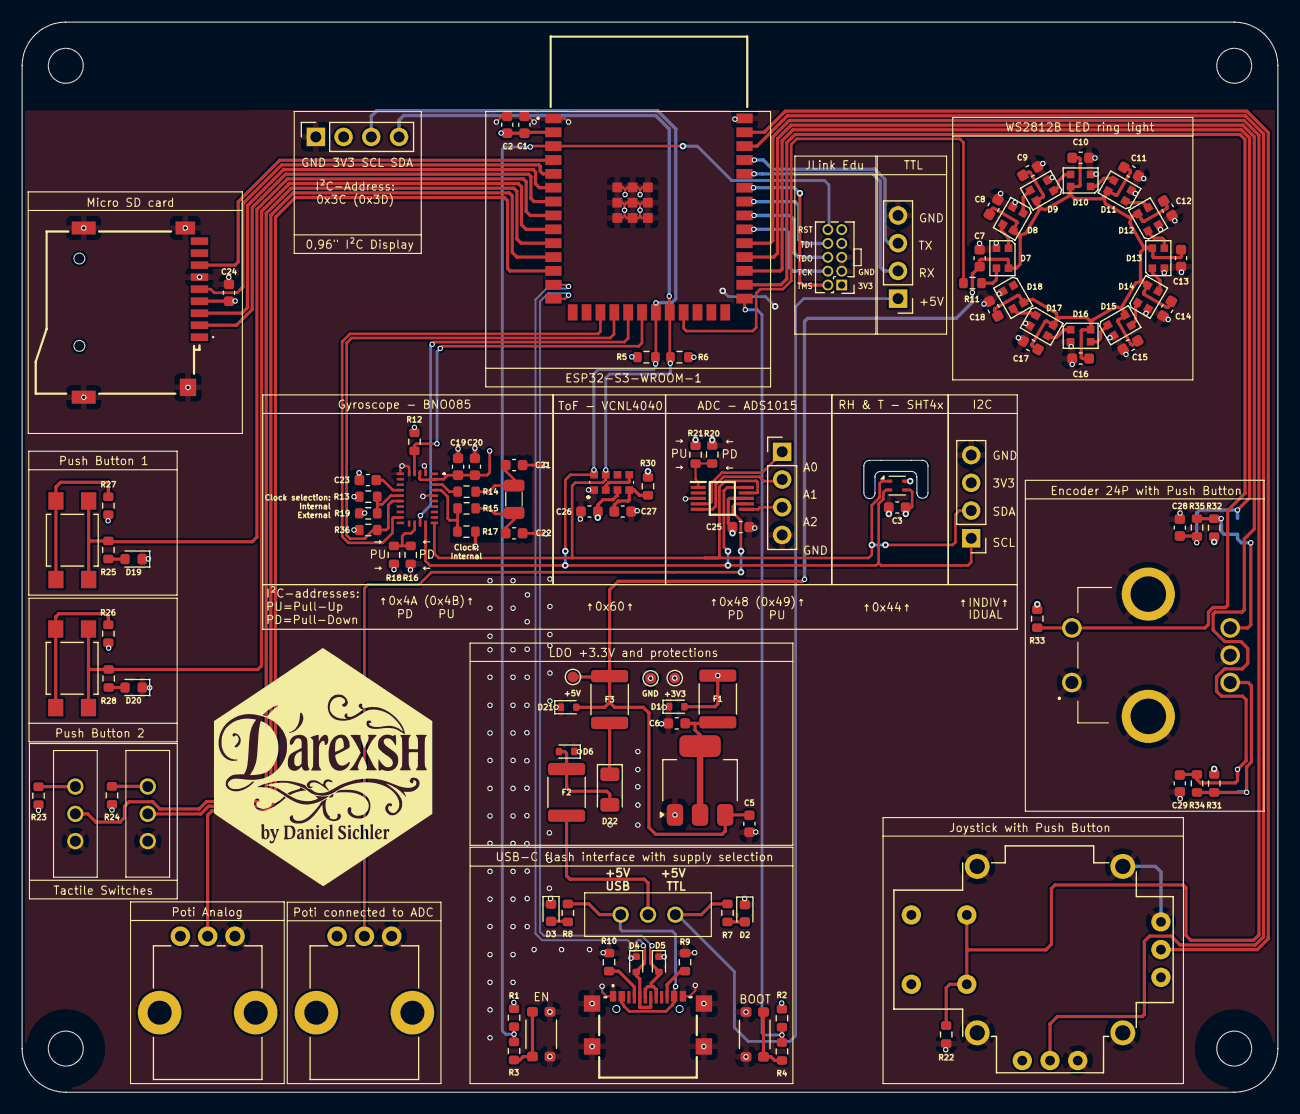
[picture p44: board Project.kicad_pcb from above]

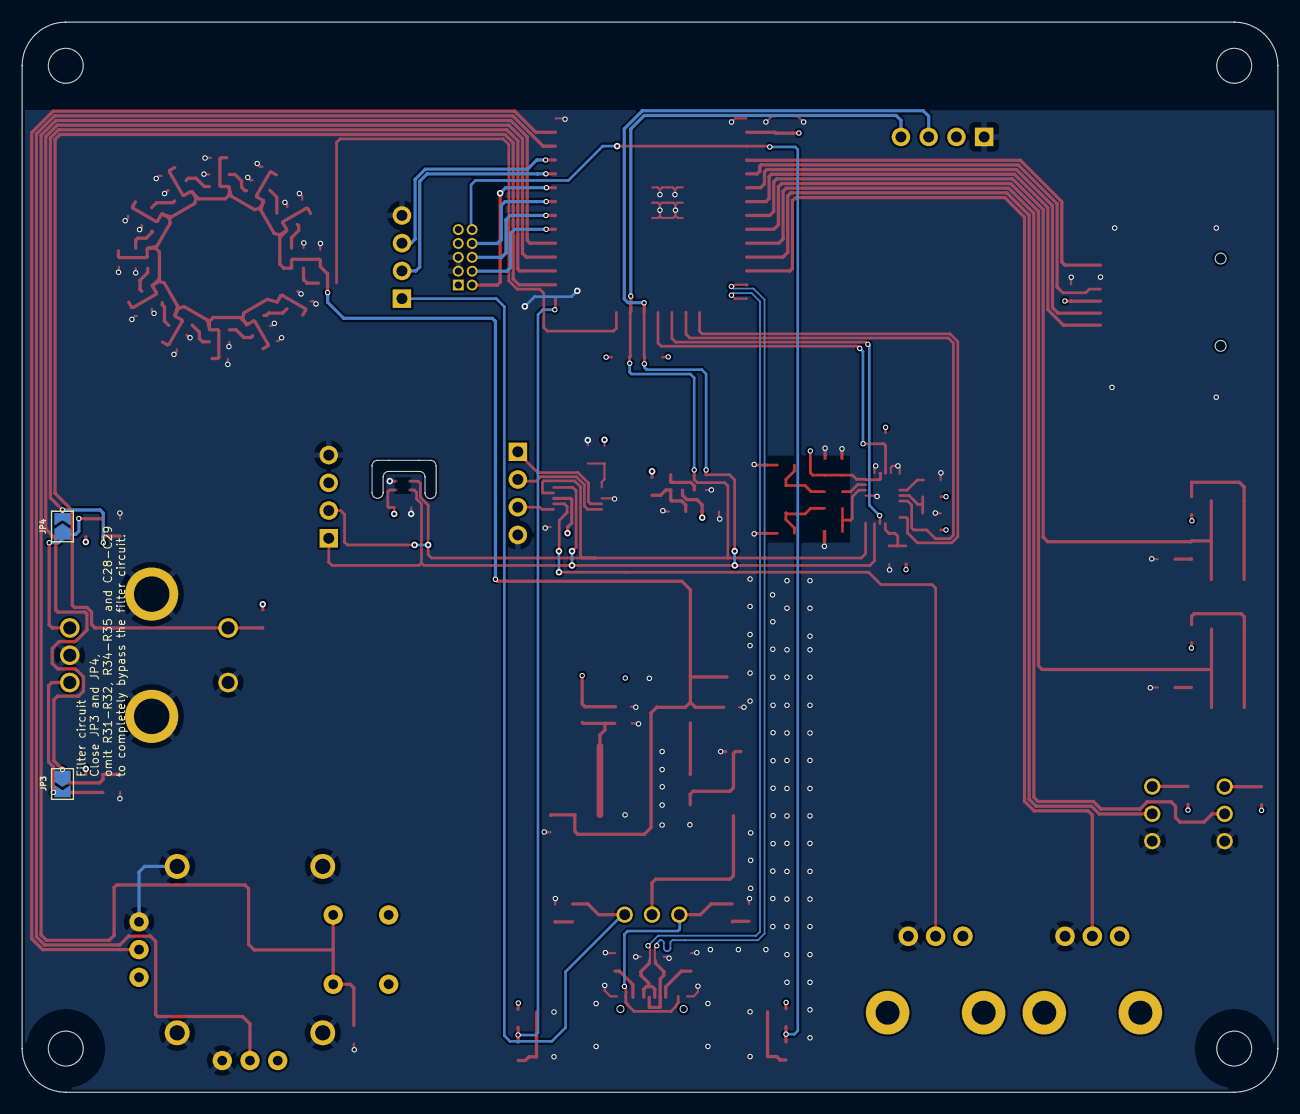
[picture p45: board Project.kicad_pcb from below]

Board: 4 copper layers, 115.0 x 98.0 mm, 122 parts (2 on the bottom side), 81 nets.
